royavidan/IOT-Project-study-assistor/README.md

## Study Assistor Project by : Taiyo Yemin, Maor Lisker, Roy Avidan
  
## Details about the project
 
## Folder description :
* ESP32: source code for the esp side (firmware).
* Documentation: wiring diagram + basic operating instructions
* Unit Tests: tests for individual hardware components (input / output devices)
* flutter_app : dart code for our Flutter app.
* Parameters: contains description of parameters and settings that can be modified IN YOUR CODE
* Assets: link to 3D printed parts, Audio files used in this project, Fritzing file for connection diagram (FZZ format) etc

## ESP32 SDK version used in this project: 

## Arduino/ESP32 libraries used in this project:
* Adafruit BusIO - version 1.17.4
* Adafruit GFX Library - version 1.12.6
* Adafruit SH110X - version 2.1.14
* Adafruit SSD1306 - version 2.5.17
* Adafruit_VL6180X - version 1.4.4

## Connection diagram:

## Project Poster:
 
This project is part of ICST - The Interdisciplinary Center for Smart Technologies, Taub Faculty of Computer Science, Technion
https://icst.cs.technion.ac.il/
