royavidan/IOT-Project-study-assistor/mindbox-companion-forge-main/README.md

# MindBox Companion

Web companion app for the MindBox focus device (TanStack Start + React + Supabase).

## Setup

1. Install dependencies: `npm install`
2. Copy `.env.example` to `.env` and fill in the values (Supabase URL/keys, app URL, device ingest secret).
3. Apply the database schema in the Supabase SQL Editor, in order:
   - `supabase/migrations/0001_init.sql` (tables, RLS, leaderboard RPC)
   - `supabase/migrations/0002_app_features.sql` (adaptive-coaching column + friend RPCs)
   - `supabase/migrations/0003_app_gaps.sql` (streak RPC, reviewer students, weekly share)
   - `supabase/migrations/0004_streak_access.sql` (secure streak RPC for reviewers)
   - `supabase/migrations/0005_google_oauth_profile.sql` (Google sign-in display names)
   - `supabase/migrations/0006_external_load.sql` (external load: lectures/labs → Recovery balance)
   - `supabase/migrations/0007_schedule_events.sql` (calendar: weekly classes + one-off events)
   - `supabase/migrations/0008_schedule_exams_semester.sql` (exam category + semester term)
   - `supabase/migrations/0009_schedule_subtype.sql` (lecture/tutorial/lab meeting type)

   Then reload the API cache by running `NOTIFY pgrst, 'reload schema';` once.
   The **Settings**, **Friends**, **Insights**, reviewer picker, and weekly email require `0002`–`0004`.

4. **Google sign-in:** In Supabase → **Authentication → Providers → Google**, enable Google and paste your Google Cloud **Client ID** and **Client Secret**. In Google Cloud Console, add this authorized redirect URI:
   `https://<your-project-ref>.supabase.co/auth/v1/callback`
   Also add **Redirect URLs** in Supabase → **Authentication → URL Configuration**:
   `http://localhost:8080/auth/callback` (and your production URL when deployed).
5. Start the dev server: `npm run dev` (serves `http://localhost:8080`).

## AI features (Gemini)

The **Smart (AI) study planner**, the **post-session check-in auto-replan**, and
the **daily load review** are powered by Gemini (`gemini-2.5-flash`):

1. Set `GEMINI_API_KEY` in `.env` (free key from https://aistudio.google.com/apikey)
   and `JOBS_SECRET` (any long random string), then restart the dev server.
2. Apply migrations `0020_llm_planner.sql` → `0021_session_checkin.sql` →
   `0022_device_sound_agenda.sql` → `0023_load_review.sql` in the SQL editor.
3. The daily load-review sweep is triggered by an external cron
   (`.github/workflows/load-review.yml` at the repo root — set the
   `APP_BASE_URL` + `JOBS_SECRET` repo secrets), or on demand from the
   Insights page ("Run review now").

Every assumption and threshold behind these features is documented in
[`docs/ASSUMPTIONS.md`](docs/ASSUMPTIONS.md) — read it before the demo.

## Site ↔ device features (remote control & live status)

Four features talk to the ESP32-S3 box over the ingest contract (migrations
`0024_device_commands.sql` → `0025_device_prefs_status.sql`, no new env vars):

- **Remote interface control** — the "MindBox device" card on `/settings` sets
  the box's screen theme (5 accent presets), pomodoro focus/break lengths and
  exam mode; the box picks them up on its next 60s config poll.
- **Remote commands** — the `/device` page can start/end a session, **ring the
  box** (find-my) and send a short message to its screen, with live
  Queued → Sent → Done status per command.
- **Live device status** — `/device` shows an online/last-seen indicator
  (90s threshold), battery, Wi-Fi, running firmware and the room right now
  (temperature/humidity/light/noise from the box's sensors).
- **On-device actions** — the box shows an exam badge + study streak, and after
  a finished session lets you bump homework progress from its touch screen
  (updates `/assignments` automatically).

Everything is testable without hardware — see the device-communication flags in
the simulator section below (`--config`, `--send-command`, `--ack`,
`--homework`).

## System guide (PDF)

[`docs/MindBox-System-Guide.pdf`](docs/MindBox-System-Guide.pdf) is the full
Hebrew system document (ESP32-S3 focused): every sensor's physics/wiring/driver,
the firmware architecture, the device↔server protocol, the engineering
lessons (brownout, I2C bus wars), and a **claim→live-proof playbook** for the
demo. Source chapters live in `docs/system-guide/*.html`; rebuild with
`bun run doc` (or `npx tsx scripts/build-system-doc.ts`).

## Tests

`npm run test` runs the Vitest unit suite (pure logic: Focus Load heuristic +
report/CSV serialization). `npm run test:watch` for watch mode.

> After changing **secrets** in `.env`, fully restart `npm run dev` — the dev
> server only reads `process.env` at startup.

## Device simulator

`scripts/simulator.ts` pretends to be a MindBox device so you can populate data
and exercise the app **without hardware**. It POSTs to the `/ingest/*` endpoints
using `DEVICE_INGEST_SECRET` and seeds a device owned by your app user, so the
data shows up on your dashboard/history.

**The dev server must be running first** (`npm run dev`).

```bash
# Seed a device + ~30 days of sessions, then stream telemetry (Ctrl+C to stop)
npm run simulate

# Scenarios
npm run simulate -- --offline-then-sync   # buffer sessions, then sync in one batch
npm run simulate -- --low-battery         # battery drains past 15% then 5%
npm run simulate -- --sensor-fault        # a sensor reports "invalid", state -> danger

# Handy options
npm run simulate -- --user=you@example.com  # attribute device to this user (default: first user)
npm run simulate -- --device=mindbox-sim-01 # device id
npm run simulate -- --seed-only             # seed + post sessions, then exit
npm run simulate -- --no-sessions           # telemetry only
npm run simulate -- --ticks=10 --interval=2000
```

Session IDs are deterministic (hashed from device + day + index), so the
ingestion upsert is idempotent — **re-running the simulator never creates
duplicate sessions**.

To remove simulator seed data and start with a clean dashboard:

```bash
npm run cleanup
```

Requires Node 18+ (run via `tsx`). On Node 22.18+ you can also run
`node scripts/simulator.ts` directly.
