royavidan/IOT-Project-study-assistor/Demo-Day-Pitch.md

# MindBox — Demo Day Pitch

חמש דקות, שישה שקפים, עברית.

> איך משתמשים בקובץ: זה הגיבוי הטקסטואלי של המצגת MindBox-Demo-Day-v2.pptx.
> שורות בתוך [ ] הן הערות לכם, הן לא נכנסות לשקף.

---

## שקופית 1 — הבעיה

**כותרת על השקף (הסיפור האישי של טאיו):**

> הייתי סטודנט שרוף
> עד שחשבתי לעזוב את הלימודים

**שורות (וזה לא רק אני — הנתונים):**

> 71% מהסטודנטים מדווחים על שחיקה · עלייה מ-40%
> ל-70% מאלה ששוקלים לנשור הסיבה מספר 1 היא מתח רגשי · יותר מעלות הלימודים
> ומחקרים מראים ששחיקה מנבאת ישירות כוונה לנשור
> זו לא בעיה של כוח רצון · אלא שגרה שבורה בלי הפסקות ובלי תחושת התקדמות

[פתיחה בעל פה, ~30 שניות, הסיפור שלך: ספר על תקופה אמיתית שבה נשרפת, איך זה פגע בלימודים,
ועל הרגע שבו באמת שקלת לעזוב. אל תמהר, שתיקה קצרה אחרי "לעזוב את הלימודים" עובדת. ואז:
"בדקתי, וזה לא רק אני."]
[מקורות לאימות: שחיקה 40%→71% — סקר Ohio State (Melnyk, 2021). מתח רגשי כסיבה מס' 1
לנשירה (70%) — Gallup-Lumina, State of Higher Education 2024. שחיקה מנבאת נשירה — PLOS One 2020.]
[גרף מוכן: presentation-assets/burnout-rise.png (עמודות 40% מול 71%). תמונה מומלצת: סטודנט
שחוק מול ערימת ספרים/מסך — חפשו ב-Unsplash "student burnout" / "exhausted studying".]

---

## שקופית 2 — הפתרון

**כותרת:**

> MindBox
> פוקוס בלי שחיקה

**שורות (איך זה שובר את מעגל השחיקה):**

> מחזורי עבודה והפסקה · ריכוז עמוק בלי לשרוף את עצמכם
> הקופסה מזכירה מתי לעצור · לא עוד שעות רצופות מול המסך
> רטט עדין מחזיר אתכם פנימה · במקום עוד התראה שמלחיצה
> באפליקציה רואים התקדמות אמיתית · פחות חרדת "אם בכלל הספקתי"

[הרעיון: כל פיצ'ר עונה על שורש אחר של שחיקה — עומס, חוסר הפסקות, הצפת התראות, חרדת
התקדמות. חברו חזרה לסיפור: "הקופסה הזו היא בדיוק מה שהייתי צריך אז".]
[תראו, אל תספרו: תמונה אמיתית של הקופסה + צילום מסך מהאפליקציה. אם אפשר, דמו חי של 15 שניות.]

---

## שקופית 3 — השוק

**כותרת:**

> אנשים שמתקשים להתרכז מול מסך
> וזה רק הולך וגדל

**שורות (מלמטה למעלה — שוק עולמי → ישראל → יעד ראשון):**

> בעולם · שוק כלי הפוקוס והפרודוקטיביות כ-10 מיליארד דולר וצומח כ-9% בשנה
> בישראל · כ-400 אלף סטודנטים ומיליוני עובדים שמבלים את היום מול מסך — בסיס רלוונטי של כ-800 אלף איש
> יעד ראשון · נתח של ~3% מהבסיס ≈ 24 אלף משתמשים × ₪300 ≈ כ-7 מיליון ₪ (לפני הכנסה מהאפליקציה)
> למה עכשיו · זמן הקשב הממוצע מול מסך צנח מ-2.5 דקות בשנת 2004 ל-47 שניות בשנת 2023

[נתון "למה עכשיו" הוא הנשק הסודי של השקף — הוא אמיתי, מאומת ומזעזע. אפשר לומר אותו בעל פה.]
[מקורות לאימות מול הקהל, לא על השקף:
 • סטודנטים ~401 אלף (תשפ"ד) — המועצה להשכלה גבוהה / הלמ"ס.
 • כוח עבודה ~4.7 מיליון — הבנק העולמי / הלמ"ס.
 • שוק פרודוקטיביות ~9–11 מיליארד דולר, צמיחה ~9% — Cognitive Market Research / Fortune Business Insights.
 • נתון הקשב (2.5 דק׳ → 47 שנ׳, ~23 דק׳ לחזור לריכוז) — פרופ' גלוריה מארק, UC Irvine.
 הרעיון: מספר קטן ואמיתי שנבנה מלמטה למעלה משכנע הרבה יותר מ"שוק של מיליארדים".]

---

## שקופית 4 — תחרות

**כותרת:**

> איך מתרכזים היום
> ולמה זה לא מספיק

**שורות — איך מתמודדים היום:**

> אפליקציות פוקוס חיות בטלפון · אותו מכשיר שמסיח אתכם מלכתחילה
> טיימר רגיל סופר דקות · אבל לא יודע אם באמת התרכזתם
> טלפון בחדר אחר או כוח רצון · הכי נפוץ והכי פחות מחזיק

**שורות — מה ש-MindBox עושה אחרת (וכבר עובד בקופסה):**

> קופסה על השולחן · לא עוד אפליקציה בטלפון
> קמתם לקפה? הקופסה מזהה ומשהה לבד · חזרתם והיא ממשיכה מאיפה שעצרתם · הזמן סופר ריכוז אמיתי ולא שעון קיר
> הקשב נשבר? רטט עדין על השולחן מחזיר אתכם פנימה · בלי עוד התראה ובלי מסך
> כל סשן מקבל ציון פוקוס · ובאפליקציה רואים מתי ואיפה אתם הכי חדים

[הפואנטה כאן רגשית, לא טכנית: לא עוד אפליקציה — חוויה פיזית על השולחן. בהצגה הדגישו שני רגעים
שאנשים "מרגישים": ההשהיה האוטומטית כשקמים, והרטט העדין שמחזיר. כל הפיצ'רים האלה כבר מוטמעים
ועובדים בקופסה היום — נוכחות (חיישן מרחק), רעש ותאורה, ציון פוקוס, וסנכרון לאפליקציה.]
[אל תגידו שאין לכם תחרות — זה דגל אדום. גם "לא לעשות כלום" זו תחרות, וכבר כללנו אותה.]

---

## שקופית 5 — הצוות

**כותרת:**

> בנינו את MindBox בעצמנו
> כי אנחנו חיים את הבעיה

**שורות:**

> טאיו ימין · מאור ליסקר · רועי אבידן
> טאיו נשרף בעצמו בלימודים — מכאן נולד MindBox
> בנינו הכול לבד · קופסה חיישנים ענן ואפליקציה
> אנחנו המשתמשים הראשונים · ויודעים בדיוק מה צריך לתקן

[אופציונלי: הוסיפו לכל אחד 2-3 מילות רקע (חומרה / תוכנה / עיצוב). התמקדו ב"למה אנחנו ולמה
עכשיו", לא בקורות חיים. בשלב מוקדם משקיעים באנשים יותר מבמוצר.]

---

## שקופית 6 — הבקשה

**כותרת:**

> מה אנחנו מחפשים:
> שותף ראשון שינסה את MindBox.

**שורות:**

> מי מתאים: צוות שעובד מרחוק, מרחב עבודה משותף, או קבוצת לומדים.
> מה נצטרך: בין עשרה לעשרים משתמשים, לכמה שבועות.
> מה כולם מרוויחים: הם מקבלים כלי פוקוס אמיתי, ואנחנו מקבלים משוב וסיפור הצלחה ראשון.

**משפט סיום (בעל פה, סוגר את המעגל לשקף הראשון):**

> שאף אחד לא יסיים עוד יום מול המסך בלי לדעת אם באמת עבד.

---

## לפני דמו דיי, מה להשלים

1. סיפור פתיחה (שקף 1): הכניסו רגע אמיתי משלכם אם יש.
2. צוות (שקף 5): שם או שמות, ושורת רקע אחת לכל אחד.
3. מספרי שוק (שקף 3): המספרים והמקורות כבר בפנים — רק לוודא שהם עדכניים לפני דמו דיי.
4. יצירת קשר (שקף סיום): מייל או טלפון.

## טיפים להצגה

- חמש דקות, גבול קשיח. תתאמנו בקול ותמדדו זמן.
- פשטות מנצחת בשקפים: מעט מילים, תמונה אמיתית אחת לשקף.
- 40 אחוז תוכן, 60 אחוז אתם: אנרגיה, קשר עין, טון.
