royavidan/IOT-Project-study-assistor/Documentation/connection diagram/sketch.png

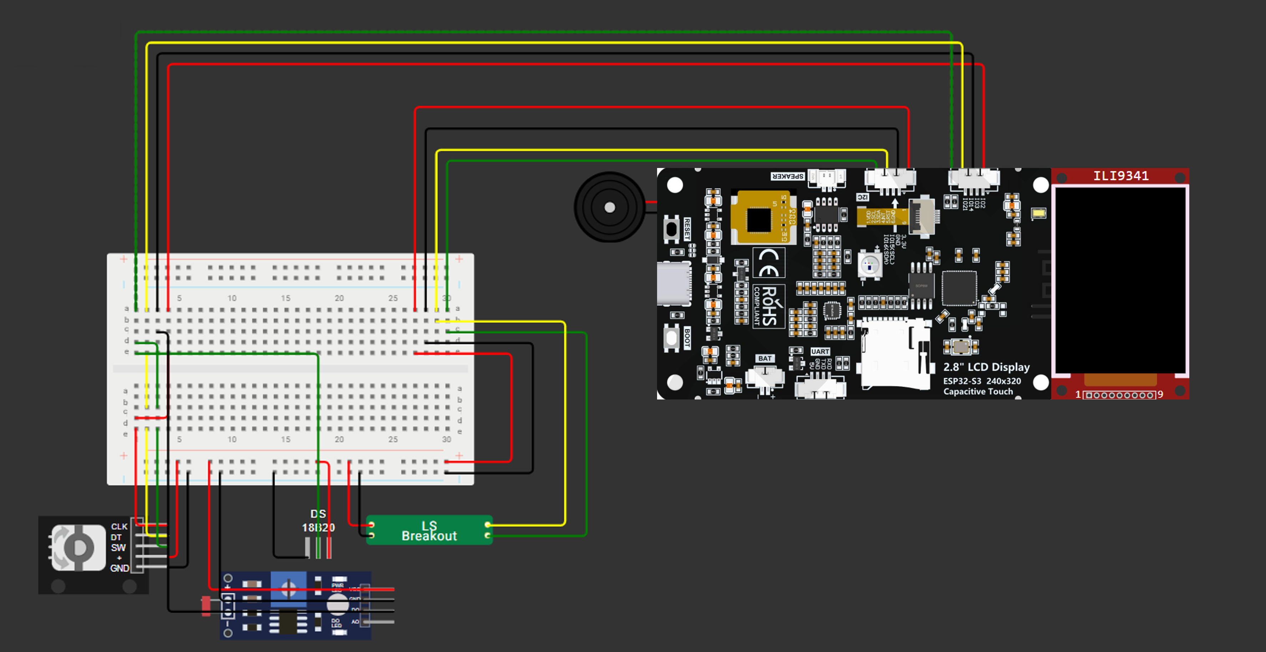
Documentation/connection diagram/sketch.png
