royavidan/IOT-Project-study-assistor/presentation-assets/burnout-rise.png

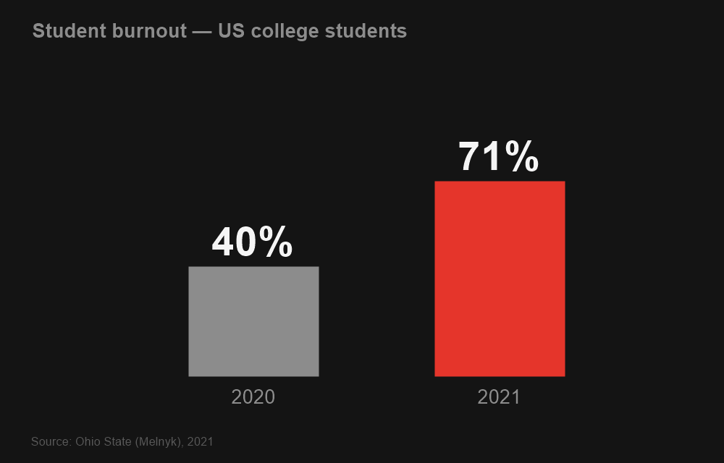
presentation-assets/burnout-rise.png
