royavidan/IOT-Project-study-assistor/presentation-assets/stress-70.png

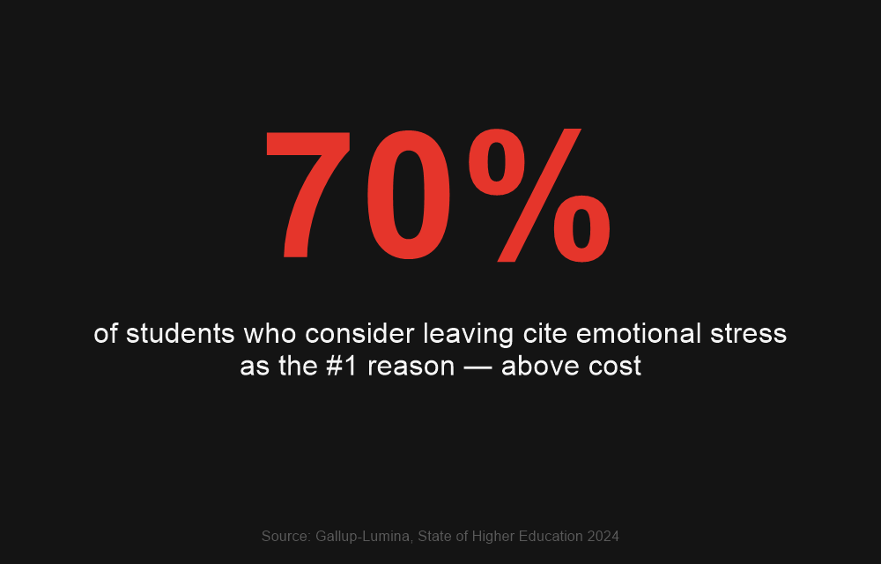
presentation-assets/stress-70.png
