royavidan/IOT-Project-study-assistor/mindbox-companion-forge-main/docs/MindBox-Submission-Guide.html

# MindBox

מדריך הגשה טכני מלא + תסריט הדגמה ל-30 דקות

פרויקט IoT · שעון פוקוס חכם על בסיס ESP32-S3
גרסת קושחה: 0.2.0-s3 · לוח: LCDWIKI ES3C28P/ES3N28P (ESP32-S3, מסך מגע 2.8")
צוות: Taiyo Yemin · Maor Lisker · Roy Avidan — Technion ICST

כל טענה חומרתית במסמך מלווה בהפניה מדויקת לקוד המקור (קובץ:שורה) ובדרך להוכיח אותה בזמן אמת מול הקהל.

# תוכן העניינים

1. הסיפור והארכיטקטורה — למה הפרויקט קיים, מה הוא, ואיך הוא בנוי
2. החומרה: הלוח, מפת הפינים המלאה והבאסים — הבנת ה-ESP32-S3 ב-100%
3. החיישנים וההתקנים — אחד-אחד — עיקרון, פרוטוקול, חיווט, דרייבר, קצב
4. ליבות ומשימות (Cores & Tasks) — מי רץ על איזו ליבה ולמה
5. למה המסך לא קורס — Single-writer sprite, DMA, וניהול זיכרון
6. תקלת הקישוריות ותיקון ה-pbuf_free — הבאג ש"אתחל את הקופסה כל כמה דקות"
7. Trade-offs ומשאבים משותפים — שיתוף IO21 (אנקודר↔טמפרטורה), באס I2C יחיד, ועוד
8. מקרי קצה וחוסן — ניתוק Wi-Fi, תקלות חיישן, שחזור I2C, brownout, offline
9. מכונת המצבים וזרימת הנתונים — 16 מצבים, מחזור חיי סשן, טלמטריה, צימוד
10. התקן ↔ ענן ↔ אתר — חוזה ה-ingest, אימות, והמסכים החיים באתר
11. דיאגנוסטיקה — איך מוכיחים כל טענה — Serial, self-test, מסך Diag
12. תסריט ההדגמה (30 דקות) + נספחים — טבלת טענה→הוכחה, run-of-show, וגיבוי סימולטור

איך לקרוא את המסמך: טקסט בעברית, אך שמות פינים, פונקציות, קבצים ומספרי-שורה נשארים באנגלית (LTR) כדי שיהיו מדויקים וניתנים לחיפוש בקוד. תיבה ירוקה (■) = "איך מוכיחים את זה"; תיבה כתומה (■) = הערה/סייג; תיבה אדומה (■) = מלכודת/כשל אמיתי שנתקלנו בו.

# 1. הסיפור והארכיטקטורה

במשפט אחד: MindBox היא קופסה פיזית על בסיס ESP32-S3 שמריצה סשני פוקוס (פומודורו), מודדת את סביבת הלימוד בזמן אמת (רעש, טמפרטורה, לחות, אור, נוכחות), ומסתנכרנת דו-כיוונית עם אפליקציית ווב — כולל עבודה מלאה גם ללא רשת. המכשיר מריץ שתי ליבות, חמישה חיישנים פעילים, מסך מגע, ושמע דו-כיווני (מיקרופון I2S + רמקול).

## 1.1 הבעיה שפתרנו

סטודנטים נכשלים לא מחוסר זמן אלא מחוסר פוקוס: הטלפון, הרעש, החדר החם, ואפס משוב על מה שבאמת קורה בזמן הלמידה. אפליקציות טיימר קיימות הן פסיביות — הן סופרות זמן אבל לא יודעות אם באמת למדת. MindBox הופכת את סביבת הלמידה למדידה: היא רואה אם אתה מול השולחן (ToF), שומעת אם החדר רועש (מיקרופון), יודעת אם חשוך או חם מדי (אור/טמפרטורה), ומחברת את כל זה ל"עומס פוקוס" (Focus Load) שמוצג בזמן אמת ונשמר לניתוח מאוחר באתר.

## 1.2 מסע ההנדסה: מ-OLED קלאסי ל-S3 עם מסך מגע

הפרויקט התחיל כקושחת ESP32 קלאסית (DOIT DevKit) עם מסך OLED קטן ואנקודר בלבד. ה"מוח" — מכונת המצבים, מחזור הסשן, והתפריטים (StateMachine / Session / Menu) — נכתב כך שהוא אגנוסטי לתצוגה: הוא מייצר ערך UiModel, והרנדרר מצייר אותו. בזכות זה הצלחנו לעשות port מלא ללוח ESP32-S3 חדש (LCDWIKI ES3C28P, מסך מגע צבעוני 2.8") כמעט בלי לגעת בלוגיקה: רק התצוגה (TFT SPI במקום OLED I2C) והקלט (מגע + אנקודר במקום אנקודר בלבד) השתנו. זהו הסיפור ההנדסי המרכזי — ארכיטקטורה נכונה מאפשרת החלפת חומרה שלמה בעלות מינימלית.

מקור: MindBox - hardware ESP32 S3 screen/MindBox/CLAUDE.md (סעיף "Context for this variant").

## 1.3 תמונת-על של המערכת

## 1.4 ששת ערוצי התקשורת

ערוץ | Route | כיוון | קצב | מה עובר
סשנים | POST /ingest/sessions | מכשיר → שרת | בסיום סשן (+ תור offline) | סשן מלא: זמנים, מצב, אגרגטים סביבתיים, דגימות לדקה
טלמטריה | POST /ingest/telemetry | מכשיר → שרת | כל 30 שניות (פעימת-לב) | מצב, סוללה, WiFi RSSI, תקינות חיישנים, טמפ'/לחות/אור/רעש חיים, גרסת קושחה
קונפיגורציה | GET /ingest/config | שרת → מכשיר | כל 60 שניות (3–5 בזמן צימוד) | הגדרות, לו"ז יומי+שבועי, ערכת צבעים, זמני פומודורו, מצב מבחן, סטריק, שיעורי בית, פקודה מרחוק
צימוד | POST /ingest/pairing | מכשיר → שרת | לפי דרישה | קוד 6 ספרות שהמכשיר מציג (תוקף 15 דק')
שחרור | POST /ingest/unpair | מכשיר → שרת | לפי דרישה | שחרור בעלות מהמכשיר ("Sign out")
שיעורי בית | POST /ingest/homework | מכשיר → שרת | לפי פעולה במסך המגע | עדכון אחוז התקדמות מטלה מהמכשיר

כל הערוצים מאומתים ב-header x-device-secret (השוואה בזמן-קבוע נגד timing attacks). הכתיבות רצות דרך service-role client (עוקף RLS), אך הבעלות נבדקת מחדש בקוד לכל פעולה רגישה. src/features/device/ingest.server.ts · MindBox/src/Cloud.cpp

הוכחה מהירה שהכול חי: פותחים את /device באתר ליד המכשיר — נקודת ה-Online, הסוללה, עוצמת ה-Wi-Fi ותנאי החדר ("Room right now") מתעדכנים מכל פעימת טלמטריה (30 שניות מהמכשיר, רענון UI כל 10 שניות). מכבים את המכשיר — תוך 90 שניות החיווי הופך ל-"Last seen". ההרחבה המלאה בפרק 12.

# 2. החומרה: הלוח, מפת הפינים המלאה והבאסים

זהו פרק ה"חומרה ב-100%". הלוח הוא LCDWIKI ES3C28P/ES3N28P — לוח מוכן עם ESP32-S3, מסך ILI9341 בגודל 2.8", בקר מגע FT6336, וקודק שמע ES8311 — שאליו חיברנו ידנית חיישנים חיצוניים. מקור-האמת היחיד למיפוי הפינים הוא הקובץ src/config.h (כל מודול כולל אותו; שום מקום אחר לא מקודד פין). כל המספרים למטה אומתו ישירות מולו.

## 2.1 ה-SoC: למה ESP32-S3

ה-ESP32-S3 הוא dual-core (שתי ליבות Xtensa LX7 @240MHz), עם Wi-Fi 2.4GHz, PSRAM חיצוני, ו-esp_timer/FreeRTOS מובנים. שתי הליבות הן הבסיס לכל הארכיטקטורה שלנו (פרק 4): ליבה אחת לממשק ולחיישנים, השנייה לרשת ולשמע. ה-PSRAM (במצב OPI) קריטי — בלעדיו ה-sprite של המסך נופל ל-draw ישיר מהבהב (פרק 5).

SoC: ESP32-S3 (dual-core LX7) Flash: 16 MB PSRAM: OPI Partition: Huge APP (3MB / 1MB SPIFFS) USB: CDC On Boot Serial: 115200

הגדרות ה-build הן מדויקות ונדרשות: MindBox/CLAUDE.md → "Build / flash". מחיצת ה-SPIFFS היא המקום שבו LittleFS מרכיב את תור ה-offline (פרק 8).

## 2.2 מפת הפינים המלאה (מאומתת מול config.h)

תת-מערכת | רכיב | פרוטוקול | פינים (GPIO) | config.h
תצוגה | ILI9341 TFT 240×320 (סובב ל-320×240) | SPI (SPI2_HOST) @40MHz | SCLK=12, MOSI=11, MISO=13, DC=46, CS=10, RST=-1 (tied to EN), BL=45 (PWM) | L43-55
מגע | FT6336 קיבולי | I2C 0x38 @400kHz | SDA=16, SCL=15, INT=17, RST=18 | L64-72
נוכחות | VL53L1X ToF (על אותו באס) | I2C 0x29 | SDA=16, SCL=15 (no XSHUT) | L115-116
שמע — מיקרופון | ES8311 MEMS mic | I2S | DIN=6 (mic ADC), BCLK=5, LRCK=7, MCLK=4 | L82-88
שמע — רמקול | ES8311 DAC → FM8002E amp | I2S | DOUT=8, AMP_EN=1 (active-low) | L84,89
שמע — בקרת קודק | ES8311 control | soft-I2C 0x18 (boot-only) | SDA=16, SCL=15 | L90-92
אנקודר | KY-040 rotary | digital A/B (ISR) | CLK=IO2, DT=IO14, SW=-1 | L112-114
כפתור צד | לחצן ציר האנקודר | digital (active-low) | IO21 (משותף עם DHT11) | L117
כפתור BOOT | מובנה בלוח | digital | IO0 | L119
טמפ'/לחות | DHT11 | 1-wire (bit-bang) | DATA=IO21 (+ pull-up 4.7k–10k) | L122
אור | KY-018 photoresistor | analog ADC1 12-bit | AO=IO3 | L123

### פינים מובנים בלוח שאיננו מנצלים

רכיב | פינים | סטטוס
RGB LED מובנה (WS2812-style) | IO42 | לא מונע ע"י הקושחה
מדידת סוללה (ADC) | IO9 | HAS_BATTERY=0 — מוחזר −1
חריץ SD-card | 38/40/39/41/48/47 | לא בשימוש (משתמשים ב-LittleFS על ה-flash הפנימי)
UART0 / USB | TX=43, RX=44 / USB=19,20 | מובנה

## 2.3 האילוץ המגדיר: רק 4 פינים חשופים

זו הנקודה שממנה נגזרות כל ההחלטות בפרק 7. מעבר לפינים המובנים של המסך/מגע/שמע, הלוח חושף ב-header ארבעה פינים בלבד: IO2, IO3, IO14, IO21. חיברנו חמישה חיישנים חיצוניים לארבעה פינים, אז חלק חייבים לחלוק פין. ההקצאה: IO2/IO14 = אנקודר (CLK/DT), IO3 = אור, ו-IO21 מוקצה פעמיים — DATA של ה-DHT11 וגם לחצן ציר האנקודר. אין פין חמישי. MindBox/docs/WIRING.md §1 · config.h L108-117

## 2.4 מה חי ומה מושבת (דגלי HAS_*)

הקושחה בנויה מדגלי-קומפילציה. הדגלים הם ה-SSOT ל"מה מחובר" — בודקים אותם לפני שמניחים שרכיב קיים.

דגל | ערך | משמעות
USE_TOUCH | 1 | ניווט במסך מגע FT6336
HAS_ENCODER | 1 | אנקודר KY-040 (מתקיים במקביל למגע)
HAS_PRESENCE | 1 | ToF VL53L1X על באס המגע (single master)
HAS_I2S_MIC | 1 | מיקרופון ES8311 I2S — המיקרופון היחיד בלוח, DIN=IO6
HAS_SPEAKER | 1 | רמקול ES8311 + מגבר FM8002E, DOUT=IO8
HAS_LIGHT | 1 | חיישן אור KY-018 → IO3 (ADC1)
HAS_TEMP | 1 | DHT11 טמפ'/לחות → IO21
ENABLE_WIFI / ENABLE_CLOUD | 1 | Wi-Fi + NTP + העלאת ingest / משיכת config
HAS_MIC | 0 | נתיב מיקרופון אנלוגי ישן — נזנח (המיקרופון דיגיטלי)
HAS_HAPTIC | 0 | מנוע רטט — הוסר
HAS_LED_RING / HAS_BATTERY | 0 | טבעת LED חיצונית / מדידת סוללה — מושבתים

סייג לתיעוד: בתיקיית ה-docs יש שני קבצים ישנים חלקית — docs/HARDWARE.md §2 מפרט את הפינים של הלוח הקלאסי (OLED, לא S3), ו-docs/WIRING.md ישן לגבי המיקרופון/רמקול. מקור-האמת הוא תמיד config.h (וה-CLAUDE.md של הקושחה). המספרים במסמך זה נלקחו מ-config.h.

איך מוכיחים את מפת הפינים: ב-boot הקושחה מריצה selfTest() שמדפיס ל-Serial (115200) סריקת I2C — צריכים להופיע שתי כתובות: 0x38 (מגע) ו-0x29 (ToF) — הוכחה ששני התקנים חיים על אותו באס. באותו self-test מודפסים גם שם דרייבר התצוגה (ILI9341), מצב ה-PSRAM וגודלו, וה-heap. Diagnostics.cpp selfTest()

# 3. החיישנים וההתקנים — אחד-אחד

לכל רכיב: העיקרון הפיזיקלי, הפרוטוקול, החיווט, קצב הדגימה, קובץ הדרייבר, ואיך מוכיחים שהוא חי. חמישה חיישני קלט (מגע, ToF, מיקרופון, אור, טמפ'/לחות), ושלושה התקני קלט/פלט (מסך, אנקודר, כפתור) + רמקול.

## 3.1 מסך ILI9341 (SPI)

פרוטוקול: SPI2 @40MHz דרייבר: LovyanGFX DMA: SPI_DMA_CH_AUTO רזולוציה: 320×240 (landscape) תאורה אחורית: PWM (IO45)

המסך מנוהל דרך LovyanGFX — מחלקת התקן LGFX_Hosyond_S3_28 עם bus SPI, פאנל ILI9341 ותאורת PWM. הכתיבה עוברת ב-DMA (לא byte-banging), מה שמקצר push של פריים מלא מ-~80ms ל-~30ms. הרנדור עצמו (sprite יחיד, throttle, מדוע אין קריסה) מוסבר בפרק 5. Panel.cpp L5-46, L14-16

## 3.2 מגע FT6336 (I2C קיבולי)

פרוטוקול: I2C 0x38 @400kHz דרייבר: Wire ידני (Touch.cpp) כיול: 4 פינות ב-NVS long-press: 500ms

בקר מגע קיבולי הנקרא ישירות מעל Arduino Wire (לא דרך דרייבר המגע של LovyanGFX, שהוסר). המגע הוא "קליק", לא בורר-מיקום: איפה נוגעים לא משנה — נגיעה קצרה = בחירה בשורה המודגשת, לחיצה ארוכה = חזרה, החלקה אנכית = הזזת ההדגשה (כמו detent של אנקודר). הגישה הישנה (rowHitTest) הוסרה כי כיול לא מדויק נחת על השורה הלא-נכונה. הכיול הוא מפה לינארית raw→screen שנלמדת ב-4 פינות ונשמרת ב-NVS (מזהה swap/mirror לכל rotation); לחיצה ארוכה על BOOT מריצה כיול מחדש. Touch.cpp L45-59, L73-163

## 3.3 נוכחות VL53L1X (חיישן מרחק Time-of-Flight)

פרוטוקול: I2C 0x29 (באס משותף) עיקרון: זמן-מעוף של לייזר קצב: 500ms (TOF_POLL_MS) סף נוכחות: 700mm

ה-VL53L1X מודד מרחק ע"י מדידת זמן המעוף של פולס אור לייזר עד המשתמש וחזרה. מתחת ל-700mm (PRESENCE_NEAR_MM) נחשב "נוכח". קריאות לא-סבירות נדחות (d>0 && d<4000). בזמן סשן, התרחקות מפעילה השהיה אוטומטית אחרי 30 שניות והפסקה אחרי 5 דקות. אם ה-ToF נכשל באתחול, המערכת יורדת בחן ל"תמיד נוכח". Sensors.cpp L165-168, L222-233

איך מוכיחים: Serial m (מוניטור 1Hz) מציג dist=Nmm שמשתנה חי כשמזיזים יד קדימה/אחורה. בזמן סשן — התרחקות מציגה חיווי Away על הטיימר.

## 3.4 מיקרופון ES8311 (I2S דיגיטלי) — DIN=IO6

פרוטוקול: I2S 16kHz 16-bit mono עיבוד: AC-RMS ~1Hz (DC מוסר) DIN: IO6 (ADC של הקודק) full-scale: AUDIO_MIC_RMS_FULL=1000

זה המיקרופון היחיד בלוח — MEMS דיגיטלי דרך קודק ES8311 על I2S. משימה בליבה 0 קוראת פריימים, מסירה את רכיב ה-DC ומחשבת AC-RMS מתגלגל ב-~1Hz כ-micLevel(), שממנו נגזר "רעש" (0..1) ו-dB משוער: dB_SPL = 20·log10(acRms/32768) + 116. הרעש מזין את צינור ההפרעות/הטלמטריה. עוצמת פלט נשלטת ב-סקיילינג תוכנה של הדגימות, לא בכתיבה חוזרת לקודק. Audio.cpp L205-257 · config.h L82-97

באג אמיתי שפתרנו (2 באגים): (1) ה-DIN/DOUT היו מוחלפים — קראנו את קו הרמקול הלא-מונע ב-IO8 וקיבלנו קבוע 0xFFFF/−1. התיקון: DIN=IO6 (מיקרופון), DOUT=IO8 (רמקול). (2) הקודק החזיר אפסים עד שכתבנו לרגיסטר ה-ADC clock (reg 0x01 = 0x3F). config.h L84-88 · Audio.cpp L83-123

איך מוכיחים: Serial a (audio probe) מדפיס ACK של הקודק ב-boot + raw I2S min/max/RMS. מחיאת כף/דיבור ⇒ ה-RMS קופץ. במסך Diag מופיע 8311:ACK rdy:1 pp:<n> שבו ה-pp (peak-to-peak של השנייה האחרונה) קופץ כשמדברים.

## 3.5 רמקול + מגבר FM8002E — DOUT=IO8, AMP_EN=IO1

ה-DAC של אותו קודק ES8311 מוציא I2S ל-IO8, מוגבר ע"י FM8002E (enable ב-IO1, active-low). משמש לצלילי מחזור-חיים (start/pause/resume/complete) ולצלצול "find-my". Sound.* הוא שכבת מחזור-החיים שמכניסה צלילים לתור לפי הגדרות/שעות שקט. Audio.cpp L246-251 · Sound.cpp

## 3.6 אנקודר KY-040 (סיבוב) — CLK=IO2, DT=IO14

עיקרון: quadrature A/B קריאה: ISR (IRAM_ATTR) ספרייה: AiEsp32RotaryEncoder מתח: 3V3 (לא 5V)

סיבוב הכפתור מזיז את סמן התפריט. הקריאה היא מונחית-פסיקות (IRAM_ATTR isr()) על פינים נפרדים לגמרי (IO2/IO14), עם delta מסומן (כך שסיבובים מהירים לא נופלים), clamped ל-±20 detents. חשוב: לחצן הציר של האנקודר לא נקרא דרך הספרייה (PIN_ENC_SW=-1), כי הפונקציה שלה עושה busy-wait ~330ms ותוקעת את הלולאה — הוא מחווט ל-IO21 ונקרא כ"כפתור צד" (3.7). Inputs.cpp L42-44, L66-73 · config.h L112-114

## 3.7 כפתור צד (לחצן ציר האנקודר) — IO21

לחצן tact פשוט (active-low, INPUT_PULLUP), חולק את IO21 עם ה-DHT11. debounce 50ms; נגיעה קצרה = בחירה, החזקה ≥500ms = חזרה. פין שנמצא תקוע-LOW ב-boot נחשב מחווט-שגוי ומתעלמים ממנו (sideFault()). איך השיתוף עם ה-DHT11 עובד — פרק 7. Inputs.cpp L100-129

## 3.8 טמפרטורה ולחות DHT11 — IO21 (משותף)

פרוטוקול: 1-wire (bit-bang) קצב מינ': 2000ms warmup: 5s טווח תקף: −20..60°C

DHT11 מוסר טמפרטורה ולחות בפרוטוקול חד-חוטי (bit-bang). נדרש pull-up 4.7k–10k ל-3V3 — שגם מחזיק את קו הכפתור (active-low) גבוה במנוחה. קריאה שנכשלת (NaN) שומרת את הערך האחרון הטוב; ערכים מחוץ לטווח נחתכים. Sensors.cpp L51-80 · config.h L122,166

איך מוכיחים: נשיפה חמה על ה-DHT11 ⇒ הטמפ' עולה ב-Serial/Diag תוך שניות, וב-"Room right now" באתר בפעימה הבאה.

## 3.9 אור KY-018 (photoresistor אנלוגי) — IO3 (ADC1)

פוטו-רזיסטור על ADC1 12-bit. חלון של ~1Hz מחשב "lux" ושונות (variance). ה-AO עולה בחושך (ה-LDR ברגל התחתונה של המחלק), אז הופכים אותו (LIGHT_RAW_DARK_HIGH) כדי ש-lux יעקוב אחרי בהירות. משמש לבהירות מסך אוטומטית. Sensors.cpp L90-106 · config.h L123,159-164

איך מוכיחים: מכסים את החיישן ביד ⇒ ה-lux צונח ב-Diag והמסך מתעמעם פיזית.

למה ADC1 דווקא: ב-ESP32-S3 רק GPIO 1–10 הם ADC1, ו-ADC2 מתנגש עם ה-Wi-Fi. IO2 ו-IO3 הם הפינים האנלוגיים היחידים ב-header — לכן חיישן האור על IO3. docs/WIRING.md §5

# 4. ליבות ומשימות (Cores & Tasks)

ה-ESP32-S3 הוא dual-core, ואנחנו מנצלים את זה במכוון: ליבה 1 מריצה את הממשק, מכונת המצבים והחיישנים; ליבה 0 מריצה את הרשת ואת השמע. בנוסף רץ טיימר חומרה (esp_timer) של 10ms לספירת הסשן. הפרדה זו היא הסיבה שהמסך נשאר חלק גם כשה-Wi-Fi תקוע על בקשת HTTP איטית.

## 4.1 שלושת ההקשרים + טיימר החומרה

הקשר ריצה | Core | Priority / Stack | מה עושה | מקור
Arduino loop() | 1 | Arduino default | קלט → FSM → רנדור + חיישנים; מזין את ה-watchdog כל ~1ms | MindBox.ino L159-167
משימת רשת "net" | 0 | prio 1 · 16384B | Wi-Fi/HTTP: telemetry POST, config GET, ניקוז תור העלאה, צימוד | Cloud.cpp L1153, L971-1137
משימת שמע "audio" | 0 | prio 5 · 4096B | קריאת I2S מהמיקרופון → RMS; ניגון צלילים לרמקול | Audio.cpp L325, L205-257
טיימר סשן esp_timer | — | 10ms periodic | מוריד את הזמן הנותר בסשן; צובר זמן-היעדרות | Session.cpp L28-53

אלו כל ה-tasks — חיפוש xTaskCreatePinnedToCore על כל ה-sketch מחזיר בדיוק שתי תוצאות (Cloud.cpp, Audio.cpp). אין tasks נסתרים.

## 4.2 חלוקת העבודה בין הליבות

## 4.3 למה ההפרדה קריטית

בקשת HTTP על arduino-esp32 יכולה לחסום ~18-20 שניות ב-worst case (socket חצי-פתוח), וקריאת I2S מהמיקרופון חוסמת מטבעה. אם היו רצים על ליבת הממשק — המסך היה קופא והמגע לא היה מגיב. בכך שהם על ליבה 0, ליבה 1 ממשיכה לצייר ולקרוא מגע בלי הפרעה. יתרה מזו, כל קריאות ה-WiFi.* מרוכזות במשימת הרשת — מוטציה של הרדיו מליבה אחרת גורמת ל-panic (LoadProhibited), אז ה-UI קורא רק snapshot מוקּאש של SSID/IP. config.h L230-233 · Cloud.cpp L34-36, L974-987

## 4.4 טיימר החומרה: למה הסשן לא מפספס זמן

ספירת הזמן של הסשן לא תלויה בלולאה הראשית. היא רצה על esp_timer תקופתי של 10ms (onClockTimer) שמוריד את הזמן הנותר וצובר זמן-היעדרות. כך, גם אם הלולאה הראשית נתקעת רגע (רנדור כבד, קריאת חיישן), שעון הסשן מדויק ולא מדלג. זה גם מה שמאפשר ספירה נכונה גם כשאין רשת בכלל. Session.cpp L28-53 · config.h L181

## 4.5 סדר האתחול (boot order) ושיתוף מצב

ב-setup() הסדר מכוון: Storage → Audio (לפני Display!) → Display/Panel → Theme → Sound → Inputs → Sensors → UploadQueue → Cloud → StateMachine → זריעת watchdog. ה-Audio חייב לרוץ ראשון כי הוא מאתחל את הקודק ES8311 ב-soft-I2C על פיני המגע (IO16/15) — לפני ש-LovyanGFX/המגע תופסים את הבאס. שיתוף המצב בין הליבות נעשה דרך shims בטוחי-thread + mutex רקורסיבי של NVS ב-Storage. MindBox.ino L66-134 · MindBox/CLAUDE.md → Threading

איך מוכיחים את המבנה הדו-ליבתי חי: מריצים סשן ובמקביל מנתקים את ה-Wi-Fi (הרשת על ליבה 0 תיכנס ל-retry) — המסך והמגע ממשיכים לעבוד חלק וספירת הסשן ממשיכה מדויק. ב-Serial המוניטור (m) מראה את הזמן יורד גם כשה-Wi-Fi מציג off.

# 5. למה המסך לא קורס (ולא נקרע)

מסך שמצויר משתי ליבות במקביל נקרע (tearing) וקורס (race על ה-SPI). הפתרון שלנו הוא משמעת כותב-יחיד: רק ליבה 1 מציירת, לתוך sprite אחד מחוץ-למסך, ואז blit יחיד ב-DMA. בגלל זה לא צריך mutex למסך בכלל — אין למי להתחרות. בנוסף, ה-sprite נשמר ב-8bpp ב-RAM הפנימי כדי לפנות זיכרון ל-Wi-Fi.

## 5.1 כותב יחיד — הסיבה שאין קריסה

כל הציור עובר דרך StateMachine::tick(), שהוא הקורא היחיד לנתיב Display::* / Panel::push(), והוא רץ ב-loop() על ליבה 1 בלבד. משימות הרשת והשמע (ליבה 0) אף פעם לא נוגעות במסך או ב-SPI. מכיוון שיש כותב יחיד — אין race, ולכן אין צורך ב-mutex לתצוגה. (לשם השוואה: באס ה-I2C וה-NVS כן נגישים משתי הליבות, ולכן לכל אחד יש mutex — ראו פרקים 7 ו-8.) StateMachine.cpp L1425-1500

## 5.2 Sprite יחיד + blit ב-DMA = אפס tearing

הכול מצויר לתוך sprite אחד בגודל מסך מלא (LGFX_Sprite spr) דרך Panel::canvas(), ואז מוטבע פעם אחת עם spr.pushSprite(0,0) ב-DMA. הרכבה-מחוץ-למסך ואז blit-יחיד פירושה שהמשתמש אף פעם לא רואה פריים חלקי — אין הבהוב ואין קריעה. Panel.cpp L49, L94-98

## 5.3 8bpp ב-RAM הפנימי — המיטיגציה נגד OOM

ה-sprite מוגדר ב-8 סיביות לפיקסל (RGB332) במקום 16 — זה חוצה את הבאפר מ-~150KB ל-~75KB, ומפנה ~75KB של RAM פנימי ל-stack של ה-Wi-Fi/HTTP שקודם היה מרוקן את ה-heap וגורם ל-panic מסוג OOM. הוא נשמר במכוון ב-RAM הפנימי (setPsram(false)) כי sprite ב-PSRAM איטי פי ~10; רק אם ה-alloc הפנימי נכשל יש נפילה ל-PSRAM. Panel.cpp L70-88

Trade-off מודע: 8bpp = 256 צבעים במקום 65K. ויתרנו על עומק צבע כדי לשמור על יציבות הרשת ומהירות רנדור. עבור ממשק עם כמה צבעי accent — הפשרה בלתי-מורגשת, והרווח (יציבות) עצום. (עוד על זה בפרק 7.)

## 5.4 Redraw מווסת (throttle)

לא מציירים כל לולאה. דגל s_uiDirty + renderPeriodMs()=200ms מגבילים רנדור כללי ל-~5 פריימים לשנייה, והטיימר הרץ מתעדכן ב-1Hz. פחות ציור = פחות עומס SPI, פחות חום, פחות סיכון להרעיב את שאר המערכת. StateMachine.cpp L137-146

## 5.5 Watchdog — רשת ביטחון אחרונה

אם משהו בכל זאת נתקע, ה-Task Watchdog (WDT_TIMEOUT_MS=30000, trigger_panic=true) מאתחל את הקופסה במקום להשאיר אותה תקועה. הוא מוזן מהלולאה כל ~1ms, וגם ממשימת הרשת בכל pass וסביב כל קריאת HTTP. ה-30s (במקום 15s) מכוון: קריאת HTTP חוסמת יכולה להימשך ~18-20s, וה-WDT חייב "לחכות אותה" כדי שבקשה אחת ביש-מזל לא תאתחל את הקופסה. MindBox.ino L128-133 · config.h L230-234

איך מוכיחים שאין קריסה תחת עומס: מריצים סשן (רנדור טיימר 1Hz) + מחוללים תעבורת רשת (פעימות טלמטריה כל 30s, משיכת config) + מדברים למיקרופון (עומס I2S על ליבה 0) בו-זמנית. המסך נשאר חלק, אין הבהוב, המגע מגיב. ה-self-test ב-boot מדפיס את מצב ה-render (sprite-internal) ואת גודל ה-heap הפנוי — עדות שה-sprite אכן ב-RAM פנימי ושנשאר זיכרון לרשת.

# 6. תקלת הקישוריות ותיקון ה-pbuf_free

הבאג: הקופסה התאתחלה "כל כמה דקות" — אבל רק כשהיא מחוברת ל-Wi-Fi. זה היה ה-bug ההנדסי הקשה ביותר בפרויקט. השורש: assertion של מחסנית ה-רשת lwIP — assert failed: pbuf_free ... p->ref > 0 — שחרור-כפול (double-free) של buffer רשת. התיקון הוא מחסנית של תשעה שינויים, שכולם נועדו לסגור את חלון ה-race של שחרור-הכפול.

## 6.1 מה קרה בפועל

כל פתיחה וסגירה של socket TCP מקצה ומשחררת pbuf-ים. כאשר שני שחקנים (משימת הרשת שלנו + משימת האירועים הפנימית של ה-Wi-Fi, או ה-thread של SNTP) נגעו במחסנית ה-רשת בו-זמנית, אותו buffer שוחרר פעמיים — וה-assert הפיל את הצ'יפ. תסמין קלאסי: יציב לגמרי במצב offline, מתאתחל מחזורית רק כשמחובר. Cloud.cpp L86-91

## 6.2 מחסנית התיקון (9 שינויים)

# | השינוי | למה זה עוזר | מקור

1 | Socket keep-alive: HTTPClient + WiFiClient משותפים, ממוחזרים בכל קריאות ה-/ingest/* עם setReuse(true); http.end() משאיר את ה-socket פתוח | פירוק ה-TCP הוא בדיוק המקום שבו חי השחרור-הכפול; מיחזור מוריד ~2 sockets/דקה לכמעט-אפס | Cloud.cpp L106-124, L168-180
2 | autoReconnect מושבת במכוון + reconnect ידני מסונכרן על משימת הרשת (manageWifi() כל 15s) | auto-reconnect רץ ב-EVENT task נפרד ומתאסס מחדש במקביל ל-socket פעיל → חלון double-free בין שחקנים | Cloud.cpp L982-985, L936-941
3 | Settle gate של 500ms לפני הבקשה הראשונה אחרי חיבור | מפריד את הקמת ה-SNTP/DNS מה-pass של ה-TCP connect הראשון | Cloud.cpp L1101, L934
4 | SNTP capped ל-12 שעות + sntp_restart() | re-sync ברירת-מחדל (~1h) פותח socket UDP/DNS על ה-tcpip thread באמצע HTTP → אותו double-free | Cloud.cpp L947-954
5 | בקשת HTTP אחת ל-pass (שרשרת else-if) | מונע ערימה של כמה stalls של ~18-20s בתוך חלון WDT יחיד | Cloud.cpp L1102-1134
6 | Coalescing של פעימות-מעבר: TELEMETRY_MIN_GAP_MS=3000 | רצף pause→resume→skip מהיר מתכווץ ל-POST אחד במקום סדרה של sockets | config.h L177-180
7 | vTaskDelay(20ms) אחרי כל בקשה | נותן ל-lwIP לעשות housekeeping ל-pbuf | Cloud.cpp L185-187
8 | כל WiFi.* מרוכז בליבה 0; SSID/IP ב-snapshot ל-UI | מוטציה של הרדיו מליבה אחרת גורמת panic (LoadProhibited) | Cloud.cpp L34-36, L974-987
9 | Modem-sleep כבוי (WIFI_PS_NONE) | שומר על הקישור יציב כדי ש-HTTP תקופתי לא ייתקע ויפיל את ה-WDT | config.h L196-200

## 6.3 הלקח: לא autoReconnect

נקודה חשובה למי שיקרא את הקוד: אינטואיטיבית היינו מצפים ש"החיבור נופל" נפתר ע"י WiFi.setAutoReconnect(true). אצלנו זה בדיוק מה שהשבתנו. auto-reconnect הוא בעצמו מקור הבעיה — הוא מריץ re-association ב-thread נפרד שמתנגש עם ה-socket הפעיל שלנו. במקומו אנחנו מסנכרנים את ה-reconnect ידנית על משימת הרשת (שחקן אחד בכל רגע). כך מתארים את התיקון: keep-alive של ה-socket + reconnect מסונכרן — לא autoReconnect. Cloud.cpp L982-985

איך מוכיחים שהתיקון עובד: משאירים את המכשיר מחובר ל-Wi-Fi ורצים לאורך זמן — הוא לא מתאתחל (לפני התיקון: אתחול מחזורי). ב-Serial, סביב חיבור, מודפס ה-heap הפנוי + הבלוק הגדול ביותר, וכל ~30s המשימה מדפיסה מדדי heap — יציבים לאורך זמן, בלי דליפה. אם רוצים להראות את סיבת האיפוס, ה-self-test ב-boot מדפיס אותה (למשל task-wdt מול brownout מול panic).

# 7. Trade-offs ומשאבים משותפים

כל פרויקט חומרה אמיתי הוא סדרת פשרות. הפרק הזה מרכז את ההחלטות שקיבלנו במודע — הבולטת שבהן היא שלחצן ציר האנקודר וחיישן הטמפרטורה DHT11 חולקים פין GPIO אחד (IO21) — ומסביר בדיוק מה חולק מה, למה זה בטוח חשמלית, ואיך התוכנה מונעת התנגשות.

## 7.1 השיתוף המרכזי: IO21 = כפתור האנקודר + טמפרטורה

כמו שראינו בפרק 2, הלוח חושף רק 4 פינים (IO2, IO3, IO14, IO21). חיברנו חמישה חיישנים, אז IO21 מוקצה פעמיים: קו ה-DATA של ה-DHT11 (PIN_DHT11=21) וגם לחצן ציר האנקודר (PIN_BUTTON=21). config.h L117, L122

### מה בדיוק חולק — ומה לא

חולק: רק הפין הדיגיטלי הפיזי. לא חולק: פסיקה (interrupt), ולא טיימר. סיבוב האנקודר (CLK=IO2, DT=IO14) הוא מונחה-פסיקות על פינים נפרדים לגמרי — אין התנגשות בין ה-ISR של הסיבוב לבין ה-timing של ה-1-wire של ה-DHT.

### למה זה בטוח חשמלית

ה-DHT11 דורש pull-up של 4.7k–10k ל-3V3 על קו ה-DATA. ה-pull-up הזה מחזיק את IO21 גבוה במנוחה — וזה בדיוק מה שכפתור active-low ב-INPUT_PULLUP צריך. שני השימושים "מסכימים" על מצב-המנוחה של הקו, אז הם דרים בכפיפה אחת בלי רכיב נוסף. config.h L117 · Inputs.cpp L58-59

### למה אין התנגשות בתוכנה

לחצן הציר לא נקרא דרך ספריית האנקודר (PIN_ENC_SW=-1) — הפונקציה שלה עושה busy-wait של ~330ms ותוקעת את הלולאה. במקום זה הוא נדגם תוכנתית ב-pollSideButton עם digitalRead(), וה-DHT11 נקרא ב-bit-bang. שניהם polled/bit-banged, ואף פעם לא רצים בו-זמנית. וכדי לסגור את הפינה האחרונה: כשמחזיקים את הכפתור (הקו נמשך LOW), קריאת DHT הייתה נכשלת וגם מבלבלת את החיישן — אז הקוד פשוט מדלג על הקריאה ושומר את הערך האחרון:

// Sensors.cpp — refreshDht()
// IO21 shared with the encoder SW; a held line would fail the DHT read.
if (digitalRead(PIN_DHT11) == LOW) return s_tempOk;   // keep last value

ה-tick הרקעי (כל 2s) אף פעם לא חוסם ולא עושה retry; רק הנתיב הא-סינכרוני לפי-דרישה עושה retry עם השהיית 60ms. כך קצב דגימת הכפתור לעולם לא נפגע מקריאת DHT. Sensors.cpp L54-62

נקודה יפה להצגה: בקושחה הקלאסית (הלוח הישן) האנקודר והטמפרטורה לא חולקים פין — שם CLK=18/DT=19/SW=23 וה-DHT על 26, כולם נפרדים. השיתוף הוא תוצאה ייחודית של לוח ה-S3 שחושף רק 4 פינים. זה ממחיש שהפשרה נבעה מאילוץ חומרתי אמיתי, לא מבחירה שרירותית. MindBox - hardware/MindBox/config.h L22-24,35

## 7.2 באס I2C יחיד: מגע + ToF (+ קודק) על master אחד

FT6336 (0x38), VL53L1X (0x29) — ובזמן boot גם ES8311 (0x18) — כולם על Arduino Wire יחיד (SDA=16, SCL=15). הם מסתדרים בתור (serialize) כי שניהם נקראים רק מלולאת ליבה 1 — אין master שני ואין החלפת-פדים. למה זה חשוב: הגישה הקודמת (שני masters עם pad-swap) הרגה את המגע. הקודק נכתב רק ב-boot ב-soft-I2C לפני שהמגע תופס את הבאס, ואז משוחרר; בזמן ריצה השמע הוא I2S בלבד. config.h L31, L76-92 · Sensors.cpp L7-9

## 7.3 פשרות נוספות שקיבלנו במודע

הפשרה | ויתרנו על | קיבלנו
Sprite ב-8bpp (RGB332) | עומק צבע (256 במקום 65K) | ~75KB RAM פנוי ל-Wi-Fi — יציבות מול קריסות OOM (פרק 5)
Sprite ב-RAM פנימי ולא PSRAM | קצת מה-RAM הפנימי היקר | רנדור מהיר פי ~10 (PSRAM sprite איטי)
TX power מוגבל ל-8.5dBm | מעט טווח Wi-Fi | ריכוך קפיצת הזרם ב-association — פחות brownout על ספק חלש (פרק 8)
Modem-sleep כבוי | מעט זרם ממוצע גבוה יותר | קישור יציב; HTTP תקופתי לא נתקע ולא מפיל WDT
HTTP רגיל (CLOUD_USE_TLS=0) | הצפנת TLS | build קל יותר, פחות זיכרון/CPU; האימות נשען על x-device-secret
מגע = קליק, לא בורר-מיקום | נגיעה מדויקת בשורה ספציפית | אמינות — כיול לא-מדויק כבר לא נוחת על השורה הלא-נכונה (פרק 3)

איך מוכיחים את שיתוף IO21 חי: (א) מסובבים את האנקודר — הסמן זז (סיבוב על IO2/IO14). (ב) לוחצים על ציר האנקודר — בחירה/חזרה (הכפתור על IO21). (ג) נושפים על ה-DHT11 — הטמפ' עולה (DHT על IO21). כל השלושה עובדים מאותו רכיב פיזי בלי להתנגש. Serial b (button live test) מראה את מצב הכפתור הגולמי; Serial m מראה את הטמפ' — שניהם על IO21.

# 8. מקרי קצה וחוסן

"המערכת שורדת את העולם האמיתי" — ניתוקי רשת, תקלות חיישן, נעילת באס, נפילות מתח, וכיבוי-פתאום באמצע סשן. כל אחד מהמקרים למטה מטופל בקוד, וברובם ניתן להדגמה חיה.

## 8.1 טבלת החוסן

מקרה קצה | הטיפול בקוד | מקור
ניתוק Wi-Fi באמצע סשן | ספירת הסשן על esp_timer עצמאי — לא נעצרת; טלמטריה/העלאות נכנסות לבאפר; reconnect כל 15s | Session.cpp L28-53 · Cloud.cpp L936-941
קריאת חיישן נכשלת | DHT NaN ⇒ שומר ערך אחרון טוב; ToF לא-סביר נדחה (0<d<4000); כשל אתחול ToF ⇒ "תמיד נוכח" | Sensors.cpp L63-67, L227, L171-179
נעילת באס I2C | ToF כ-"canary": ping כל 2s; שני no-ACK ⇒ i2cRecover() (עד 9 שעוני SCL לשחרר slave שמחזיק SDA, STOP, re-init) | Sensors.cpp L112-139, L238-254
נפילת מתח (brownout) | סיבת האיפוס מוצגת על המסך ב-boot; TX power מוגבל לריכוך הקפיצה; הפתרון האמיתי — ספק 5V חזק יותר | config.h L221-234 · MindBox.ino L103-109
כיבוי-פתאום באמצע סשן | Checkpoint ב-NVS בכל start/pause/resume/add-time; ב-boot ⇒ מסך ST_RESUME | StateMachine.cpp L266-274 · Storage.cpp L465-592
עבודה ללא רשת | סשנים גמורים לתור עמיד ב-LittleFS (12 סשנים, drop-oldest); ניקוז עם backoff 5s→300s; 401 עוצר ניקוז | UploadQueue.cpp L168-199 · Cloud.cpp L439-479
אין שעון עדיין (לפני NTP) | סשן offline מקבל חותמות 1970, שמתוקנות לזמן אמיתי ברגע שה-NTP עולה | Cloud.cpp L423-437
גלישת באפר | HTTP_MAX_BODY=8192 עם drop ל-body חורג; parsers מגבילים אורכים; strncpy חסום | Cloud.cpp L85, L245-407
אזל זיכרון (OOM) | tripwire: heap_caps_register_failed_alloc_callback מדפיס את הגודל שנכשל + heap פנוי, מ-buffer על ה-stack (בלי הקצאה) | MindBox.ino L56-64
ריצוד כפתור/מגע | debounce 50ms + סיווג short/long לכפתור; סיווג מחוות למגע | Inputs.cpp L100-129 · config.h L257-259

## 8.2 שחזור באס I2C (ה-"canary")

באס I2C יכול להינעל אם slave נתקע ומחזיק את SDA נמוך. אנחנו מזהים את זה: ה-ToF נבדק כל 2s (I2C_HEALTH_MS); שני no-ACK רצופים מפעילים i2cRecover() שמדמה ידנית עד 9 שעוני SCL כדי ל"שחרר" את ה-slave, שולח STOP, ומאתחל מחדש את Wire + ToF. אם SDA עדיין תקוע — מסמנים s_fault=true וה-FSM עובר ל-ST_ERROR (במקום להיתקע בשקט). Wire.setTimeOut(50ms) מונע תקיעת טרנזקציה. Sensors.cpp L112-139

## 8.3 שחזור מכיבוי-פתאום (Checkpoint)

SessionCheckpoint נשמר ל-NVS בכל אירוע משמעותי, כ-struct מגובה-גרסה ו-magic (CK_MAGIC, CK_VER) עם זנב של 10 הדגימות האחרונות. ב-boot, loadCheckpoint() מזהה סשן פתוח ומציע ST_RESUME ("Resume session?"). tailCount פגום נחתך בבטחה גם בשמירה וגם בשחזור. Storage.cpp L465-592 · Session.cpp L153-159

## 8.4 תור offline וסנכרון

סשן שהסתיים נכתב לתור עמיד ב-LittleFS (על מחיצת ה-SPIFFS) לפני הכתיבה ל-NVS. worker הניקוז מעלה oldest-first עם backoff אקספוננציאלי (5s→300s), ו-העלאה idempotent (upsert על (device_id, id)) מבטיחה שבאצ' שנשלח שוב לא ייצור כפילויות. תגובת 401 עוצרת ניקוז (כשל אימות). UploadQueue.cpp · Cloud.cpp L439-479 · ingest.server.ts

## 8.5 סנכרון זמן (NTP)

בחיבור הראשון מופעל NTP ב-UTC (configTime(0,0,...)) עם מחרוזת ה-TZ של ישראל (DST אוטומטי). haveClock() = time() > 1.7e9. כפי שראינו בפרק 6, ה-SNTP מוגבל ל-12 שעות כדי לא לפתוח socket UDP באמצע HTTP. Cloud.cpp L945-955 · config.h L190-191

איך מוכיחים חוסן (שתי הדגמות חזקות):
(1) שחזור חשמל: באמצע סשן — מנתקים את ה-USB ומחברים. המכשיר עולה עם "Resume session?" מה-checkpoint, ומסך ה-boot מציג את סיבת האיפוס.
(2) offline מלא: מכבים את הראוטר, מריצים סשן שלם, מדליקים חזרה. Serial q מראה את הסשן בתור; אחרי חיבור הוא מופיע באתר עם הזמנים הנכונים (תוקנו ע"י NTP). תקלת חיישן ניתנת להדגמה ע"י ניתוק ה-DHT (שורת Fault אדומה ב-/device).

# 9. מכונת המצבים וזרימת הנתונים

המכשיר בנוי כמכונת מצבים (FSM) של 16 מצבים. הלב הוא מחזור חיי הסשן; סביבו מצבים לצימוד, שחזור, אג'נדה, שיעורי בית, שגיאה ודיאגנוסטיקה. כל tick קורא קלט → מריץ את ה-FSM → מצייר → מפרסם טלמטריה.

## 9.1 המצבים

16 המצבים (types.h): ST_BOOTING, ST_IDLE, ST_RUNNING, ST_PAUSED, ST_COMPLETE, ST_LOGGING, ST_ERROR, ST_PAIRING, ST_DIAG, ST_RESUME, ST_CYCLE_OFFER, ST_WIFI_SETUP, ST_AGENDA, ST_AUTOSTART, ST_MESSAGE, ST_HOMEWORK. הדיספאצ'ר הוא ה-switch הגדול ב-StateMachine::tick().

## 9.2 מחזור חיי סשן

Boot: טעינת DeviceConfig מ-NVS; אם קיים checkpoint ⇒ ST_RESUME, אחרת ⇒ ST_IDLE (offline-first: תמיד עולה לתפריט שמיש). Start: startSessionMode(MODE_WORK) ⇒ Session::start() חומש את הטיימר של 10ms, שומר checkpoint, מנגן צליל, ונכנס ל-ST_RUNNING. Running: מעקב הפרעות סביבתיות, coaching מסתגל, טיפול בנוכחות/היעדרות (עם auto-pause אופציונלי), ורישום דגימות. בסיום ⇒ onTimerComplete() ⇒ שמירה + לוגיקת מחזור פומודורו ⇒ ST_COMPLETE ⇒ ST_IDLE או ST_HOMEWORK. StateMachine.cpp L355-372, L545-576

## 9.3 מה נאסף ונשלח

בתוך סשן נרשמת דגימה Sample{ t, fle, noise, tempC, lightLux } כל SAMPLE_PERIOD_MS (WORK=60s, coaching=30s, break=120s; מקס' 120 דגימות). ה-Focus Load Estimate (FLE) הוא שקלול של התקדמות, רעש, שונות-אור ונוכחות. במקביל, snapshot חי נדחף למשימת הרשת ~1Hz ובכל מעבר-מצב (publishTelemetry() → TelemetrySnap): מצב, mode, זמן נותר, FLE, סוללה, JSON תקינות-חיישנים, ואופציונלית טמפ'/לחות/אור/רעש. Session.cpp L55-69 · StateMachine.cpp L236-264 · config.h L147-149,170

## 9.4 צימוד ופקודות מרחוק

צימוד: enterPairing() מייצר קוד 6-ספרתי (esp_random()%1000000), שולח POST /ingest/pairing, ומצב ST_PAIRING מושך config כל 3s עד ש-paired:true. Downlink: syncDownlink() מפרסר JOSN שטוח ומחיל הגדרות (ערכת צבעים, זמני פומודורו לפי timingRev, מצב מבחן/DND, סטריק, שיעורי בית) ופקודות מרחוק (CMD_START/END/RING/MESSAGE). Sign-out: signOutAccount() שולח /ingest/unpair + guard של 90s נגד paired:true ישן שבדרך. StateMachine.cpp L301-334, L657-696 · Cloud.cpp L538-663

איך מוכיחים את זרימת הנתונים: מסיימים סשן ⇒ בעמוד /session/$id באתר מופיעים גרפי ה-FLE והרעש דקה-בדקה + ספירת ההפרעות — הנתונים שנאספו הרגע. פקודה מרחוק ("Ring") מדגימה את הכיוון ההפוך (פרק 10).

# 10. התקן ↔ ענן ↔ אתר

כאן נסגר המעגל: המכשיר מדבר עם השרת דרך חוזה ingest פשוט (HTTP + secret משותף), השרת כותב ל-Supabase, והאתר מציג הכול כמעט בזמן אמת. אלה נקודות ההוכחה החזקות ביותר לדמו — כי הן נראות על מסך גדול, לא רק ב-Serial.

## 10.1 חוזה ה-ingest

נקודת הכניסה src/server.ts מפרידה תעבורה לפני ה-router: כל /ingest/* הולך ל-ingest.server.ts. האימות: header x-device-secret בהשוואת זמן-קבוע מול DEVICE_INGEST_SECRET; חסר/שגוי ⇒ 401. הכתיבות רצות ב-service-role client (עוקף RLS), אך הבעלות נבדקת מחדש לכל פעולה רגישה.

Route | גוף | מה השרת עושה | טבלאות
POST /ingest/sessions | מערך סשנים (batch) | upsert idempotent על (device_id, id); מחליף דגימות focus/env | sessions, focus_load_samples, env_samples
POST /ingest/telemetry | אובייקט יחיד | upsert לפי device_id — שורה אחת = ה-snapshot האחרון | device_status
GET /ingest/config | ?deviceId=&ack= | מרכיב downlink: הגדרות, לו"ז, ערכת צבעים, סטריק, שיעורי בית, ופקודה אחת | user_settings, schedule_events, homework, device_commands
POST /ingest/pairing | {deviceId, code} | upsert קוד 6-ספרות עם תוקף 15 דק' | device_pairing_codes
POST /ingest/unpair | {deviceId} | מנקה בעלות, מוחק פרופילים ופקודות שלא נמסרו | devices, device_profiles, device_commands
POST /ingest/homework | {deviceId, homeworkId, pct} | מעדכן אחוז; 100% + pending ⇒ submitted | homework_assignments

מקור: src/features/device/ingest.server.ts · src/server.ts. צד המכשיר: MindBox/src/Cloud.cpp.

## 10.2 המסכים החיים באתר (נקודות ההוכחה)

הבהרה טכנית חשובה להצגה: אין ב-אתר Supabase realtime/websockets. כל ה"חי" הוא polling של react-query (refetchInterval). זה למעשה קל יותר להסביר ולהדגים ביושר — "האתר שואל את השרת כל X שניות".

המסך | קצב רענון | מה זה מוכיח
/device — נקודת Online, סוללה, Wi-Fi, "Room right now" (טמפ'/לחות/אור/רעש), תקינות חיישנים | כל 10 שניות (+ tick שעון 15s) | טלמטריה מהמכשיר ⇒ שינוי גלוי על המסך תוך ≤10s. ההוכחה החזקה ביותר.
סף Online/Offline | 90s (3×30s) | כיבוי המכשיר ⇒ תוך 90s הנקודה אפורה + "Last seen"
כרטיס שליטה מרחוק (Start/End/Ring/Message) + צ'יפים Queued→Sent→Done | כל 5 שניות | נתיב אתר→מכשיר: פקודה עוברת Queued→Sent (המכשיר משך config)→Done (אישר)
Dashboard "Today" (דקות פוקוס, סשנים, סטריק, מצב מכשיר) | חלק המכשיר כל 10s | סשן חדש מופיע בסיכומי היום
/session/$id — גרפי FLE + דגימות סביבה | בטעינה | נתוני החיישנים דקה-בדקה שנחתו זה עתה

מקור: src/routes/device.tsx · src/features/device/freshness.ts · lib/queries/sessions.ts.

## 10.3 הסימולטור — גיבוי לדמו בלי חומרה

שני סימולטורים, שכל אחד מוכיח את החוזה בלי מכשיר פיזי:

- CLI — bun run simulate (דורש dev server רץ). זורע מכשיר, שולח ~30 יום סשנים (idempotent), ומזרים טלמטריה כל 3s. תרחישים: --offline-then-sync, --low-battery, --sensor-fault, --no-env; ופקודות: --config (מדפיס את ה-downlink בדיוק כמו שהמכשיר רואה), --send-command, --ack, --homework. scripts/simulator.ts
- עמוד /simulator באתר — GUI ללחיצה: רישום סשן בודד או דחיפת snapshot טלמטריה. אידאלי לדמו בלי טרמינל על המסך.

הוכחת מקצה-לקצה במשפט אחד: המכשיר (או bun run simulate) שולח JSON מאומת-secret ל-/ingest/telemetry ⇒ שורה נוחתת ב-device_status ⇒ ה-polling של react-query (כל 10s) מצייר מחדש את נקודת ה-Online, הסוללה ותנאי החדר — והכיוון ההפוך מוכח ע"י הוצאת פקודה מהאתר וצפייה ב-Queued→Sent→Done. לפני הדמו: ודאו שה-DEVICE_INGEST_SECRET ומפתחות Supabase בסביבה שאליה המכשיר מדבר תואמים למה שהמכשיר צרוב איתו — אחרת המכשיר יקבל 401.

# 11. דיאגנוסטיקה — איך מוכיחים כל טענה

זהו ה"ארגז כלים" שהופך כל טענה חומרתית לנראית — בדיוק מה שהצוות המנחה ביקש. שני משטחים: Serial @115200 (על USB-CDC) ומסך ה-ST_DIAG שמראה נתונים חיים בלי מחשב בכלל.

## 11.1 תפריט פקודות Serial

מקש | מה מציג / עושה
m | מוניטור 1Hz — שורה חיה עם מצב, טיימר, מרחק ToF, רעש, אור, טמפ', Wi-Fi, כפתור, תור
a | probe שמע/מיקרופון — ACK של הקודק + raw I2S min/max/RMS (מוכיח מיקרופון חי)
c | כיול חיישנים + קריאות חיות
b | בדיקת כפתור חיה (8s) — מסמן חיווט תקוע-LOW
t / k | probe מגע חי (crosshair) / כיול מגע מחדש
q | סטטוס תור ההעלאה — כמה ממתינים, ה-seq הישן ביותר, כמה נזרקו
w | הזנת Wi-Fi/URL/secret
d / h | dump חד-פעמי / עזרה

מקור: Diagnostics.cpp L293-310.

## 11.2 self-test ב-boot

בכל הדלקה מודפס דוח שמוכיח, שורה-שורה, שהמערכת בריאה:

firmware 0.2.0-s3
reset reason: 
heap: free / total   ·   PSRAM: found, 
render: sprite-internal            <-- ה-sprite ב-RAM פנימי (פרק 5)
I2C scan: 0x38 (touch)  0x29 (ToF) <-- שני התקנים על באס אחד (פרק 2)
display: ILI9341
ToF: present=<0/1> dist=mm
mic: level=   ES8311 ACK: ok   raw min/max/rms
light:      temp: C
wifi:

מקור: Diagnostics.cpp selfTest() L234-288.

## 11.3 מוניטור חי (1Hz) ומסך Diag

פקודת m מדפיסה כל שנייה: מצב, טיימר M:SS, mode, דגל נוכחות, dist=Nmm, רעש, lux, טמפ', ToF ok, Wi-Fi on/off, כפתור גולמי, דגל fault, מספר סשנים בבאפר, וכמות ממתינה בתור. מסך ST_DIAG מראה את אותו מידע ללא מחשב: שם דרייבר, ToF+mm, רעש dB + מצב כפתור, ובמיוחד 8311:ACK rdy:1 pp:<n> — ה-ACK של הקודק, דגל שה-I2S זורם, וה-peak-to-peak של השנייה האחרונה שקופץ כשמדברים. Diagnostics.cpp L51-90 · StateMachine.cpp L838-870

למה זה עונה בדיוק לדרישת המנחה: ההנחיה הייתה "אם תגידו שיש חיישן שמקבל בזמן אמת נתונים ומתקשר עם מערכת — שאוכל לראות את זה". פקודת m מראה את החיישנים משתנים חי; ה-self-test מוכיח את מפת החומרה; מסך ה-Diag מראה הכול בלי מחשב; והאתר (פרק 10) מראה את אותם נתונים אחרי מסע הענן. פרק 12 מרכז את הכול לתסריט של 30 דקות.

# 12. תסריט ההדגמה (30 דקות)

עיקרון המנחה: "תדאגו שיש דרך להציג ולוודא כל טענה שאתם טוענים." הפרק הזה נותן תסריט מלא של 30 דקות שבו כל טענה מלווה בהוכחה חיה, עם הפלט המדויק שצריך להצביע עליו, וגיבוי בסימולטור אם החומרה מסרבת לשתף פעולה.

## 12.1 צ'ק-ליסט לפני הדמו

# | מה לוודא | למה

1 | ספק 5V חזק (מטען קיר/פאוורבנק טוב, לא רק USB של לפטופ) | המיקרופון+ToF מעלים זרם boot; ספק חלש ⇒ brownout ואתחול-לולאה (פרק 8)
2 | רשת Wi-Fi 2.4GHz זמינה (לא 5GHz בלבד) | ה-ESP32-S3 תומך רק ב-2.4GHz
3 | dev server רץ (bun run dev → http://localhost:8080) או האתר המפורסם, עם DEVICE_INGEST_SECRET ומפתחות Supabase תואמים למכשיר | אחרת המכשיר יקבל 401 מול הענן
4 | /device פתוח על מסך גדול; המכשיר מצומד לחשבון | נקודת ההוכחה החזותית המרכזית
5 | Serial monitor פתוח @115200 | self-test + מוניטור m
6 | המגע מכויל (אם לא — החזקה ארוכה על BOOT) | ניווט חלק בזמן הדמו
7 | גיבוי: bun run simulate נבדק שרץ | תוכנית-מגירה אם החומרה נופלת

## 12.2 טבלת טענה → הוכחה (עם הפלט המדויק)

# | הטענה | הפעולה החיה | הפלט המדויק להצביע עליו

1 | המכשיר מדווח לענן כל 30s | לפתוח /device ולחכות | נקודת Online ירוקה; "Room right now" מתעדכן. כיבוי ⇒ "Last seen" תוך 90s
2 | מיקרופון I2S אמיתי מודד רעש | מחיאת כף ליד הקופסה | Serial a: RMS קופץ; מסך Diag: pp קופץ; הערך באתר בפעימה הבאה
3 | ToF מזהה נוכחות | להזיז יד קדימה/אחורה | Serial m: dist=Nmm משתנה חי; התרחקות בסשן ⇒ Away
4 | טמפ'/לחות נמדדות | נשיפה חמה על ה-DHT11 | הטמפ' עולה ב-Serial/Diag תוך שניות, ואז ב-"Room right now"
5 | חיישן אור + בהירות אוטומטית | לכסות את החיישן ביד | ה-lux צונח ב-Diag; המסך מתעמעם פיזית
6 | הפרעות מגיעות לענן דגימה-בדגימה | סשן קצר עם רעש מכוון + התרחקות | /session/$id: גרף FLE+רעש לאורך הדקות + ספירת הפרעות
7 | האתר שולט במכשיר מרחוק | "Ring my device" מ-/device | המכשיר מצלצל ≤60s; באתר Queued→Sent→Done
8 | שינוי הגדרה מגיע למכשיר | להחליף ערכת צבעים ב-Settings | צבעי המסך מתחלפים ≤60s
9 | שיתוף IO21 (אנקודר+טמפ') עובד | לסובב אנקודר, ללחוץ ציר, לנשוף על DHT | הסמן זז (IO2/14) · בחירה (IO21) · טמפ' עולה (IO21) — מאותו רכיב, בלי התנגשות
10 | offline מלא + סנכרון | לכבות ראוטר, סשן שלם, להדליק | Serial q: סשן בתור ⇒ מופיע באתר עם זמנים נכונים (NTP)
11 | תקלת חיישן מדווחת, לא נבלעת | לנתק DHT (או --sensor-fault) | שורת Fault אדומה ב-/device; StateBadge → danger
12 | שרידות ניתוק חשמל | לנתק USB באמצע סשן ולחבר | עולה עם "Resume session?"; boot מציג את סיבת האיפוס
13 | העברת דאטה מאומתת בזהות | curl ל-/ingest/config בלי header | 401; עם ה-header ⇒ JSON מלא
14 | שתי ליבות — המסך שורד עומס רשת | לנתק Wi-Fi באמצע סשן | המסך/מגע ממשיכים חלק; ספירת הסשן מדויקת
15 | שני התקנים על באס I2C אחד | self-test ב-boot | סריקת I2C מציגה 0x38 + 0x29

הפקודה להדגמת טענה 13 (אימות):

# ללא header ⇒ 401
curl -s -o /dev/null -w "%{http_code}\n" \
  "$APP_BASE_URL/ingest/config?deviceId=mindbox-sim-01"

# עם header ⇒ JSON מלא (downlink)
curl -H "x-device-secret: $DEVICE_INGEST_SECRET" \
  "$APP_BASE_URL/ingest/config?deviceId=mindbox-sim-01"

## 12.3 Run-of-show — דקה אחר דקה

דקות | שלב | מה עושים ומה אומרים
0–5 | הסיפור והארכיטקטורה | הבעיה (פוקוס, לא זמן) → מה MindBox → תמונת-העל (פרק 1): מכשיר ↔ ענן ↔ אתר. להחזיק את הלוח ביד ולהצביע על המסך, המיקרופון, ה-ToF, האנקודר.
5–9 | הדלקה + self-test חי | הדלקה מול הקהל: boot breadcrumbs + סיבת איפוס על המסך; ב-Serial — סריקת I2C (0x38+0x29), PSRAM, render=sprite-internal, heap. מוכיח טענות 15 + מפת החומרה.
9–14 | "החיישנים חיים" — Serial m | יד (מרחק) · מחיאת כף (רעש/pp) · כיסוי (lux + עמעום מסך) · נשיפה (טמפ') — הכול בשורה חיה אחת. מוכיח טענות 2–5.
14–19 | סשן חי עם הפרעות | התחלת סשן; רעש מכוון ⇒ אייקון + התראה קולית; התרחקות ⇒ Away; בסיום — סיכום על המכשיר. מוכיח 3, 6.
19–23 | הדאטה בענן | /session/$id — גרפי הדקה-בדקה של הסשן שהרגע נגמר; /device — "Room right now" חי. מוכיח 1, 6.
23–26 | שליטה דו-כיוונית | "Ring my device" (Queued→Sent→Done); החלפת theme; הוספת אירוע ליומן ⇒ מופיע על המכשיר. מוכיח 7, 8.
26–30 | עומק הנדסי + חוסן | 2 ליבות (פרק 4), למה המסך לא קורס (פרק 5), שיתוף IO21 (פרק 7), ותיקון ה-pbuf_free (פרק 6). לסיים בניתוק חשמל חי באמצע סשן ⇒ "Resume". מוכיח 9, 12, 14. להשאיר דקה ל-Q&A.

## 12.4 גיבוי בלי חומרה

אם החומרה נופלת (brownout, רשת) — כל נתיב שרת ניתן להדגמה עם הסימולטור: bun run simulate לזרם טלמטריה חי אל /device; -- --sensor-fault / --low-battery / --offline-then-sync לתרחישי קצה; -- --config להדפסת ה-downlink; ומחזור פקודות מלא (--send-command ⇒ Queued ⇒ --config ⇒ Sent ⇒ --ack ⇒ Done). לחלופין, עמוד /simulator באתר לדמו בלי טרמינל.

# נספחים

## נספח A — מפת פינים מלאה (מרוכזת)

רכיב | פינים | פרוטוקול
ILI9341 TFT | SCK12 MOSI11 MISO13 DC46 CS10 RST-1 BL45 | SPI2 @40MHz + DMA
FT6336 touch | SDA16 SCL15 INT17 RST18 | I2C 0x38 @400kHz
VL53L1X ToF | SDA16 SCL15 (shared) | I2C 0x29
ES8311 mic | DIN6 BCLK5 LRCK7 MCLK4 | I2S 16kHz
Speaker/amp | DOUT8 AMP_EN1 (active-low) | I2S + FM8002E
ES8311 control | SDA16 SCL15 (boot-only) | soft-I2C 0x18
KY-040 encoder | CLK2 DT14 SW=-1 | quadrature ISR
כפתור צד | IO21 (shared w/ DHT11) | digital active-low
DHT11 | DATA IO21 (+pull-up) | 1-wire
KY-018 light | AO IO3 | analog ADC1
BOOT btn | IO0 | digital (theme/recal)

פינים חשופים ב-header: IO2, IO3, IO14, IO21 בלבד. מקור: config.h.

## נספח B — פקודות Serial

m מוניטור 1Hz · a מיקרופון · c כיול חיישנים · b בדיקת כפתור · t/k מגע/כיול מגע · q תור העלאה · w Wi-Fi/URL/secret · d dump · h עזרה. (@115200)

## נספח C — קבועים מרכזיים (config.h)

קבוע | ערך | משמעות
TELEMETRY_PERIOD_MS | 30000 | פעימת-לב טלמטריה (30s)
CONFIG_FETCH_MS | 60000 | משיכת downlink (60s; 3s בצימוד)
SESSION_CLOCK_MS | 10 | טיימר סשן (esp_timer)
TOF_POLL_MS | 500 | קצב ToF
PRESENCE_NEAR_MM | 700 | סף נוכחות
WDT_TIMEOUT_MS | 30000 | task watchdog
WIFI_RETRY_MS | 15000 | reconnect ידני מסונכרן
UPLOAD_QUEUE_MAX | 12 | תור offline (LittleFS)
I2C_HEALTH_MS | 2000 | ping ToF (canary)

## נספח D — מילון מונחים

FLE — Focus Load Estimate, אומדן עומס פוקוס (0–100). · ToF — Time-of-Flight, חיישן מרחק לייזר. · ingest — נתיבי ה-API שהמכשיר כותב אליהם. · downlink — הקונפיג שהשרת מחזיר למכשיר. · pbuf — packet buffer של מחסנית ה-רשת lwIP. · sprite — באפר תמונה מחוץ-למסך שמורכב ואז מוטבע בבת-אחת. · NVS — Non-Volatile Storage (הגדרות/checkpoint). · LittleFS — מערכת קבצים על ה-flash הפנימי (תור ה-offline).

שורה תחתונה למנחה: כל טענה במסמך — מפת הפינים, שיתוף IO21, שתי הליבות, אי-קריסת המסך, מסע הנתונים לענן — ניתנת להוכחה חיה תוך שניות, דרך Serial, מסך ה-Diag, או האתר. זה בדיוק מה שהתבקש: מערכת שבה לכל טענה יש דרך להראות ולוודא אותה.
