royavidan/IOT-Project-study-assistor/mindbox-companion-forge-main/docs/MindBox-System-Guide.html

# MindBox — מדריך מערכת מלא

שעון פומודורו חכם על ESP32-S3: חיישנים, קושחה, ותקשורת ענן

גרסת קושחה: 0.2.0-s3 · לוח: LCDWIKI ES3C28P (ESP32-S3, מסך מגע 2.8")
המסמך נבנה מתוך קוד המקור — כל טענה מלווה בהפניה לקובץ ובדרך להוכיח אותה בזמן אמת

# תוכן העניינים

1. סקירת מערכת וארכיטקטורה
2. החומרה: הלוח, מפת הפינים והבאסים
3. החיישנים — אחד-אחד: עיקרון, חיווט, דרייבר, ועיבוד
4. עיבוד הנתונים על המכשיר (Focus Load, התראות סביבה, נוכחות)
5. ארכיטקטורת הקושחה (משימות, ליבות, מכונת מצבים)
6. פרוטוקול התקשורת מכשיר ↔ שרת
7. צד האתר: איך כל נתון נקלט, נשמר ומוצג
8. לקחים הנדסיים (Brownout, קונפליקטי I2C, שיתוף פינים)
9. פרק ההוכחות: טענה → הדגמה חיה → איפה רואים
10. נספחים: פקודות Serial, דגלי סימולטור, מפתחות NVS, שדות ה-Downlink

# 1. סקירת מערכת וארכיטקטורה

MindBox היא מערכת IoT שלמה ללימוד ממוקד: קופסה פיזית על בסיס ESP32-S3 שמריצה סשני פוקוס (פומודורו), מודדת את סביבת הלימוד בזמן אמת (רעש, טמפרטורה, לחות, אור, נוכחות מול המכשיר), ומסונכרנת דו-כיוונית עם אפליקציית ווב (TanStack Start + Supabase). המכשיר אינו "שעון פסיבי": הוא מריץ שתי ליבות, חמישה חיישנים פעילים, מסך מגע, שמע דו-כיווני (מיקרופון I2S + רמקול), ואינטגרציית ענן מלאה עם עבודה גם ב-offline.

מטרת המסמך: (א) שכל חבר צוות יוכל ללמוד את המערכת כולה מקצה לקצה; (ב) שלכל טענה חומרתית תהיה דרך הוכחה מיידית — בהתאם להנחיית הצוות המנחה ("תדאגו שיש דרך להציג ולוודא טענות שאתם תטענו"). פרק 9 מרכז את כל ההוכחות.

## 1.1 תמונת-על

## 1.2 חמשת ערוצי התקשורת

ערוץ | Route | כיוון | קצב | מה עובר
סשנים | POST /ingest/sessions | מכשיר → שרת | בסיום סשן (+ תור offline) | סשן מלא: זמנים, מצב, אגרגטים סביבתיים, דגימות לדקה
טלמטריה | POST /ingest/telemetry | מכשיר → שרת | כל 30 שניות (פעימת-לב) | מצב, סוללה, WiFi RSSI, תקינות חיישנים, טמפ'/לחות/אור/רעש חיים, גרסת קושחה
קונפיגורציה | GET /ingest/config | שרת → מכשיר | כל 60 שניות (3–5 שניות בזמן צימוד) | 32 שדות: הגדרות, לו"ז יומי+שבועי, ערכת צבעים, זמני פומודורו, מצב מבחן, סטריק, שיעורי בית, פקודות מרחוק
צימוד | POST /ingest/pairing · /ingest/unpair | מכשיר → שרת | לפי דרישה | קוד 6 ספרות שהמכשיר מציג; שחרור בעלות
שיעורי בית | POST /ingest/homework | מכשיר → שרת | לפי פעולה במסך המגע | עדכון אחוז התקדמות של מטלה מהמכשיר

כל הערוצים מאומתים ב-header x-device-secret (השוואה בזמן-קבוע נגד timing attacks, ingest.server.ts). הכתיבות רצות דרך service-role client כשהבעלות נבדקת מחדש בקוד עבור כל פעולה רגישה (שיעורי בית, פקודות, unpair).

הוכחה מהירה שהכול חי: פתחו את /device באתר ליד המכשיר — נקודת ה-Online, הסוללה, עוצמת ה-WiFi ותנאי החדר ("Room right now") מתעדכנים מכל פעימת טלמטריה (30 שניות מהמכשיר, רענון UI כל 10 שניות). כבו את המכשיר — תוך 90 שניות החיווי יהפוך ל-"Last seen X min ago". ההרחבה המלאה בפרק 9.

# 2. החומרה: הלוח, מפת הפינים והבאסים

## 2.1 הלוח

LCDWIKI ES3C28P/ES3N28P — לוח ESP32-S3 עם מסך 2.8" מובנה: ILI9341 בגודל 240×320 על SPI, מגע קיבולי FT6336 על I2C, קודק שמע ES8311 (מיקרופון MEMS דיגיטלי + DAC לרמקול) ומגבר FM8002E. הגדרות Arduino: ESP32S3 Dev Module, USB CDC On Boot=Enabled, Flash 16MB, Partition "Huge APP (3MB)", PSRAM="OPI PSRAM". רוב ה-GPIO תפוסים ע"י המסך/שמע/SD — הלוח חושף לחיווט חיצוני רק ארבעה פינים: IO2, IO3, IO14, IO21, ולכן כל תכנון החיישנים נבנה סביב האילוץ הזה (ראו 2.4).

## 2.2 מפת פינים מלאה (המקור: src/config.h)

Pin | תפקיד | באס/סוג | הערות
IO12 / IO11 / IO13 | מסך SCLK / MOSI / MISO | SPI2, 40MHz write | DMA אוטומטי; דחיפת פריים מלא ~30ms
IO10 / IO46 | מסך CS / DC | SPI2 | RST קשור ל-EN של הלוח
IO45 | תאורת מסך אחורית | PWM (Light_PWM, 12kHz, ch 7) | 0–100% ממופה ל-PWM 10–255 — לעולם לא כבוי לגמרי
IO16 / IO15 | SDA / SCL | I2C (Wire, 400kHz) | באס משותף: מגע FT6336 (0x38) + ToF VL53L1X (0x29) + קודק ES8311 (0x18, soft-I2C בזמן boot בלבד)
IO17 / IO18 | מגע INT / RST | GPIO | RST מקבל פולס ב-Panel::begin
IO4 / IO5 / IO7 | שמע MCLK / BCLK / LRCK | I2S_NUM_0, master | 16kHz, 16-bit mono, full-duplex
IO8 / IO6 | שמע DOUT (רמקול) / DIN (מיקרופון) | I2S | TX+RX יחד כדי ש-MCLK ימשיך להזין את ה-ADC
IO1 | הפעלת מגבר (AMP_EN) | GPIO, active-low | המגבר נדלק רק בזמן צליל
IO21 | DHT11 DATA וגם כפתור צד | 1-wire + GPIO | פין כפול-שימוש — ראו 2.4; חובה pull-up ‏4.7k–10k ל-3V3
IO3 | חיישן אור KY-018 AO | ADC1, 12-bit | ערך גולמי הפוך (עולה בחושך) — מנורמל בקוד
IO2 / IO14 | אנקודר סיבובי CLK / DT | GPIO | KY-040; לחצן הציר מחווט ל-IO21 (נתיב הכפתור)
IO0 | כפתור BOOT | GPIO | החלפת ערכת נושא / כיול מגע מחדש

פינים רשומים אך לא פעילים (placeholders): PIN_HAPTIC 48 (=SD_D2 — מנוע רטט הוסר, HAS_HAPTIC 0), PIN_LED_RING 39 (=SD_D0), PIN_BATTERY_ADC 6 (=I2S_DIN; סוללה אמיתית = IO9), PIN_MIC 2 (מיקרופון אנלוגי ישן — הוצא משימוש לטובת ה-I2S).

## 2.3 טבלת יכולות — מה מחווט ופעיל היום (config.h:19–38)

Flag | ערך | משמעות
USE_TOUCH | 1 | ממשק מגע FT6336 מלא (כולל כיול 4 פינות שנשמר ב-NVS)
HAS_I2S_MIC | 1 | מיקרופון MEMS דיגיטלי דרך ES8311 — המיקרופון היחיד בלוח
HAS_SPEAKER | 1 | רמקול דרך ES8311 DAC + מגבר FM8002E
HAS_PRESENCE | 1 | חיישן מרחק VL53L1X (זיהוי נוכחות מול המכשיר)
HAS_LIGHT | 1 | פוטורזיסטור KY-018 (לוקס + תנודתיות תאורה)
HAS_TEMP | 1 | DHT11 — טמפרטורה + לחות
HAS_ENCODER | 1 | אנקודר סיבובי KY-040
ENABLE_WIFI / ENABLE_CLOUD | 1 / 1 | WiFi + NTP + סנכרון ענן מלא
HAS_HAPTIC / HAS_LED_RING / HAS_BATTERY / HAS_MIC | 0 | רטט הוסר; טבעת LED לא מחווטת; סוללה stub; מיקרופון אנלוגי הוצא משימוש

## 2.4 שלושת אילוצי החיווט המרכזיים (ולמה הם החלטות הנדסיות)

### א. באס I2C אחד, שלושה התקנים, master אחד

המגע (0x38), ה-ToF (0x29) והקודק (0x18) חולקים את IO16/IO15. ניסיון מוקדם להריץ שני I2C masters (LovyanGFX פנימי + Wire) גרם לקריסת המגע; הפתרון הסופי: דרייבר מגע custom שקורא FT6336 ישירות דרך Wire (רגיסטרים 0x02–0x06), כך שכל ההתקנים על master יחיד. הקודק מתוכנת פעם אחת ב-boot דרך soft-I2C (bit-bang ~125kHz) לפני ש-LovyanGFX תופס את הפינים, ואז משוחרר. בנוסף קיים I2C watchdog: בדיקת ACK ל-ToF כל 2 שניות; שני כשלים רצופים מפעילים ריקברי (9 פולסים + STOP + re-init).

### ב. IO21 — פין אחד, שני תפקידים

ה-DHT11 וכפתור הצד חולקים את IO21. זה עובד כי: (1) ה-pull-up של ה-DHT מחזיק את הקו HIGH, בדיוק מה שכפתור active-low צריך במנוחה; (2) הקושחה מדלגת על קריאת DHT כשהכפתור לחוץ (Sensors.cpp — בדיקת digitalRead LOW לפני קריאה), כך ששני השימושים לא מתנגשים.

### ג. ארבעה פינים חופשיים בלבד

הלוח חושף רק את IO2/IO3/IO14/IO21 — ולכן כל חיישן חיצוני "מתחרה" על פינים: האנקודר קיבל את IO2/IO14, האור את IO3, וה-DHT את IO21 (במשותף עם הכפתור). ה-ToF עבר לבאס המגע הקיים במקום לצרוך זוג פינים. IO14 הוא גם ADC2 — לא שמיש כ-ADC לצד WiFi פעיל, עוד שיקול במיפוי.

אזהרת דוקומנטציה ישנה: בקבצים היסטוריים בעץ יש מידע מיושן — docs/HARDWARE.md מתאר את לוח ה-ESP32 הקלאסי (לא ה-S3), ו-docs/WIRING.md עדיין מתעד מיקרופון אנלוגי על IO2 ו"אין קוד שמע" — שניהם הוחלפו (המיקרופון היום I2S דרך הקודק, והשמע פעיל במלואו). המסמך הזה + src/config.h הם המקור העדכני.

# 3. החיישנים — אחד-אחד

לכל חיישן: איך הוא עובד פיזיקלית, איך הוא מחווט, איפה הדרייבר, באיזה קצב הוא נדגם, איך הקריאה הגולמית הופכת ליחידות, איך מזוהות תקלות — ואיך מוכיחים שהוא חי.

## 3.1 DHT11 — טמפרטורה ולחות

עיקרון פיזיקלי | מדחום תרמיסטור + חיישן לחות קיבולי; פרוטוקול 1-wire קנייני (רצף פולסים מתוזמן על קו דאטה אחד)
חיווט | DATA→IO21 (משותף עם כפתור הצד), VCC→3V3, GND; pull-up ‏4.7k–10k חובה DATA→3V3
דרייבר | Sensors.cpp — refreshDht(), ספריית DHT
קצב דגימה | כל 2000ms (DHT_READ_INTERVAL_MS) — מגבלת החיישן עצמו; 5 שניות warmup אחרי boot
עיבוד | טמפ' + offset כיול (Storage::tempOffsetC, פקודת serial ‏c temp); תיחום תקינות ‎−20…60°C; לחות 0–100%
תקלות | קריאה מחוץ לטווח/NaN ⇒ tempPresent=false ⇒ ‏"temp":"invalid" ב-sensorHealth של הטלמטריה ⇒ שורת Fault אדומה בעמוד ‎/device

הוכחה: ‏m ב-Serial מציג טמפ' חיה; נשיפה חמה על החיישן מעלה את הערך תוך ‎2–4 שניות גם בשורת ‎[mon]‎, גם במסך ה-Diag במכשיר, וגם ב-"Room right now" באתר (עדכון ≤30 שניות).

## 3.2 VL53L1X — חיישן מרחק Time-of-Flight (נוכחות)

עיקרון פיזיקלי | לייזר IR ‏940nm + מדידת זמן-טיסה של פוטונים (SPAD array) ⇒ מרחק במ"מ עד ~4m, ללא תלות בצבע המשטח
חיווט | על באס ה-I2C המשותף (IO16/IO15), כתובת 0x29
דרייבר | Sensors.cpp, ספריית Adafruit_VL53L1X; מצב long-range, ‏timing budget ‏50ms
קצב דגימה | כל 500ms (TOF_POLL_MS): ‏dataReady→distance→clearInterrupt; רק ‎0–4000mm נחשב תקין
עיבוד | נוכחות = מרחק < ‏700mm (PRESENCE_NEAR_MM); נמדד גם משך היעדרות רציף (absentForMs) שמזין ספירת הפרעות-נוכחות והשהיה אוטומטית
תקלות | I2C watchdog כל 2s על 0x29; שני NACK רצופים ⇒ ריקברי-באס; SDA תקוע ⇒ ‏ST_ERROR על המסך (תקלה קריטית, לא שקטה)

הוכחה: ‏m ב-Serial מציג dist=Nmm חי — הזיזו יד מול החיישן וראו את המספר קופץ. בזמן סשן: התרחקות ‎>‏15 שניות מציגה חיווי Away על מסך הטיימר וסופרת presence interruption שמגיע עד גרף הסשן באתר.

## 3.3 KY-018 — חיישן אור (פוטורזיסטור)

עיקרון פיזיקלי | נגד תלוי-אור (LDR): ההתנגדות יורדת באור; נמדד כמתח על מחלק דרך ADC
חיווט | AO→IO3 ‏(ADC1, ‏12-bit), מוזן מ-3V3
דרייבר | Sensors.cpp — חלון min/max של שנייה
עיבוד | ההיפוך (LIGHT_RAW_DARK_HIGH — הגולמי עולה בחושך) ⇒ ‏lux = mid/4095 × luxScale (ברירת מחדל 1000, כיול ב-c light); תנודתיות ‏lightVar = (max−min)/varScale — מזהה תאורה מהבהבת ומזין את מדד העומס
שימושים | התראת אור נמוך/גבוה (ספים 50–1000 lux), בהירות מסך אוטומטית (מיפוי lux→20–100% עם היסטרזיס 5%), רכיב ב-Focus Load

הוכחה: כסו את החיישן ביד — במסך Diag ובשורת ‎[mon]‎ ה-lux צונח, ואם auto-brightness פעיל המסך מתעמעם בפועל תוך שנייה-שתיים; באתר הערך מגיע בפעימת הטלמטריה הבאה.

## 3.4 מיקרופון MEMS דיגיטלי — דרך קודק ES8311 (I2S)

עיקרון פיזיקלי | ממברנת MEMS קיבולית ⇒ ADC בתוך הקודק ⇒ דגימות PCM דיגיטליות על באס I2S — אין שום דרך לקרוא אותו כ-analogRead
חיווט | מובנה בלוח: DIN=IO6, שעונים MCLK4/BCLK5/LRCK7; תכנות הקודק ב-I2C ‏0x18 (soft-I2C ב-boot)
דרייבר | Audio.cpp — רצף אתחול רגיסטרים מלא (כולל התיקון הקריטי: ‏reg ‏0x01=0x3F שמדליק את שעון ה-ADC — בלעדיו המיקרופון "עובד" ומחזיר אפסים); משימת FreeRTOS ייעודית על ליבה 0
קצב דגימה | 16kHz, ‏16-bit mono, פריימים של 256 דגימות (~16ms), חלון RMS של ~שנייה
עיבוד | AC-RMS: ‏var = mean(v²) − mean(v)² (מסיר DC bias) ⇒ ‏micLevel = rms/1000 (0–1) ⇒ וגם dB SPL: ‏20·log10(rms/32768) + 116 (offset מכויל, ‏c db). סף התראת רעש: ‏60dB (מתכוונן 40–80 בתפריט)
תקלות | micOk = המשימה מדווחת נתונים חיים; כשל אתחול קודק ⇒ ‏boot-ack=NO ב-Audio::probe

הוכחה: פקודת ‎a‎ ב-Serial מדפיסה boot-ACK של הקודק + min/max/RMS גולמיים — מחיאת כף מקפיצה את ה-RMS בסדר גודל. מסך ה-Diag מציג ‏pp (peak-to-peak) שקופץ עם כל רעש, וה-dB חי בשורת ‎[mon]‎ וב-"Room right now" באתר.

## 3.5 רמקול — ES8311 DAC + מגבר FM8002E

עיקרון | סינתזת צלילים בתוכנה: רצפי sine ‏(Note{freq,ms}) נכתבים ל-I2S TX ⇒ DAC ⇒ מגבר class-AB ⇒ רמקול
שליטה | המגבר (AMP_EN=IO1, ‏active-low) נדלק רק בזמן צליל — חיסכון בזרם ורחש; עוצמה = סקיילינג אמפליטודה בתוכנה (3 דרגות)
רפרטואר | 8 צלילים: התחלה/השהיה/המשך/סיום/בדיקה/התחלה-מתוזמנת/התראה/RING (צלצול find-my ב-11 תווים בעוצמה מלאה, עוקף כל השתקה)
שליטה מהאתר | מסך Settings באתר קובע: מתג ראשי, עוצמה, אילו צלילים (chimeMask) — נאכף במכשיר בכל poll

הוכחה: צליל boot נשמע בכל הדלקה (מוכיח חיווט מגבר); "Test sound" בתפריט; ומהאתר — כפתור "Ring my device" מפעיל צלצול תוך ≤60 שניות כשהסטטוס באתר עובר Queued→Sent→Done.

## 3.6 מסך מגע — FT6336 (קיבולי) + ILI9341

עיקרון | מגע קיבולי: שינוי קיבול ברשת אלקטרודות; הבקר מחזיר קואורדינטות מוחלטות ב-I2C
דרייבר | Touch.cpp — קריאת רגיסטרים ישירה (0x02 ספירה, 0x03–0x06 ‏X/Y) על Wire המשותף; כיול 4 פינות שנשמר ב-NVS ולומד את האוריינטציה
רינדור | LovyanGFX + sprite ‏RGB332 ‏(75KB, נופל ל-PSRAM בעת הצורך); דחיפת פריים ~30ms

הוכחה: פקודת ‎t‎ ב-Serial פותחת בדיקת crosshair חיה — כל נגיעה מציירת את הנקודה שנקראה; ‏k מריץ כיול מחדש מלא.

## 3.7 אנקודר סיבובי KY-040 + כפתורים

CLK=IO2, ‏DT=IO14, לחצן ציר על נתיב IO21. משמש לניווט בתפריטים, דפדוף ימים במסך הלו"ז, וכוונון ערכים — לצד המגע (המערכת ממזגת את שניהם ב-Inputs.cpp). כפתור BOOT ‏(IO0) מחליף ערכת נושא בלחיצה קצרה. הוכחה: פקודת ‎b‎ ב-Serial מדפיסה את מצב הכפתור חי למשך 8 שניות.

# 4. עיבוד הנתונים על המכשיר

הקריאות הגולמיות לא נשלחות "כמו שהן" — המכשיר מריץ עליהן עיבוד בזמן אמת שמפיק מדדים, התראות והחלטות. זה הלב האלגוריתמי של הקושחה.

## 4.1 Focus Load Estimate ‏(FLE) — מדד עומס הריכוז

נוסחה דטרמיניסטית (src/focus_load.h, זהה 1:1 לקוד האתר ב-src/lib/focus-load.ts — אותו מספר מחושב בשני הצדדים):

FLE = 100 × [ 0.3·(elapsed/target) + 0.3·noise + 0.2·lightVar + 0.2·min(presenceInterruptions/5, 1) ]

רכיב | משקל | מקור
התקדמות בסשן (עייפות מצטברת) | 30% | שעון הסשן
רעש סביבתי מנורמל (0–1) | 30% | מיקרופון I2S ‏(AC-RMS)
תנודתיות תאורה (0–1) | 20% | KY-018 (חלון min/max)
הפרעות נוכחות (עד 5) | 20% | ToF (ספירת יציאות)

מחושב לכל דגימה בתוך סשן; ‏FLE > 75 מפעיל אימון אדפטיבי (הצעת הפסקה, ‏cooldown ‏5 דקות) אם המשתמש הפעיל זאת.

## 4.2 התראות סביבה (Interference) — ספים מפורשים

StateMachine.cpp — currentInterference(); סדר עדיפויות: היעדרות > רעש > טמפרטורה > אור. כל התראה פעילה רק אם החיישן מחווט (HAS_*) והמשתמש לא כיבה אותה בתפריט Environment:

התראה | תנאי | ברירת מחדל (מתכוונן)
AWAY | ToF לא מזהה נוכחות | מרחק ≥ 700mm
NOISE_HIGH | רעש מעל סף | 60 dB SPL (טווח כוונון 40–80)
TEMP_HIGH / TEMP_LOW | מחוץ לתחום נוחות | 18–26°C
LIGHT_HIGH / LIGHT_LOW | מחוץ לתחום | 50–1000 lux

התראה שנמשכת 30 שניות רציפות מפיקה nudge קולי (צליל Alert, מוגבל לאחת כל 3 דקות בסשן, מושתק במצב מבחן). מסך הטיימר מציג אייקוני סביבה חיים (חום/רעש/היעדרות) + שורת אזהרה, וההפרעה החמורה ביותר נשמרת ומוצגת בסיכום הסשן (DONE).

## 4.3 ספירת הפרעות נוכחות ו-Away

מעבר present→away נספר פעם אחת (edge-counting) רק אחרי שההיעדרות עוברת את סף הזמן — כדי שהליכה רגעית לא תיספר. משך ההיעדרות נצבר בנפרד (awayMs) ונשלח לשרת, כך שהאתר יכול לחשב "זמן פוקוס אמיתי" = משך − היעדרויות. אופציית auto-pause משהה את הסשן אוטומטית בהיעדרות ממושכת ומחדשת בחזרה.

## 4.4 דגימות ואגרגטים של סשן

מה | ערך
קצב דגימה בעבודה / באימון אדפטיבי / בהפסקה | 60s / 30s / 120s
תקרת דגימות לסשן | 120 (MAX_SAMPLES)
כל דגימה | {t, fle, noise, tempC, lightLux}
אגרגטים בסיום | noiseAvg, noisePeak, tempC(ממוצע), lightLux(ממוצע), focusLoadAvg

הדגימות עולות לשרת עם הסשן ומזינות את גרפי הדקה-בדקה בעמוד פירוט הסשן באתר — זו ההוכחה הוויזואלית החזקה ביותר לרציפות המדידה (ראו פרק 9).

## 4.5 בהירות מסך אוטומטית

כשמופעל (ולא בשעות שקט): ‏brightness% = map(lux 0–1000 → 20–100) בקצב ~1Hz עם היסטרזיס 5% (בלי הבהוב). שעות שקט מעמעמות ל-15%; שליטה ידנית זמינה בתפריט.

## 4.6 החלטות מקומיות מול החלטות ענן — חלוקת אחריות

החלטה | איפה | למה
התראות סביבה, FLE, ‏auto-pause, ‏auto-brightness | מכשיר | זמן-אמת; חייב לעבוד גם בלי רשת
התחלה אוטומטית של סשן מתוזמן | מכשיר (שעון NTP + לו"ז שהורד) | עמידות לניתוקים — השרת לא "דוחף", המכשיר מחליט לפי השעון
לו"ז, ערכת נושא, זמני פומודורו, מצב מבחן, סטריק | שרת (downlink) | מקור אמת אחד = היומן באתר
אנליטיקות, wellbeing, תכנון AI | שרת | דורש היסטוריה מלאה וכוח חישוב

# 5. ארכיטקטורת הקושחה

## 5.1 שלוש משימות, שתי ליבות

משימה | ליבה | תפקיד | פרטים
Arduino loop | 1 | UI + מכונת מצבים + חיישנים | קלט → FSM → רינדור → פרסום טלמטריה; ‏watchdog ‏30s
"net" | 0 | כל ה-WiFi/HTTP | ‏16KB stack; בקשה אחת לכל מעבר (שרשרת else-if); כל קריאות ‎WiFi.*‎ אך ורק כאן
"audio" | 0 | מיקרופון + רמקול | ‏4KB stack, עדיפות 5; ‏RMS רץ ברציפות, צלילים מתור

שעון הסשן רץ על esp_timer תקופתי (10ms) — כך שגם אם ה-loop נתקע רגעית, הזמן לא מדלג.

## 5.2 חציית גבולות בין משימות — בלי race conditions

מנגנון | מה עובר | כיוון
mutex s_mux (Cloud) | ‏TelemetrySnap (מדדים חיים) + CloudSettings (ה-downlink המפוענח) + תור שיעורי הבית | דו-כיווני loop⇄net
xQueue s_cmdQueue (8) | פקודות מרחוק (RemoteCmd: start/end/ring/message) | net → loop
xQueue s_chimeQ (4) | בקשות צליל | loop → audio
recursive mutex (Storage) | כל גישה ל-NVS (שתי הליבות כותבות) | —
recursive mutex (UploadQueue) | קבצי LittleFS של תור ההעלאה | —

## 5.3 מכונת המצבים — 16 מצבים

State | תפקיד
ST_BOOTING | אתחול
ST_IDLE | תפריט הבית; בודק לו"ז להתחלה אוטומטית, הודעות ממתינות, poll קונפיגורציה
ST_RUNNING | סשן פעיל: דגימות, התראות, נוכחות, אימון אדפטיבי
ST_PAUSED | מושהה; חזרה/סיום אוטומטיים לפי נוכחות
ST_COMPLETE | סיכום 2 שניות → הצעת סבב / שיעורי בית / בית
ST_CYCLE_OFFER | הצעת האינטרוול הבא (פומודורו רב-סבבים + הפסקה ארוכה)
ST_RESUME | שחזור סשן שנקטע (checkpoint ב-NVS — שורד ניתוק חשמל)
ST_PAIRING | קוד צימוד 6 ספרות; poll כל 3 שניות
ST_WIFI_SETUP | סריקת רשתות + מקלדת מגע על המכשיר (או פורטל SoftAP מהטלפון)
ST_AGENDA | מסך הלו"ז: היום + דפדוף 6 ימים קדימה (מהאתר)
ST_AUTOSTART | ספלאש 10 שניות לפני התחלה אוטומטית של בלוק לימוד — נגיעה מבטלת
ST_MESSAGE | הודעה/צלצול מרחוק מהאתר (30 שניות או נגיעה)
ST_HOMEWORK | עדכון שיעורי בית מהיר אחרי סשן עבודה (נגיעה=+25%, ארוכה=סיום)
ST_DIAG | מסך דיאגנוסטיקה חי (חיישנים + קודק)
ST_ERROR | תקלת חיישן קריטית (באס I2C תקוע) — לא נכשל בשקט
ST_LOGGING | (שמור; הכתיבה כיום סינכרונית)

## 5.4 עמידות לניתוקי חשמל ורשת

מנגנון | איך
Checkpoint של סשן | מצב הסשן נכתב ל-NVS; אחרי ניתוק חשמל המכשיר מציע "המשך או בטל" (ST_RESUME)
תור העלאות עמיד | סשנים שהסתיימו בלי רשת נשמרים כקבצי JSON ב-LittleFS (עד 12); מועלים עם backoff מעריכי ‎5s→5m; חותמות זמן של סשני-offline מתוקנות ברגע ש-NTP חוזר
הגדרות שרדו-poll | ה-CloudSettings האחרון נשאר ב-RAM; כשל poll לא מאפס כלום (השרת אף מחזיר 500 במקום ברירות-מחדל אם קריאת DB נכשלה)
Watchdog | ‏Task WDT ‏30s עם panic — ריסטארט נקי במקום תקיעה; סיבת האיפוס האחרונה מוצגת על מסך ה-boot

## 5.5 מפת מודולים (src/, מבנה שטוח)

MindBox.ino | סדר boot + לולאה ראשית + breadcrumbs | Cloud.* / Payload.* | משימת רשת, HTTP, ‏NTP; סריאליזציית סשנים
config.h / types.h | SSOT פינים/דגלים/קבועים; מבנים ו-enums | Sensors.* / Audio.* | חיישני סביבה + ToF; קודק I2S מיקרופון/רמקול
StateMachine.* / Session.* | ה-FSM; שעון סשן + דגימות + FLE | Sound.* / Haptics.* | צלילי אירועים (chimeMask); רטט (כבוי ב-S3)
Display.* / TimerScreen.* / Panel.* | API רינדור; מסך הטיימר; התקן LovyanGFX | Storage.* / UploadQueue.* | NVS; תור LittleFS
Inputs.* / Touch.* / Keyboard.* | מיזוג אנקודר+כפתור+מגע; דרייבר FT6336; מקלדת מגע | Menu.* / Theme.* / Diagnostics.* | עץ תפריטים; ערכות צבע; קונסולת serial

## 5.6 סדר ה-Boot (כל שלב מודפס למסך ול-Serial)

Storage(NVS) → Audio (soft-I2C codec BEFORE display claims the bus) → Display
→ reset-reason on screen (1.2s) → Inputs/Touch (calibration if needed) → Sensors (Wire+ToF)
→ UploadQueue (LittleFS) → Cloud (net task on core 0) → StateMachine → selfTest → WDT armed

הסדר אינו שרירותי: הקודק חייב להיות מתוכנת לפני שה-LovyanGFX תופס את פיני ה-I2C; המסך חייב לפני החיישנים כדי שתקלת חיישן תוצג; ה-selfTest רץ אחרון כשהכול למעלה.

# 6. פרוטוקול התקשורת מכשיר ↔ שרת

## 6.1 עקרון התכן: המכשיר תמיד יוזם

אין WebSocket ואין push — המכשיר הוא צד היוזם היחיד (polling). זה תכנון מכוון: (1) עמיד ל-NAT/רשתות סטודנטים; (2) אין חיבור פתוח שנשבר (נלחמנו בקריסות lwip/pbuf עד שעברנו ל-keep-alive מבוקר); (3) המכשיר מתפקד גם offline ומסנכרן כשחוזר. המחיר — שיהוי של עד דקה בפקודות מרחוק — מוצג בכנות ב-UI ("commands can take up to 60 seconds").

## 6.2 Uplink — מה המכשיר שולח

### סשן (בסיום; JSON נבנה ב-Payload.cpp)

[ { "deviceId", "profileId":"A", "sessionId":"<uuid>", "clientSeq",
    "startedAt"/"endedAt" (ISO-8601 UTC), "targetDurationSec", "actualFocusSec",
    "mode", "status", "breaks", "presenceInterruptions", "awayMs",
    "env": { "noiseAvg", "noisePeak", "tempC", "lightLux" },
    "focusLoadSamples": [ { "t", "value" }, ... ],   // עד 120 דגימות
    "focusLoadAvg",
    "envSamples":  [ { "t", "noise", "tempC", "lightLux" }, ... ] } ]

‏idempotent: העלאה חוזרת של אותו sessionId מעדכנת במקום לשכפל (upsert על device_id+id).

### טלמטריה (כל 30 שניות + במעברי מצב)

{ "deviceId", "ts", "state": "work|break|paused|idle", "batteryPct", "wifiRssi",
  "sensorHealth": { "tof":"ok", "mic":"ok", "light":"ok", "temp":"ok" },
  "firmwareVersion": "0.2.0-s3",
  "tempC": 24.5, "humidityPct": 48, "lightLux": 420, "noiseDb": 38 }   // רק כשחיישן קיים ותקין

## 6.3 Downlink — ‏GET /ingest/config (כל 60 שניות)

תשובת JSON שטוחה אחת עם 32 שדות שמכסה את כל שליטת האתר במכשיר. הפירוק בקושחה נעשה בפרסר ידני (ללא ספריית JSON — חיסכון בזיכרון), ולכן לרשימות יש קידוד קומפקטי משלנו:

קבוצה | שדות | הערות
הגדרות ליבה | paired, showTimer, hapticsEnabled, adaptiveCoaching, nudgesEnabled, quietStartMin/EndMin, dailyGoalMin, todayFocusSec, ownerDisplayName, ownerEmail, tzOffsetMin | מיושמות בכל poll בזמן צימוד
לו"ז | agendaStr, weekStr | ‏"start|end|kind|title;…"‎ להיום (≤12) ו-‏"day|start|end|kind|title;…"‎ לימים ‎+1..+6‎ (≤36); כותרות מחוטאות ו-≤23 בתים
סאונד (בבעלות האתר) | soundEnabled, soundLevel, chimeMask, autoStartEnabled | נאכפים בכל poll
ממשק | themeId, focusMin, breakMin, timingRev | ערכת צבעים; זמני פומודורו ב-adopt-once-per-revision (עריכה מקומית שורדת)
מצבים ונתונים | examMode, nextExamDays, nextExamTitle, streakDays, weekFocusMin, hwStr | DND במבחן; סטריק וסטטיסטיקה; 3 מטלות למסך שיעורי הבית
פקודות מרחוק | cmdId, cmdType, cmdArg, cmdText | פקודה אחת לכל poll — ראו 6.4

## 6.4 פרוטוקול הפקודות מרחוק — אמינות מעל polling

מנגנון | ערך | מה הוא פותר
פקודה אחת לכל תשובה + FIFO קפדני | — | סדר ביצוע מובטח; פקודה חדשה לא עוקפת ישנה שלא נמסרה
Ack ב-poll הבא + re-poll מיידי | &ack=<id> | אישור מסירה; צרור פקודות מתנקז בקצב ~1/שנייה
הגשה חוזרת של פקודה ללא ack | אחרי 75 שניות | אובדן תשובה ברשת; דדופ במכשיר לפי cmdId אחרון
תפוגה | 10 דקות | פקודה ישנה לא "תרדוף" מכשיר שחזר לרשת
ניקוי ב-unpair + סינון לפי בעלים | — | פקודות של בעלים קודם לעולם לא מגיעות לבעלים חדש
לחץ-חוזר (backpressure) | ≥5 ממתינות ⇒ דחייה | מכשיר כבוי לא צובר תור אינסופי

## 6.5 קצבים, timeouts ועמידות רשת

קבוע | ערך | הערה
Poll קונפיגורציה | 60s (paired) / 5s (unpaired) / 3s (pairing) | מהיר כשמחכים לצימוד
טלמטריה | 30s + on-transition (מרווח מינימלי 3s) | גם keep-alive לחיבור
HTTP timeouts | connect 1.5s / total 3s | בקשה תקועה לא מקפיאה את המשימה
Backoff אחרי כשל | 30s (רשת) · 5s→5m מעריכי (תור העלאות)
Keep-alive | HTTPClient יחיד, setReuse(true) | הפתרון לקריסות ‏lwip pbuf שאובחנו בפיתוח
NTP | pool.ntp.org, sync כל 12h | ‏UTC פנימי; ‏tzOffsetMin מהשרת לתצוגה מקומית
גודל תשובה מקסימלי | HTTP_MAX_BODY 8192 | מוגדל פעמיים ככל שה-downlink גדל (4096→6144→8192)

# 7. צד האתר: איך כל נתון נקלט, נשמר ומוצג

## 7.1 שני נתיבי דאטה, נקודת כניסה אחת

src/server.ts הוא ה-fetch entry: בקשות /ingest/* (מהמכשיר) ו-/jobs/* (cron) מפוצלות לפני ראוטר האפליקציה — מאומתות ב-shared secret וכותבות דרך service-role (עוקף RLS, עם בדיקת בעלות מחדש בקוד). כל השאר עובר דרך TanStack Start: סשן משתמש, Row-Level Security (כל משתמש רואה רק את השורות שלו), ו-CSRF guard על כל בקשה שאינה GET.

## 7.2 מפה: נתון מהמכשיר → טבלה → מסך

נתון | טבלה | איפה מוצג | קצב רענון UI
מצב/סוללה/WiFi/תקינות חיישנים | device_status | ‏/device (סטטוס + StateBadge), דשבורד | 10s
טמפ'/לחות/אור/רעש חיים + גרסת קושחה | device_status | ‏/device — "Room right now" + FW | 10s
חיווי Online/Last-seen | device_status.updated_at | ‏/device — נגזר בצד לקוח (סף 90s = ‏3× פעימה) | 10s + tick 15s
סשן מלא | sessions | דשבורד, היסטוריה, ‏/progress, ‏insights | לפי ניווט
דגימות דקה-בדקה (FLE + סביבה) | focus_load_samples · env_samples | ‏/session/$id — שני גרפי recharts (עומס+רעש; טמפ'+אור) | בכניסה לעמוד
קוד צימוד | device_pairing_codes | ‏/device — טופס OTP ‏6 ספרות (+deep-link ‏?code=) | —
עדכון שיעורי בית מהמכשיר | homework_assignments.progress_pct | ‏/assignments (קנבן) | ברענון הבא
פקודות מרחוק (סטטוס) | device_commands | ‏/device — ‏Remote control: ‏Queued→Sent→Done/Expired | 5s
צימוד/ניתוק | devices.owner_user_id | ‏/device — כרטיס "Your MindBox" | 5s

## 7.3 ומה חוזר למכשיר (מקורות ה-downlink)

שדה downlink | מקור באתר
agendaStr / weekStr / examMode | ‏schedule_events מורחבים ל-14 יום ביום-מקומי של המשתמש (יומן + מתכנן ה-AI)
streakDays / weekFocusMin / todayFocusSec | שאילתת sessions אחת (חלון 45 יום)
hwStr | ‏3 מטלות pending הקרובות מ-homework_assignments
sound/theme/timing/exam ועוד | ‏user_settings — כרטיס "MindBox device" ב-Settings
cmdId…cmdText | ‏device_commands — כרטיס Remote control

## 7.4 סימולטור — הדגמת הצד השרתי בלי חומרה

scripts/simulator.ts מדבר את אותו פרוטוקול HTTP בדיוק כמו הקושחה (אותם routes, אותו secret) — כלי הבדיקה המרכזי של האינטגרציה וגם רשת ביטחון לדמו. הרשימה המלאה בנספח; העיקריים: --config (מציג את ה-downlink המפוענח כפי שהמכשיר רואה), --send-command / --ack (מדמים את מחזור הפקודות), --sensor-fault / --low-battery (מדגימים את נתיב ההתראות), --no-env (מוכיח תאימות-לאחור של הסכמה).

# 8. לקחים הנדסיים — הבעיות האמיתיות שפתרנו

הפרק הזה הוא התשובה הישירה לחשש "עיקר המורכבות בתוכנה": אלה תקלות חומרה אמיתיות שאובחנו במעבדה, עם שיטת האבחון והפתרון — עומק חומרתי שאי אפשר לזייף.

## 8.1 Brownout — קריסות בעת התחברות WiFi

תסמין | ריסטארטים חוזרים ברגע שה-WiFi מתחבר; בהמשך — מסך שחור לגמרי (הלוח לא עולה) כשהוסיפו קודק+ToF ל-inrush
אבחון | esp_reset_reason() + לולאת E BOD: Brownout detector was triggered ב-Serial; ההצלבה: הזינוק בזרם של המשדר מפיל את קו ה-5V מיציאת USB חלשה של לפטופ
לקח מרכזי | ניסיון "לכבות את הגלאי" בקוד (DISABLE_BROWNOUT_DETECTOR) לא עוזר ומזיק: ESP-IDF חומש את הגלאי לפני setup(), כך שנפילת-מתח בשלב ה-boot מתרחשת לפני הקוד שלנו; השתקה רק הופכת ריסטארט נקי לתקיעה שחורה. הוחזר ל-0 במודע
פתרונות אמיתיים | ‏(1) WiFi.setTxPower(8.5dBm) — מרכך את זינוק ההתחברות; (2) כל קריאות ה-WiFi על ליבה 0 בלבד; (3) הקטנת זרם ה-boot; (4) ספק 5V חזק (מטען קיר 2A+) — הפתרון האמיתי היחיד; (5) סיבת האיפוס מוצגת על מסך ה-boot כדי לאבחן בלי מחשב

## 8.2 מיקרופון שמחזיר אפסים — קודק בלי שעון ADC

המיקרופון "עבד" (I2S רץ, אין שגיאות) אבל החזיר 0 קבוע. האבחון בכלי Audio::probe (פקודת a): הקודק עונה ל-ACK אבל min=max=0. שורש: רגיסטר ניהול השעונים של ES8311 ‏(0x01) לא הפעיל את שעון ה-ADC. התיקון — 0x01=0x3F. לקח: בקודקים, "אין שגיאה" ≠ "עובד"; חובה כלי probe שמראה דגימות גולמיות.

## 8.3 מלחמת ה-I2C — שלושה התקנים, שני masters, באס אחד

גרסה מוקדמת הריצה את המגע דרך LovyanGFX (master פנימי) ואת ה-ToF דרך Wire — שני masters על אותם פינים ⇒ המגע מת. הפתרון: master יחיד (Wire) עם דרייבר FT6336 שנכתב מאפס, קודק מתוכנת ב-soft-I2C רק בזמן boot, ו-watchdog שמזהה באס תקוע ומריץ ריקברי (9 clocks + STOP). לקח קלאסי של אינטגרציית חומרה: הבעיה לא בהתקנים — בבעלות על הבאס.

## 8.4 קריסות רשת אקראיות — lwip pbuf double-free

בחיבור ממושך הופיעו קריסות pbuf_free אקראיות. הטיפול: אובייקט HTTP יחיד עם setReuse(true) (חיבור keep-alive אחד במקום פתיחה/סגירה בכל בקשה), בקשה אחת בכל מעבר של משימת הרשת, ‏reconnect ידני מסודר במקום autoReconnect שרץ מ-ISR context. מאז — יציב.

## 8.5 פין אחד, שני תפקידים (IO21) — כשנשארו 4 פינים

כשנגמרו הפינים, DHT11 וכפתור הצד אוחדו על IO21 תוך ניצול העובדה שה-pull-up של ה-DHT הוא בדיוק ה-pull-up שהכפתור צריך, בתוספת חוק תוכנה: אין קריאת DHT בזמן לחיצה. תכנון משאבים תחת אילוץ אמיתי של הלוח.

## 8.6 מגבלות ידועות (בכנות)

מגבלה | סטטוס
פונטים במסך הם ASCII — כותרות בעברית מהלו"ז לא מוצגות בטקסט מלא | ידוע; פתרון עתידי: פונט עברי או תעתוק בצד השרת
DHT11 — דיוק לחות ±5% והקריאה מדלגת כשהכפתור לחוץ | מוצג "—" כשאין קריאה תקפה
סוללה לא מחווטת (HAS_BATTERY 0) | המדד באתר מוסתר מאחורי feature-flag
secret משותף אחד לכל המכשירים | מקובל לפרויקט קורס; מתועד ב-ASSUMPTIONS.md
שיהוי פקודות עד 60 שניות (polling) | מוצג במפורש ב-UI; תכנון מכוון (ראו 6.1)

# 9. פרק ההוכחות: טענה → הדגמה חיה → איפה רואים

העיקרון שקיבלנו מהצוות המנחה: כל טענה חייבת דרך הצגה ואימות. הטבלה הזו עוברת טענה-טענה; כל שורה ניתנת לביצוע בזמן אמת מול הקהל, בלי הכנה מוקדמת מעבר למכשיר דלוק + מחשב עם Serial + האתר פתוח.

## 9.1 טבלת ההוכחות

# | הטענה | ההדגמה החיה | איפה רואים את התוצאה

1 | המכשיר מדווח לענן כל 30 שניות | לפתוח ‎/device‎ ליד המכשיר ולחכות | נקודת Online ירוקה; ערכי "Room right now" מתעדכנים; כיבוי המכשיר ⇒ "Last seen" תוך 90 שניות
2 | מיקרופון I2S אמיתי מודד רעש | מחיאת כף / דיבור חזק ליד הקופסה | Serial ‏a: ‏RMS קופץ; מסך Diag: ‏pp קופץ; ‏dB בשורת ‎[mon]‎; הערך באתר בפעימה הבאה
3 | חיישן מרחק ToF מזהה נוכחות | להזיז יד קדימה/אחורה מול החיישן | Serial ‏m: ‏dist=Nmm משתנה חי; התרחקות בזמן סשן ⇒ חיווי Away על הטיימר
4 | טמפרטורה ולחות נמדדות | נשיפה חמה על ה-DHT11 | הטמפ' עולה ב-Serial/Diag תוך שניות וב-"Room right now" בהמשך
5 | חיישן אור עובד ומפעיל בהירות אוטומטית | לכסות את החיישן ביד | ה-lux צונח ב-Diag; המסך מתעמעם פיזית (auto-brightness)
6 | ההפרעות משפיעות על הסשן ומגיעות לענן דגימה-בדגימה | להריץ סשן קצר עם רעש מכוון והתרחקות אחת | עמוד ‎/session/$id‎ באתר: גרף עומס+רעש לאורך הדקות + ספירת ההפרעות — הנתונים שנאספו הרגע
7 | האתר שולט במכשיר מרחוק | ‏"Ring my device" מ-‏/device | המכשיר מצלצל תוך ≤60 שניות; באתר הסטטוס עובר Queued→Sent→Done בזמן אמת
8 | שינוי הגדרה באתר מגיע למכשיר | להחליף ערכת צבעים (Screen theme) ב-Settings | צבעי המסך מתחלפים בכל המכשיר תוך ≤60 שניות
9 | הלו"ז מהאתר חי על המכשיר | להוסיף אירוע להיום ביומן האתר | מסך Today במכשיר מציג אותו ב-poll הבא; דפדוף מציג את כל השבוע
10 | המכשיר מתחיל סשן לבד לפי הלו"ז | לקבוע בלוק לימוד שמתחיל בעוד 2–3 דקות | בהגיע הזמן: צליל + ספלאש "tap to cancel" ‏10 שניות ⇒ הסשן מתחיל לבד
11 | המכשיר כותב חזרה לדאטה של האתר | לסיים סשן עבודה ⇒ מסך שיעורי הבית ⇒ נגיעה ‎+25% | ‏/assignments באתר מציג את האחוז החדש
12 | עבודה offline מלאה + סנכרון | לכבות את הראוטר, להריץ סשן שלם, להדליק חזרה | Serial ‏q: הסשן בתור; אחרי חיבור — מופיע באתר עם הזמנים הנכונים (תוקנו ע"י NTP)
13 | תקלת חיישן מזוהה ומדווחת, לא נבלעת | לנתק פיזית את ה-DHT (או ‏--sensor-fault בסימולטור) | ‏sensorHealth בטלמטריה ⇒ שורת Fault אדומה ב-‏/device; ‏StateBadge עובר danger
14 | שרידות ניתוק חשמל באמצע סשן | לנתק את ה-USB באמצע סשן ולחבר | המכשיר עולה עם "Resume session?" מה-checkpoint; מסך ה-boot מציג את סיבת האיפוס
15 | העברת דאטה מוצפנת בזהות המכשיר | לנסות ‏curl ל-‏/ingest/config בלי ה-header | ‏401 — הצגת האימות; עם ה-header — ה-JSON המלא

## 9.2 תסריט דמו מומלץ (~10 דקות)

דקות | שלב | שורות מפתח
0–1 | הדלקה מול הקהל | ‏boot breadcrumbs על המסך, צליל boot (רמקול חי), selfTest ב-Serial מראה סריקת I2C ‏(0x38+0x29), ‏ToF, מיקרופון, אור, טמפ'
1–3 | "החיישנים חיים" — Serial ‏m | הזזת יד (מרחק), מחיאת כף (רעש), כיסוי אור (עמעום מסך), נשיפה (טמפ') — הכול בשורה מתעדכנת אחת
3–5 | סשן חי עם הפרעות | התחלת סשן, רעש מכוון ⇒ אייקון + התראה קולית; התרחקות ⇒ Away; בסיום — סיכום על המכשיר
5–7 | הדאטה בענן | ‏/session/$id — גרפי הדקה-בדקה של הסשן שהרגע הסתיים; ‏/device — ‏Room right now חי
7–9 | שליטה מרחוק דו-כיוונית | ‏Ring my device (עם סטטוס Queued→Sent→Done), החלפת theme, הוספת אירוע ליומן ⇒ מופיע על המכשיר
9–10 | עומק הנדסי | שקף ה-brownout (8.1) + ניתוק חשמל חי באמצע סשן ⇒ ‏Resume — "המערכת שורדת את העולם האמיתי"

גיבוי לדמו בלי חומרה: כל נתיב שרת ניתן להדגמה עם הסימולטור (נספח 10.2) — כולל מחזור הפקודות המלא (--send-command ⇒ ‏Queued באתר ⇒ ‏--config ⇒ ‏Sent ⇒ ‏--ack ⇒ ‏Done) ותרחישי סוללה חלשה/תקלת חיישן.

# 10. נספחים

## 10.1 פקודות קונסולת ה-Serial ‏(115200)

פקודה | מה היא עושה
m | מוניטור 1Hz: מצב, טיימר, נוכחות+מרחק, רעש, אור, טמפ', ‏ToF, ‏WiFi, כפתור, תקלות, תורים
d | אותו dump — חד-פעמי
a | ‏Audio probe: ‏ACK של הקודק + ‏min/max/DC/AC-RMS גולמיים מהמיקרופון
t / k | בדיקת מגע חיה (crosshair) / כיול מגע מחדש
b | בדיקת כפתור חיה ‎8 שניות (IO21)
c | כיול חיישנים: ‏c מציג; ‏c noise|db|light|lightvar|temp <v> מכוון; ‏c reset מאפס
q | מצב תור ההעלאות (ממתינים / הוותיק ביותר / הושלכו)
w | הגדרת WiFi / כתובת שרת / secret מה-Serial
h | עזרה

בנוסף: ‏selfTest מלא רץ בכל boot ומדפיס — גרסה, סיבת איפוס, זיכרון/PSRAM, סריקת I2C, מרחק ToF, בדיקת מיקרופון, אור, טמפ', ‏WiFi ורשימת הפקודות.

## 10.2 דגלי הסימולטור (bun run simulate -- ...)

דגל | מה מדגים
(ללא דגל) | זריעת מכשיר + ‏~30 יום של סשנים + טלמטריה רציפה
--config | מדפיס את ה-downlink המלא מפוענח — בדיוק מה שהמכשיר רואה (לו"ז, שבוע, theme, פקודה ממתינה...)
--send-command=<type>[:<arg>][:<text>] / --ack=<id> | מחזור פקודה מלא מול הסטטוסים באתר
--homework=<uuid>:<pct> | עדכון מטלה "מהמכשיר"
--offline-then-sync | צבירת סשנים ואז סנכרון בבת אחת (תרחיש חזרת-רשת)
--low-battery / --sensor-fault | ‏StateBadge אזהרה/תקלה + באנר סוללה באתר
--no-env | טלמטריה בלי שדות סביבה — הוכחת תאימות-לאחור
--user= / --device= / --ticks= / --interval= / --seed-only / --no-sessions | שליטה בזהות ובקצב; ‏bun run cleanup מנקה

## 10.3 שדות ה-Downlink — רפרנס מלא (‏GET /ingest/config)

שדה | טיפוס/טווח | תפקיד
paired | bool | האם המכשיר משויך לחשבון
showTimer, hapticsEnabled, adaptiveCoaching, nudgesEnabled | bool | הגדרות ליבה
quietStartMin / quietEndMin | 0–1439 / 65535 | שעות שקט (דקות מחצות; ‏65535=כבוי)
dailyGoalMin, todayFocusSec | int | יעד יומי + הפוקוס שנצבר היום (לפי היום המקומי)
ownerDisplayName, ownerEmail | str ≤19/31B | ברכת בעלים על המסך (מחוטא)
tzOffsetMin | int | אזור זמן המשתמש — כל חישובי "היום" מקומיים
agendaStr | "start|end|kind|title;…" ≤12 | לו"ז היום (מסך Today + התחלה אוטומטית)
weekStr | "day|start|end|kind|title;…" ≤36, ≤10/יום | ימים ‎+1..+6‎ לדפדוף
soundEnabled, soundLevel, chimeMask, autoStartEnabled | bool / 0–2 / bits / bool | סאונד בבעלות האתר; ‏mask: ‏0=לייפסייקל ‏1=סיום ‏2=מתוזמן ‏3=התראות
themeId | 0–4 | ערכת צבעים (טבלת presets זהה בקושחה ובאתר)
focusMin, breakMin, timingRev | 5–120 / 1–60 / epoch | זמני פומודורו; מאומצים פעם אחת לכל revision
examMode, nextExamDays, nextExamTitle | bool / −1..365 / str ≤23B | ‏DND במבחן (ידני או אוטומטי ביום מבחן) + באדג' ספירה
streakDays, weekFocusMin | int | סטריק ודקות השבוע למסך הסטטיסטיקה
hwStr | "uuid|title|pct;…" ≤3 | מטלות למסך העדכון המהיר
cmdId, cmdType, cmdArg, cmdText | int / 1..6 / int / str ≤40B | פקודה מרחוק אחת (‏1=start ‏4=end ‏5=ring ‏6=message)

כללי חיטוי לכל מחרוזת: הסרת ‏" \ | ; ותווי בקרה + קיטום לפי בתים של UTF-8 (מודול משותף device-string.ts + בדיקות יחידה) — כי הפרסר בקושחה מינימלי בכוונה.

## 10.4 בדיקות אוטומטיות

שכבה | מה
יחידה (אתר) | ‏278 בדיקות vitest — כל ה-encoders של פרוטוקול המכשיר, לוגיקת לו"ז/סטריק/מתכנן, ‏focus-load (זהה לקושחה)
אינטגרציה בלי חומרה | הסימולטור מדבר את ה-HTTP האמיתי מול השרת האמיתי
קושחה | קומפילציה נקייה (0 אזהרות) ב-arduino-cli; ‏selfTest חומרתי בכל boot; קונסולת אבחון

## 10.5 מסמכים משלימים בריפו

docs/ASSUMPTIONS.md | כל ההנחות והספים של פיצ'רי ה-AI וממשק המכשיר
docs/MindBox-Product-Overview.tex · MindBox-System-Architecture.tex | מסמכי מוצר וארכיטקטורת-אתר (LaTeX)
MindBox - hardware ESP32 S3 screen/MindBox/CLAUDE.md | מפת הקושחה העדכנית (המקור המוסמך בעץ)
README.md | התקנה, מיגרציות, סימולטור, פיצ'רי אתר↔מכשיר

מסמך זה נבנה מ-docs/system-guide/*.html; עדכון: ערכו את הפרק הרלוונטי והריצו npx tsx scripts/build-system-doc.ts.
