royavidan/IOT-Project-study-assistor/Documentation/MindBox-System-Guide.pdf

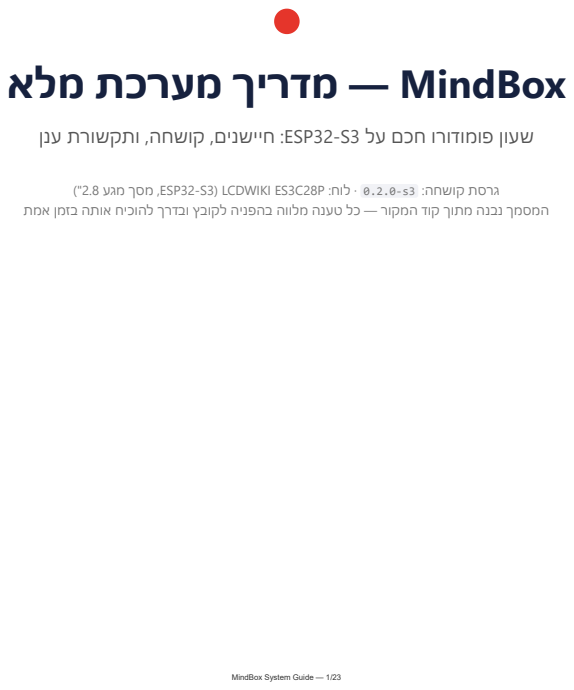
[picture p8: page 1]
)"2.8 מגע; מסך; ,ESP32-S3( LCDWIKI ES3C28P :לוח · 0.2.0-s3 :; קושחה; גרסת

MindBox — מדריך מערכת מלא

שעון פומודורו חכם על 3S32-ESP: חיישנים, קושחה, ותקשורת ענן

המסמך נבנה מתוך קוד המקור — כל טענה מלווה בהפניה לקובץ ובדרך להוכיח אותה בזמן אמת

MindBox System Guide — 1/23

# תוכן העניינים

.1 סקירת מערכת וארכיטקטורה .2 החומרה: הלוח, מפת הפינים והבאסים .3 החיישנים — אחד-אחד: עיקרון, חיווט, דרייבר, ועיבוד .4 עיבוד הנתונים על המכשיר )Load Focus, התראות סביבה, נוכחות( .5 ארכיטקטורת הקושחה )משימות, ליבות, מכונת מצבים( .6 פרוטוקול התקשורת מכשיר ↔ שרת .7 צד האתר: איך כל נתון נקלט, נשמר ומוצג .8 לקחים הנדסיים )Brownout, קונפליקטי C2I, שיתוף פינים( .9 פרק ההוכחות: טענה → הדגמה חיה → איפה רואים .10 נספחים: פקודות Serial, דגלי סימולטור, מפתחות NVS, שדות ה-Downlink

# .1 סקירת מערכת וארכיטקטורה

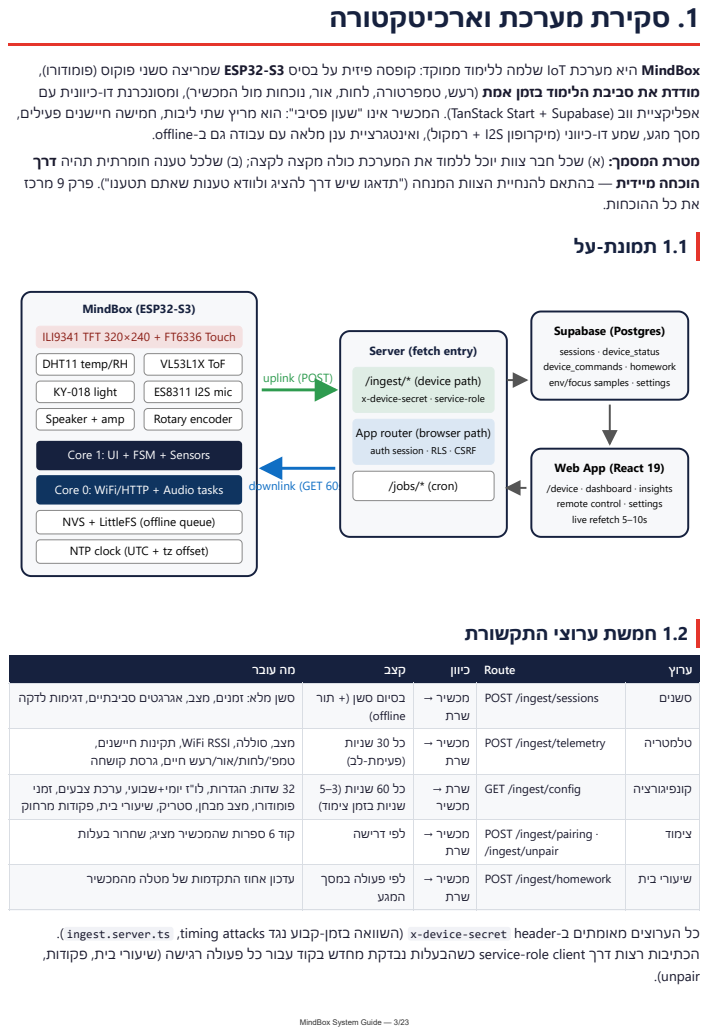
[picture p9: page 3]
MindBox (ESP32-S3); ILI9341 TFT 320×240 + FT6336 Touch; DHT11 temp/RH; VL53L1X ToF; KY-018 light; ES8311 I2S mic; Speaker + amp; Rotary encoder; uplink (POST); downlink (GET 60s); /jobs/* (cron); .) ingest.server.ts ,timing attacks נגד; קבוע-בזמן; השוואה; )x-device-secret header-ב; מאומתים; הערוצים; .)unpair

MindBox היא מערכת IoT שלמה ללימוד ממוקד: קופסה פיזית על בסיס 3S32-ESP שמריצה סשני פוקוס )פומודורו(,
מודדת את סביבת הלימוד בזמן אמת )רעש, טמפרטורה, לחות, אור, נוכחות מול המכשיר(, ומסונכרנת דו-כיוונית עם
אפליקציית ווב )Supabase + Start TanStack). המכשיר אינו "שעון פסיבי": הוא מריץ שתי ליבות, חמישה חיישנים פעילים,

מסך מגע, שמע דו-כיווני )מיקרופון S2I + רמקול(, ואינטגרציית ענן מלאה עם עבודה גם ב-offline.

מטרת המסמך: )א( שכל חבר צוות יוכל ללמוד את המערכת כולה מקצה לקצה; )ב( שלכל טענה חומרתית תהיה דרך
הוכחה מיידית — בהתאם להנחיית הצוות המנחה )"תדאגו שיש דרך להציג ולוודא טענות שאתם תטענו"(. פרק 9 מרכז

את כל ההוכחות.
1.1 תמונת-על

Supabase (Postgres)
sessions · device_status
device_commands · homework
env/focus samples · settings

Server (fetch entry)

/ingest/* (device path)
x-device-secret · service-role

App router (browser path)
auth session · RLS · CSRF

Core 1: UI + FSM + Sensors

Web App (React 19)
/device · dashboard · insights
remote control · settings
live refetch 5–10s

Core 0: WiFi/HTTP + Audio tasks

NVS + LittleFS (offline queue)
NTP clock (UTC + tz offset)

1.2 חמשת ערוצי התקשורת

ערוץ Route כיוון קצב מה עובר

סשן מלא: זמנים, מצב, אגרגטים סביבתיים, דגימות לדקה | בסיום סשן )+ תור )offline | → מכשיר שרת | POST /ingest/sessions | סשנים

מצב, סוללה, RSSI WiFi, תקינות חיישנים, טמפ'/לחות/אור/רעש חיים, גרסת קושחה | כל 30 שניות )פעימת-לב( | → מכשיר שרת | POST /ingest/telemetry | טלמטריה

32 שדות: הגדרות, לו"ז יומי+שבועי, ערכת צבעים, זמני פומודורו, מצב מבחן, סטריק, שיעורי בית, פקודות מרחוק | כל 60 שניות )3–5 שניות בזמן צימוד( | → שרת מכשיר | GET /ingest/config | קונפיגורציה

לפי דרישה קוד 6 ספרות שהמכשיר מציג; שחרור בעלות | מכשיר → שרת | POST /ingest/pairing · /ingest/unpair | צימוד

עדכון אחוז התקדמות של מטלה מהמכשיר | לפי פעולה במסך המגע | שרת | | שיעורי בית homework/ingest/ POST מכשיר →

הכתיבות רצות דרך client role-service כשהבעלות נבדקת מחדש בקוד עבור כל פעולה רגישה )שיעורי בית, פקודות,

הוכחה מהירה שהכול חי: פתחו את device/ באתר ליד המכשיר — נקודת ה-Online, הסוללה, עוצמת ה-WiFi ותנאי החדר )"now right Room )"מתעדכנים מכל פעימת טלמטריה )30 שניות מהמכשיר, רענון UI כל 10 שניות(. כבו את המכשיר — תוך 90 שניות החיווי יהפוך ל-"ago min X seen Last". ההרחבה המלאה בפרק .9

# .2 החומרה: הלוח, מפת הפינים והבאסים

## 2.1 הלוח

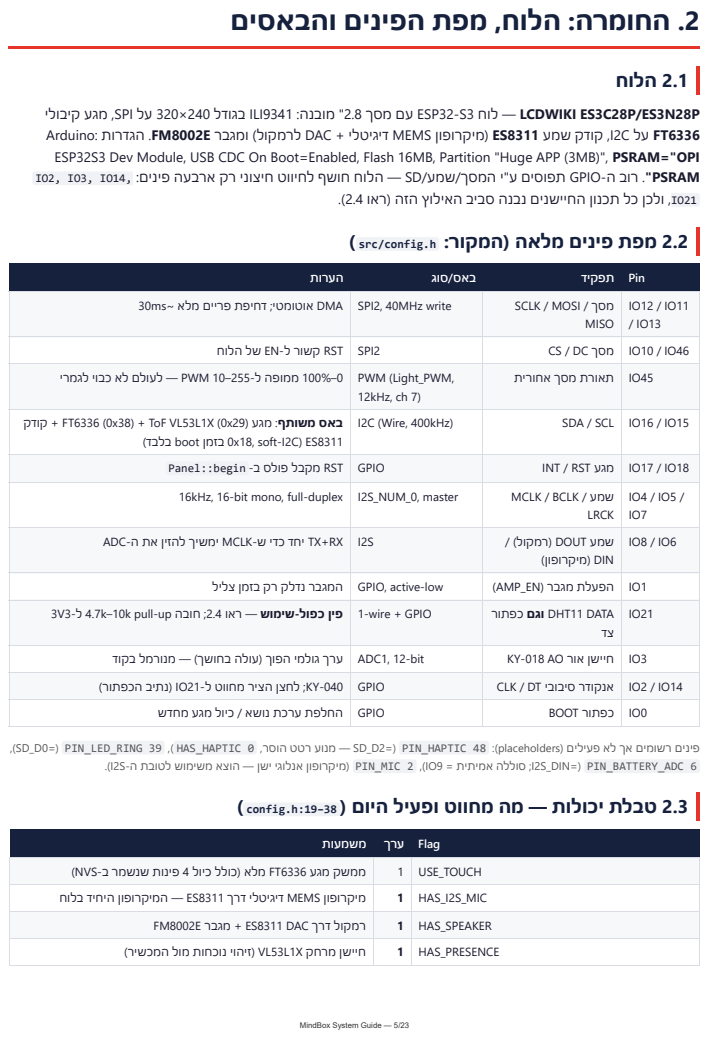
[picture p10: page 5]
קיבולי; מגע ,SPI על 320×240; בגודל; ILI9341 :; מובנה; " 2.8 מסך; עם ESP32-S3 לוח — LCDWIKI ES3C28P/ES3N28P; Arduino:; הגדרות; ומגבר; לרמקול; DAC +; דיגיטלי; MEMS; מיקרופון; )ES8311 שמע; קודק; ,)SD_D0=( PIN_LED_RING 39 ,) HAS_HAPTIC 0 ,הוסר; רטט; מנוע; — SD_D2=( PIN_HAPTIC 48 :)placeholders(; פעילים; רשומים; פינים; לטובת; משימוש; הוצא; — ישן; אנלוגי; )PIN_MIC 2 ,)IO9 =; אמיתית; סוללה; ; I2S_DIN=( PIN_BATTERY_ADC 6

ESP32S3 Dev Module, USB CDC On Boot=Enabled, Flash 16MB, Partition "Huge APP (3MB)", PSRAM="OPI
PSRAM". רוב ה-GPIO תפוסים ע"י המסך/שמע/SD — הלוח חושף לחיווט חיצוני רק ארבעה פינים: 14,IO 3,IO 2,IO

21IO, ולכן כל תכנון החיישנים נבנה סביב האילוץ הזה )ראו 2.4(.
2.2 מפת פינים מלאה )המקור: h.config/src)

Pin תפקיד באס/סוג הערות

30ms~ מלא פריים דחיפת ; אוטומטי DMA | SPI2, 40MHz write | SCLK / MOSI / מסך MISO | IO12 / IO11 / IO13

הלוח של EN-ל קשור RST | SPI2 | CS / DC מסך | IO10 / IO46

0–100% ממופה ל255-–10 PWM — לעולם לא כבוי לגמרי | PWM (Light_PWM, 12kHz, ch 7) | אחורית מסך תאורת | IO45

קודק + FT6336 (0x38) + ToF VL53L1X (0x29) מגע : משותף באס ) בלבד boot בזמן 0x18, soft-I2C( ES8311 | I2C (Wire, 400kHz) | SDA / SCL | IO16 / IO15

Panel::begin -ב פולס מקבל RST | GPIO | INT / RST מגע | IO17 / IO18
16kHz, 16-bit mono, full-duplex | I2S_NUM_0, master | MCLK / BCLK / שמע LRCK | IO4 / IO5 / IO7

S2I RX+TX יחד כדי ש-MCLK ימשיך להזין את ה-ADC | / ) רמקול )DOUT שמע DIN( מיקרופון( | IO8 / IO6

1IO הפעלת מגבר )EN_AMP )low-active ,GPIO המגבר נדלק רק בזמן צליל

3V3-ל 4.7k–10k pull-up חובה ; 2.4 ראו — שימוש -כפול פין | 1-wire + GPIO | כפתור וגם DHT11 DATA צד | IO21

3IO חיישן אור AO -018KY bit12- 1,ADC ערך גולמי הפוך )עולה בחושך( — מנורמל בקוד
14IO / 2IO אנקודר סיבובי DT / CLK GPIO -040KY ;לחצן הציר מחווט ל21-IO( נתיב הכפתור(

0IO כפתור BOOT GPIO החלפת ערכת נושא / כיול מגע מחדש

2.3 טבלת יכולות — מה מחווט ופעיל היום ) 38–:19h.config)

Flag ערך משמעות

TOUCH_USE 1 ממשק מגע 6336FT מלא )כולל כיול 4 פינות שנשמר ב-NVS)
MIC_S2I_HAS 1 מיקרופון MEMS דיגיטלי דרך 8311ES — המיקרופון היחיד בלוח

FM8002E מגבר + ES8311 DAC דרך רמקול | 1 | HAS_SPEAKER
PRESENCE_HAS 1 חיישן מרחק X1L53VL( זיהוי נוכחות מול המכשיר(

| | LIGHT_HAS 1 פוטורזיסטור -018KY( לוקס + תנודתיות תאורה(
לחות + טמפרטורה — DHT11 | 1 | HAS_TEMP
KY-040 סיבובי אנקודר | 1 | HAS_ENCODER
NTP + WiFi + סנכרון ענן מלא | / 1 1 | ENABLE_WIFI / ENABLE_CLOUD
משימוש | 0 רטט הוסר; טבעת LED לא מחווטת; סוללה stub ;מיקרופון אנלוגי הוצא | HAS_HAPTIC / HAS_LED_RING / HAS_BATTERY / HAS_MIC

## 2.4 שלושת אילוצי החיווט המרכזיים )ולמה הם החלטות הנדסיות(

### א. באס C2I אחד, שלושה התקנים, master אחד

LovyanGFX( I2C masters שני | להריץ | מוקדם | ניסיון | . IO16/IO15 | את | חולקים | ( 0x18( | והקודק | ToF (0x29)-ה ,(0x38( | המגע
פנימי + Wire )גרם לקריסת המגע; הפתרון הסופי: דרייבר מגע custom שקורא 6336FT ישירות דרך Wire( רגיסטרים 06x0–02x0), כך שכל ההתקנים על master יחיד. הקודק מתוכנת פעם אחת ב-boot דרך (kHz125 ~bang-bit (C2I-soft לפני ש-LovyanGFX תופס את הפינים, ואז משוחרר. בנוסף קיים watchdog C2I: בדיקת ACK ל-ToF כל 2 שניות; שני כשלים רצופים מפעילים ריקברי )9 פולסים + init-re + STOP).

### ב. 21IO — פין אחד, שני תפקידים

ה11-DHT וכפתור הצד חולקים את 21IO. זה עובד כי: )1( ה-up-pull של ה-DHT מחזיק את הקו HIGH, בדיוק מה שכפתור low-active צריך במנוחה; )2( הקושחה מדלגת על קריאת DHT כשהכפתור לחוץ ) cpp.Sensors — בדיקת digitalRead LOW לפני קריאה(, כך ששני השימושים לא מתנגשים.

### ג. ארבעה פינים חופשיים בלבד

הלוח חושף רק את 21IO14/IO3/IO2/IO — ולכן כל חיישן חיצוני "מתחרה" על פינים: האנקודר קיבל את 14IO2/IO, האור את 3IO, וה-DHT את 21IO( במשותף עם הכפתור(. ה-ToF עבר לבאס המגע הקיים במקום לצרוך זוג פינים. 14IO הוא גם 2ADC — לא שמיש כ-ADC לצד WiFi פעיל, עוד שיקול במיפוי.

אזהרת דוקומנטציה ישנה: בקבצים היסטוריים בעץ יש מידע מיושן — md.HARDWARE/docs מתאר את לוח ה32-ESP הקלאסי )לא ה3-S), ו- md.WIRING/docs עדיין מתעד מיקרופון אנלוגי על 2IO ו"אין קוד שמע" — שניהם הוחלפו )המיקרופון היום S2I דרך הקודק, והשמע פעיל במלואו(. המסמך הזה + h.config/src הם המקור העדכני.

# .3 החיישנים — אחד-אחד

לכל חיישן: איך הוא עובד פיזיקלית, איך הוא מחווט, איפה הדרייבר, באיזה קצב הוא נדגם, איך הקריאה הגולמית הופכת ליחידות, איך מזוהות תקלות — ואיך מוכיחים שהוא חי.

## 3.1 11DHT — טמפרטורה ולחות

עיקרון
פיזיקלי

מדחום תרמיסטור + חיישן לחות קיבולי; פרוטוקול -1wire קנייני )רצף פולסים מתוזמן על קו דאטה אחד(

DATA→3V3 חובה 4.7k–10k VCC→3V3, GND; pull-up ,) הצד כפתור עם משותף )DATA→IO21 | חיווט
DHT ספריית , Sensors.cpp — refreshDht() | דרייבר
| קצב דגימה כל ms2000 ( MS_INTERVAL_READ_DHT — ) מגבלת החיישן עצמו; 5 שניות warmup אחרי boot
| עיבוד טמפ' + offset כיול ) tempOffsetC::Storage , פקודת serial temp c ;) תיחום תקינות C60°…−20 ;לחות 0–100%
Fault אדומה בעמוד device/ | תקלות קריאה מחוץ לטווח/NaN ⇒ false=tempPresent" ⇒ invalid":"temp "ב-sensorHealth של הטלמטריה ⇒ שורת

הוכחה: m ב-Serial מציג טמפ' חיה; נשיפה חמה על החיישן מעלה את הערך תוך 4–2 שניות גם בשורת [mon[, גם במסך ה-Diag במכשיר, וגם ב-"now right Room "באתר )עדכון ≥30 שניות(.

) | נוכחות | )Time-of-Flight | מרחק | חיישן | — VL53L1X 3.2

עיקרון
פיזיקלי

לייזר IR nm940 + מדידת זמן-טיסה של פוטונים )array SPAD ⇒ )מרחק במ"מ עד ~m,4 ללא תלות בצבע המשטח

| חיווט על באס ה-C2I המשותף )15IO16/IO), כתובת 29x0
50ms timing budget ,long-range מצב ; Adafruit_VL53L1X ספריית , Sensors.cpp | דרייבר
תקין נחשב 0–4000mm רק ; dataReady→distance→clearInterrupt :) TOF_POLL_MS ( 500ms כל | דגימה קצב
הפרעות-נוכחות והשהיה אוטומטית | עיבוד נוכחות = מרחק > mm700 ( MM_NEAR_PRESENCE ;) נמדד גם משך היעדרות רציף ) absentForMs ) שמזין ספירת
שקטה( | תקלות watchdog C2I כל s2 על 29x0 ;שני NACK רצופים ⇒ ריקברי-באס; SDA תקוע ⇒ ERROR_ST על המסך )תקלה קריטית, לא

הוכחה: m ב-Serial מציג Nmm=dist חי — הזיזו יד מול החיישן וראו את המספר קופץ. בזמן סשן: התרחקות <15 שניות מציגה חיווי Away על מסך הטיימר וסופרת interruption presence שמגיע עד גרף הסשן באתר.

## 3.3 -018KY — חיישן אור )פוטורזיסטור(

עיקרון
פיזיקלי

נגד תלוי-אור )LDR): ההתנגדות יורדת באור; נמדד כמתח על מחלק דרך ADC

3V3-מ מוזן ,(bit-12 ,ADC1( AO→IO3 | חיווט
| דרייבר cpp.Sensors — חלון max/min של שנייה
ב- light c ;) תנודתיות varScale/)min−max = (lightVar — מזהה תאורה מהבהבת ומזין את מדד העומס | עיבוד ההיפוך ) HIGH_DARK_RAW_LIGHT — הגולמי עולה בחושך( ⇒ luxScale × /4095mid = lux( ברירת מחדל ,1000 כיול

שימושים התראת אור נמוך/גבוה )ספים 50–1000 lux), בהירות מסך אוטומטית )מיפוי 100%–20→lux עם היסטרזיס 5%(, רכיב ב-Focus Load

הוכחה: כסו את החיישן ביד — במסך Diag ובשורת [mon [ה-lux צונח, ואם brightness-auto פעיל המסך מתעמעם בפועל תוך שנייה-שתיים; באתר הערך מגיע בפעימת הטלמטריה הבאה.

## 3.4 מיקרופון MEMS דיגיטלי — דרך קודק (S2I (8311ES

עיקרון
פיזיקלי

ממברנת MEMS קיבולית ⇒ ADC בתוך הקודק ⇒ דגימות PCM דיגיטליות על באס S2I — אין שום דרך לקרוא אותו כ-analogRead

)boot-ב soft-I2C( 0x18 I2C-ב הקודק תכנות ; MCLK4/BCLK5/LRCK7 שעונים ,DIN=IO6 :בלוח מובנה | חיווט
המיקרופון "עובד" ומחזיר אפסים(; משימת FreeRTOS ייעודית על ליבה 0 | דרייבר cpp.Audio — רצף אתחול רגיסטרים מלא )כולל התיקון הקריטי: reg F3x0=01x0 שמדליק את שעון ה-ADC — בלעדיו
kHz,16 -16mono bit, פריימים של 256 דגימות )~ms16), חלון RMS של ~שנייה | קצב דגימה
:dB SPL וגם ( ⇒ 1–0 )micLevel = rms/1000 ⇒ )DC bias מסיר )var = mean(v²) − mean(v)² :AC-RMS 116 + (/32768rms(10log·20( offset מכויל, db c) . סף התראת רעש: dB60( מתכוונן 40–80 בתפריט( | עיבוד
| תקלות micOk = המשימה מדווחת נתונים חיים; כשל אתחול קודק ⇒ NO=ack-boot ב- probe::Audio

הוכחה: פקודת a ב-Serial מדפיסה ACK-boot של הקודק + RMS/max/min גולמיים — מחיאת כף מקפיצה את ה-RMS בסדר גודל. מסך ה-Diag מציג pp( peak-to-peak )שקופץ עם כל רעש, וה-dB חי בשורת [mon [וב-"right Room now "באתר.

FM8002E | מגבר | + ES8311 DAC — | רמקול | 3.5
רמקול | ⇒ class-AB | מגבר | ⇒ I2S TX ⇒ DAC-ל | נכתבים | ( Note{freq,ms} ( sine | רצפי | : | בתוכנה | צלילים | סינתזת | עיקרון
)3 דרגות( | שליטה המגבר )1IO=EN_AMP, low-active )נדלק רק בזמן צליל — חיסכון בזרם ורחש; עוצמה = סקיילינג אמפליטודה בתוכנה
מלאה, עוקף כל השתקה( | רפרטואר 8 צלילים: התחלה/השהיה/המשך/סיום/בדיקה/התחלה-מתוזמנת/התראה/RING( צלצול my-find ב11- תווים בעוצמה
מסך Settings באתר קובע: מתג ראשי, עוצמה, אילו צלילים )chimeMask — )נאכף במכשיר בכל poll | שליטה מהאתר

הוכחה: צליל boot נשמע בכל הדלקה )מוכיח חיווט מגבר(; "sound Test "בתפריט; ומהאתר — כפתור "my Ring device "מפעיל צלצול תוך ≥60 שניות כשהסטטוס באתר עובר Done→Sent→Queued.

## 3.6 מסך מגע — 6336FT( קיבולי( + 9341ILI

עיקרון מגע קיבולי: שינוי קיבול ברשת אלקטרודות; הבקר מחזיר קואורדינטות מוחלטות ב-C2I

את האוריינטציה | דרייבר cpp.Touch — קריאת רגיסטרים ישירה )02x0 ספירה, 06x0–03x0 Y/X )על Wire המשותף; כיול 4 פינות שנשמר ב-NVS ולומד
| רינדור sprite + LovyanGFX 332RGB( KB,75 נופל ל-PSRAM בעת הצורך(; דחיפת פריים ~ms30

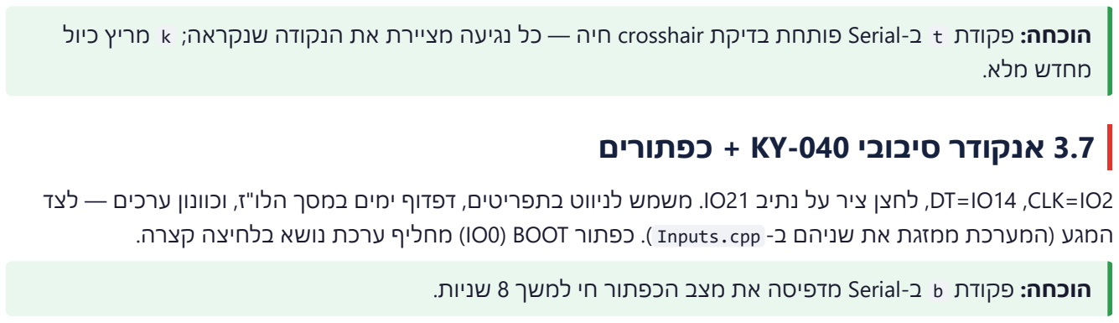
[picture p11: figure]
מחדש מלא.; 3.7 אנקודר סיבובי -040KY + כפתורים

הוכחה: פקודת t ב-Serial פותחת בדיקת crosshair חיה — כל נגיעה מציירת את הנקודה שנקראה; k מריץ כיול

2IO=CLK, 14IO=DT, לחצן ציר על נתיב 21IO. משמש לניווט בתפריטים, דפדוף ימים במסך הלו"ז, וכוונון ערכים — לצד המגע )המערכת ממזגת את שניהם ב- cpp.Inputs) . כפתור BOOT( 0IO )מחליף ערכת נושא בלחיצה קצרה.

הוכחה: פקודת b ב-Serial מדפיסה את מצב הכפתור חי למשך 8 שניות.

# .4 עיבוד הנתונים על המכשיר

הקריאות הגולמיות לא נשלחות "כמו שהן" — המכשיר מריץ עליהן עיבוד בזמן אמת שמפיק מדדים, התראות והחלטות. זה הלב האלגוריתמי של הקושחה.
הריכוז | עומס | מדד | ( — FLE( Focus Load Estimate 4.1

נוסחה דטרמיניסטית ) h.load_focus/src , זהה 1:1 לקוד האתר ב- ts.load-focus/lib/src — אותו מספר מחושב בשני הצדדים(:

FLE = 100 × [ 0.3·(elapsed/target) + 0.3·noise + 0.2·lightVar + 0.2·min(presenceInterruptions/5, 1) ]

רכיב משקל מקור

התקדמות בסשן )עייפות מצטברת( 30% שעון הסשן רעש סביבתי מנורמל )0–1( 30% מיקרופון S2I( RMS-AC)

תנודתיות תאורה )0–1( 20% -018KY( חלון max/min)

הפרעות נוכחות )עד 5( 20% ToF( ספירת יציאות(

מחושב לכל דגימה בתוך סשן; 75 < FLE מפעיל אימון אדפטיבי )הצעת הפסקה, cooldown 5 דקות( אם המשתמש הפעיל זאת.

## 4.2 התראות סביבה )Interference — )ספים מפורשים

()currentInterference — cpp.StateMachine ; סדר עדיפויות: היעדרות < רעש < טמפרטורה < אור. כל התראה פעילה רק אם החיישן מחווט ) *_HAS ) והמשתמש לא כיבה אותה בתפריט Environment:

התראה תנאי ברירת מחדל )מתכוונן(

| | AWAY ToF לא מזהה נוכחות מרחק ≤ mm700
| | HIGH_NOISE רעש מעל סף 60 SPL dB( טווח כוונון 40–80(
26°C–18 | נוחות לתחום מחוץ | TEMP_HIGH / TEMP_LOW
lux 1000–50 | לתחום מחוץ | LIGHT_HIGH / LIGHT_LOW

התראה שנמשכת 30 שניות רציפות מפיקה nudge קולי )צליל Alert, מוגבל לאחת כל 3 דקות בסשן, מושתק במצב מבחן(. מסך הטיימר מציג אייקוני סביבה חיים )חום/רעש/היעדרות( + שורת אזהרה, וההפרעה החמורה ביותר נשמרת ומוצגת בסיכום הסשן )DONE).

## 4.3 ספירת הפרעות נוכחות ו-Away

מעבר away→present נספר פעם אחת )counting-edge )רק אחרי שההיעדרות עוברת את סף הזמן — כדי שהליכה רגעית לא תיספר. משך ההיעדרות נצבר בנפרד ) awayMs ) ונשלח לשרת, כך שהאתר יכול לחשב "זמן פוקוס אמיתי" = משך − היעדרויות. אופציית pause-auto משהה את הסשן אוטומטית בהיעדרות ממושכת ומחדשת בחזרה.

## 4.4 דגימות ואגרגטים של סשן

מה ערך

60s / 30s / 120s | קצב דגימה בעבודה / באימון אדפטיבי / בהפסקה
| תקרת דגימות לסשן 120 ) SAMPLES_MAX)
{t, fle, noise, tempC, lightLux} | דגימה כל
focusLoadAvg | אגרגטים בסיום ,(ממוצע)lightLux ,)ממוצע)tempC ,noisePeak ,noiseAvg

הדגימות עולות לשרת עם הסשן ומזינות את גרפי הדקה-בדקה בעמוד פירוט הסשן באתר — זו ההוכחה הוויזואלית החזקה ביותר לרציפות המדידה )ראו פרק 9(.

## 4.5 בהירות מסך אוטומטית

כשמופעל )ולא בשעות שקט(: (100–20 → 1000–0 lux(map = %brightness בקצב ~Hz1 עם היסטרזיס 5% )בלי הבהוב(. שעות שקט מעמעמות ל15%-; שליטה ידנית זמינה בתפריט.

## 4.6 החלטות מקומיות מול החלטות ענן — חלוקת אחריות

החלטה איפה למה

| מכשיר זמן-אמת; חייב לעבוד גם בלי רשת | auto- ,auto-pause ,FLE , סביבה התראות brightness
עמידות לניתוקים — השרת לא "דוחף", המכשיר מחליט לפי השעון | שהורד( | התחלה אוטומטית של סשן מתוזמן מכשיר )שעון NTP + לו"ז
| שרת )downlink )מקור אמת אחד = היומן באתר | לו"ז, ערכת נושא, זמני פומודורו, מצב מבחן, סטריק
| | אנליטיקות, wellbeing, תכנון AI שרת דורש היסטוריה מלאה וכוח חישוב

# .5 ארכיטקטורת הקושחה

## 5.1 שלוש משימות, שתי ליבות

משימה ליבה תפקיד פרטים

קלט → FSM → רינדור → פרסום טלמטריה; watchdog s30 | חיישנים | 1 UI + מכונת מצבים + | Arduino loop
כאן | | | "net "0 כל ה-HTTP/WiFi stack KB16 ;בקשה אחת לכל מעבר )שרשרת if-else ;)כל קריאות *.WiFi אך ורק
| | | "audio "0 מיקרופון + רמקול stack KB,4 עדיפות 5; RMS רץ ברציפות, צלילים מתור

שעון הסשן רץ על timer_esp תקופתי )ms10 — )כך שגם אם ה-loop נתקע רגעית, הזמן לא מדלג.

## 5.2 חציית גבולות בין משימות — בלי conditions race

מנגנון מה עובר כיוון

דו-כיווני loop⇄net | תור +( המפוענח downlink-ה )CloudSettings + ) חיים מדדים )TelemetrySnap שיעורי הבית | mutex s_mux (Cloud)
net → loop | )RemoteCmd: start/end/ring/message( מרחוק פקודות | xQueue s_cmdQueue (8)
loop → audio | צליל בקשות | xQueue s_chimeQ (4)
| | (Storage (mutex recursive כל גישה ל-NVS( שתי הליבות כותבות( —
| קבצי LittleFS של תור ההעלאה — | recursive mutex (UploadQueue)

## 5.3 מכונת המצבים — 16 מצבים

State תפקיד

אתחול | ST_BOOTING
| IDLE_ST תפריט הבית; בודק לו"ז להתחלה אוטומטית, הודעות ממתינות, poll קונפיגורציה
| RUNNING_ST סשן פעיל: דגימות, התראות, נוכחות, אימון אדפטיבי
| PAUSED_ST מושהה; חזרה/סיום אוטומטיים לפי נוכחות
| COMPLETE_ST סיכום 2 שניות → הצעת סבב / שיעורי בית / בית
| OFFER_CYCLE_ST הצעת האינטרוול הבא )פומודורו רב-סבבים + הפסקה ארוכה(
| RESUME_ST שחזור סשן שנקטע )checkpoint ב-NVS — שורד ניתוק חשמל(
| PAIRING_ST קוד צימוד 6 ספרות; poll כל 3 שניות
| SETUP_WIFI_ST סריקת רשתות + מקלדת מגע על המכשיר )או פורטל SoftAP מהטלפון(
| AGENDA_ST מסך הלו"ז: היום + דפדוף 6 ימים קדימה )מהאתר(
| AUTOSTART_ST ספלאש 10 שניות לפני התחלה אוטומטית של בלוק לימוד — נגיעה מבטלת
| MESSAGE_ST הודעה/צלצול מרחוק מהאתר )30 שניות או נגיעה(
| HOMEWORK_ST עדכון שיעורי בית מהיר אחרי סשן עבודה )נגיעה=,25%+ ארוכה=סיום(

DIAG_ST מסך דיאגנוסטיקה חי )חיישנים + קודק( ERROR_ST תקלת חיישן קריטית )באס C2I תקוע( — לא נכשל בשקט LOGGING_ST( שמור; הכתיבה כיום סינכרונית(

## 5.4 עמידות לניתוקי חשמל ורשת

מנגנון איך

מצב הסשן נכתב ל-NVS ;אחרי ניתוק חשמל המכשיר מציע "המשך או בטל" )RESUME_ST) | Checkpoint של סשן
סשנים שהסתיימו בלי רשת נשמרים כקבצי JSON ב-LittleFS( עד 12(; מועלים עם backoff מעריכי m5→s5 ;חותמות זמן של סשני-offline מתוקנות ברגע ש-NTP חוזר | תור העלאות עמיד
ה-CloudSettings האחרון נשאר ב-RAM ;כשל poll לא מאפס כלום )השרת אף מחזיר 500 במקום ברירות-מחדל אם קריאת DB נכשלה( | הגדרות שרדו-poll
| Watchdog WDT Task s30 עם panic — ריסטארט נקי במקום תקיעה; סיבת האיפוס האחרונה מוצגת על מסך ה-boot

## 5.5 מפת מודולים ) /src , מבנה שטוח(

;NTP ,HTTP ,רשת משימת סריאליזציית סשנים | Cloud.* / Payload.* | breadcrumbs | ino.MindBox סדר boot + לולאה ראשית +
I2S קודק ; ToF + סביבה חיישני מיקרופון/רמקול | Sensors.* / Audio.* | enums | h.types / h.config SSOT פינים/דגלים/קבועים; מבנים ו-
)כבוי ב3-S) | | ה-FSM ;שעון סשן + דגימות + FLE* .Haptics /* .Sound צלילי אירועים )chimeMask ;)רטט | StateMachine.* / Session.*
LittleFS תור; NVS | Storage.* / UploadQueue.* | API רינדור; מסך הטיימר; התקן LovyanGFX | Display.* / TimerScreen.* / Panel.*
עץ תפריטים; ערכות צבע; קונסולת serial | Menu.* / Theme.* / Diagnostics.* | מיזוג אנקודר+כפתור+מגע; דרייבר 6336FT ;מקלדת מגע | Inputs.* / Touch.* / Keyboard.*

## 5.6 סדר ה-Boot( כל שלב מודפס למסך ול-Serial)

Storage(NVS) → Audio (soft-I2C codec BEFORE display claims the bus) → Display
→ reset-reason on screen (1.2s) → Inputs/Touch (calibration if needed) → Sensors (Wire+ToF)
→ UploadQueue (LittleFS) → Cloud (net task on core 0) → StateMachine → selfTest → WDT armed

הסדר אינו שרירותי: הקודק חייב להיות מתוכנת לפני שה-LovyanGFX תופס את פיני ה-C2I ;המסך חייב לפני החיישנים כדי שתקלת חיישן תוצג; ה-selfTest רץ אחרון כשהכול למעלה.

# .6 פרוטוקול התקשורת מכשיר ↔ שרת

## 6.1 עקרון התכן: המכשיר תמיד יוזם

אין WebSocket ואין push — המכשיר הוא צד היוזם היחיד )polling). זה תכנון מכוון: )1( עמיד ל-NAT/רשתות סטודנטים; )2( אין חיבור פתוח שנשבר )נלחמנו בקריסות pbuf/lwip עד שעברנו ל-alive-keep מבוקר(; )3( המכשיר מתפקד גם offline ומסנכרן כשחוזר. המחיר — שיהוי של עד דקה בפקודות מרחוק — מוצג בכנות ב-to up take can commands ("UI .60 seconds")

## 6.2 Uplink — מה המכשיר שולח

### סשן )בסיום; JSON נבנה ב- cpp.Payload)

[ { "deviceId", "profileId":"A", "sessionId":"<uuid>", "clientSeq", "startedAt"/"endedAt" (ISO-8601 UTC), "targetDurationSec", "actualFocusSec", "mode", "status", "breaks", "presenceInterruptions", "awayMs",
"env": { "noiseAvg", "noisePeak", "tempC", "lightLux" },
"focusLoadSamples": [ { "t", "value" }, ... ], | // | דגימות | 120 עד
"focusLoadAvg",
"envSamples": [ { "t", "noise", "tempC", "lightLux" }, ... ] } ]

idempotent: העלאה חוזרת של אותו sessionId מעדכנת במקום לשכפל )upsert על id+id_device).

### טלמטריה )כל 30 שניות + במעברי מצב(

{ "deviceId", "ts", "state": "work|break|paused|idle", "batteryPct", "wifiRssi", "sensorHealth": { "tof":"ok", "mic":"ok", "light":"ok", "temp":"ok" },
"firmwareVersion": "0.2.0-s3",
רק כשחיישן קיים ותקין // { 38 :"noiseDb "420, :"lightLux "48, :"humidityPct "24.5, :"tempC"
) | שניות | 60 כל )GET /ingest/config — Downlink 6.3

תשובת JSON שטוחה אחת עם 32 שדות שמכסה את כל שליטת האתר במכשיר. הפירוק בקושחה נעשה בפרסר ידני )ללא ספריית JSON — חיסכון בזיכרון(, ולכן לרשימות יש קידוד קומפקטי משלנו:

קבוצה שדות הערות

מיושמות בכל poll בזמן צימוד | paired, showTimer, hapticsEnabled, adaptiveCoaching, nudgesEnabled, quietStartMin/EndMin, dailyGoalMin, todayFocusSec, ownerDisplayName, ownerEmail, tzOffsetMin | הגדרות ליבה
)12≤( להיום start|end|kind|title;…"" ;+1..+6 (≤36) לימים day|start|end|kind|title;…""-ו כותרות מחוטאות ו-≥23 בתים | agendaStr, weekStr | ז"לו
poll בכל נאכפים | soundEnabled, soundLevel, chimeMask, autoStartEnabled | סאונד )בבעלות האתר(
adopt-once-per--ב פומודורו זמני ; צבעים ערכת revision( עריכה מקומית שורדת( | themeId, focusMin, breakMin, timingRev | ממשק

DND במבחן; סטריק וסטטיסטיקה; 3 מטלות למסך שיעורי הבית | examMode, nextExamDays, nextExamTitle, streakDays, weekFocusMin, hwStr | מצבים ונתונים
6.4 ראו — poll לכל אחת פקודה | cmdId, cmdType, cmdArg, cmdText | פקודות מרחוק

## 6.4 פרוטוקול הפקודות מרחוק — אמינות מעל polling

Web /device | Server (device_commands) | MindBox
sendDeviceCommand → INSERT (Queued)

GET /config (poll)
cmdId=12 … (served_at, "Sent")
GET /config?ack=12 (מיידי | (
delivered_at ("Done") + | הבאה | הפקודה
UI (5 | רענון | s): Queued→Sent→Done

מנגנון ערך מה הוא פותר

פקודה אחת לכל תשובה + FIFO קפדני — סדר ביצוע מובטח; פקודה חדשה לא עוקפת ישנה שלא נמסרה

Ack ב-poll הבא + poll-re מיידי <id=<ack &אישור מסירה; צרור פקודות מתנקז בקצב ~/1שנייה הגשה חוזרת של פקודה ללא ack אחרי 75 שניות אובדן תשובה ברשת; דדופ במכשיר לפי cmdId אחרון

תפוגה 10 דקות פקודה ישנה לא "תרדוף" מכשיר שחזר לרשת ניקוי ב-unpair + סינון לפי בעלים — פקודות של בעלים קודם לעולם לא מגיעות לבעלים חדש

)5 ממתינות ⇒ דחייה מכשיר כבוי לא צובר תור אינסופי לחץ-חוזר )backpressure≥

## 6.5 קצבים, timeouts ועמידות רשת

קבוע ערך הערה

לצימוד כשמחכים מהיר | 60s (paired) / 5s (unpaired) / 3s (pairing) | קונפיגורציה Poll
לחיבור keep-alive גם | 30s + on-transition (3 מינימלי מרווח s) | טלמטריה
| | timeouts HTTP s3 total / s1.5 connect בקשה תקועה לא מקפיאה את המשימה
| | Backoff אחרי כשל מעריכי )תור העלאות( m5→s5) · רשת) s30
בפיתוח שאובחנו lwip pbuf לקריסות הפתרון | HTTPClient יחיד, setReuse(true) | Keep-alive
מקומית לתצוגה מהשרת tzOffsetMin ; פנימי UTC | pool.ntp.org, sync 12 כלh | NTP
| | גודל תשובה מקסימלי 8192 BODY_MAX_HTTP מוגדל פעמיים ככל שה-downlink גדל )4096→6144→8192(

# .7 צד האתר: איך כל נתון נקלט, נשמר ומוצג

## 7.1 שני נתיבי דאטה, נקודת כניסה אחת

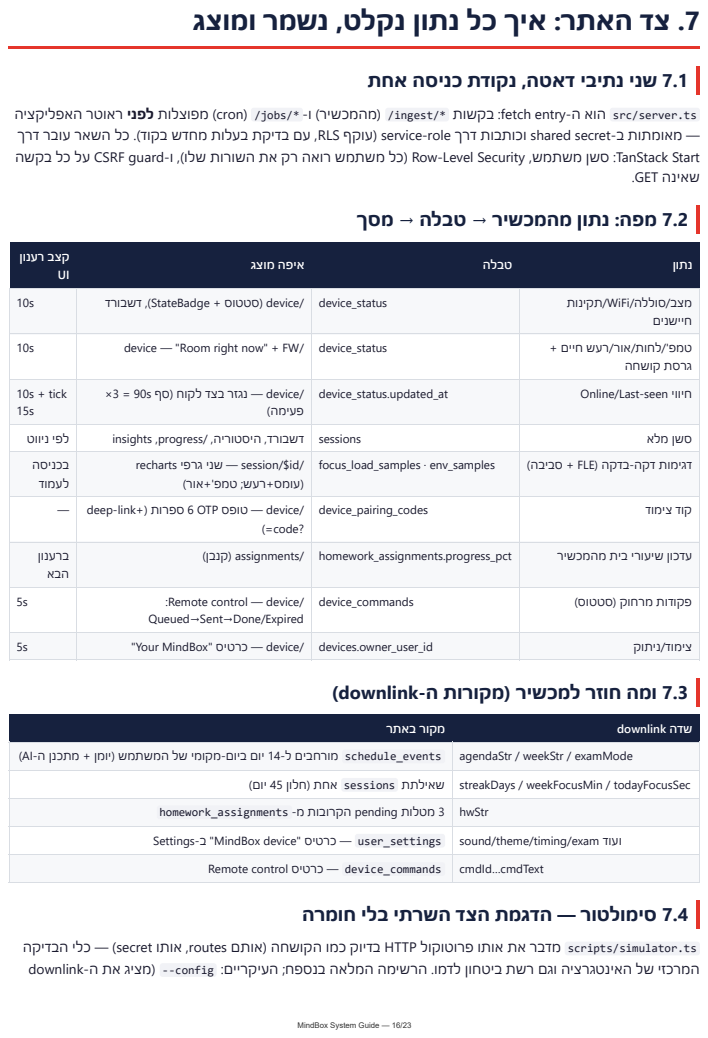
[picture p12: page 16]
שאינה GET.; קצב רענון UI

ts.server/src הוא ה-entry fetch: בקשות */ingest/( מהמכשיר( ו- */jobs/( cron )מפוצלות לפני ראוטר האפליקציה
— מאומתות ב-secret shared וכותבות דרך role-service( עוקף RLS, עם בדיקת בעלות מחדש בקוד(. כל השאר עובר דרך
Start TanStack: סשן משתמש, Security Level-Row( כל משתמש רואה רק את השורות שלו(, ו-guard CSRF על כל בקשה

7.2 מפה: נתון מהמכשיר → טבלה → מסך

נתון טבלה איפה מוצג

10s | דשבורד ,(StateBadge + סטטוס )device/ | device_status | מצב/סוללה/WiFi/תקינות חיישנים

10s | device — "Room right now" + FW/ | device_status | טמפ'/לחות/אור/רעש חיים + גרסת קושחה

10s + tick 15s | ×3 = 90s סף ) לקוח בצד נגזר — device/ פעימה( | device_status.updated_at | Online/Last-seen חיווי

סשן מלא sessions דשבורד, היסטוריה, /progress, insights לפי ניווט
בכניסה לעמוד | recharts גרפי שני — session/$id/ )עומס+רעש; טמפ'+אור( | focus_load_samples · env_samples | ) סביבה + FLE( בדקה -דקה דגימות

— | deep-link+( ספרות 6 OTP טופס — device/ )=code? | device_pairing_codes | צימוד קוד

הבא | | | עדכון שיעורי בית מהמכשיר pct_progress.assignments_homework /assignments( קנבן( ברענון

5s | :Remote control — device/ Queued→Sent→Done/Expired | device_commands | ) סטטוס ) מרחוק פקודות

5s | "Your MindBox" כרטיס — device/ | devices.owner_user_id | ניתוק / צימוד

7.3 ומה חוזר למכשיר )מקורות ה-downlink)

שדה downlink מקור באתר

examMode / weekStr / agendaStr events_schedule מורחבים ל14- יום ביום-מקומי של המשתמש )יומן + מתכנן ה-AI)

todayFocusSec / weekFocusMin / streakDays שאילתת sessions אחת )חלון 45 יום(

homework_assignments -מ הקרובות pending מטלות 3 | hwStr
Settings-ב" MindBox device" כרטיס — user_settings | sound/theme/timing/exam ועוד

Remote control כרטיס — device_commands | cmdId…cmdText

7.4 סימולטור — הדגמת הצד השרתי בלי חומרה

ts.simulator/scripts מדבר את אותו פרוטוקול HTTP בדיוק כמו הקושחה )אותם routes, אותו secret — )כלי הבדיקה
המרכזי של האינטגרציה וגם רשת ביטחון לדמו. הרשימה המלאה בנספח; העיקריים: config--( מציג את ה-downlink

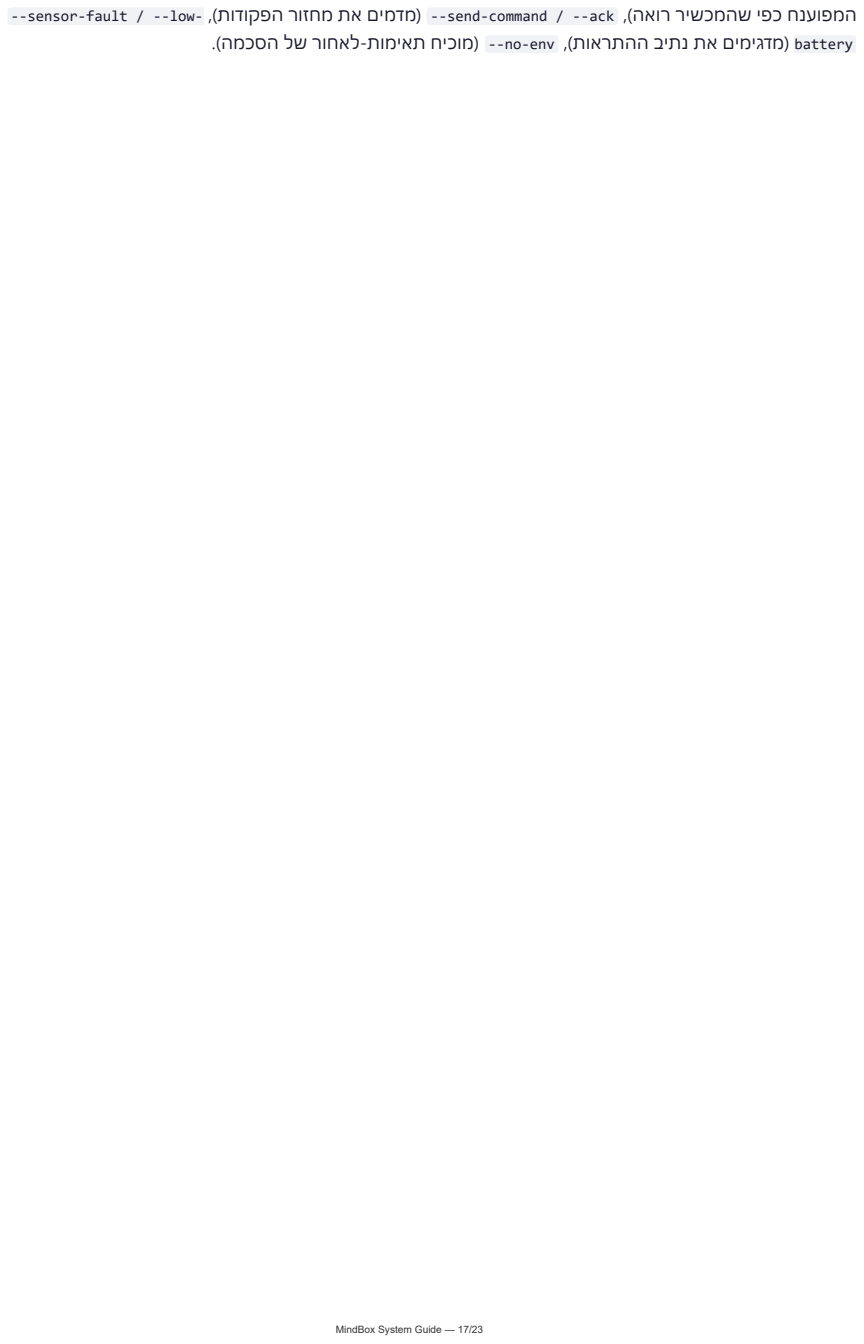
[picture p13: page 17]

המפוענח כפי שהמכשיר רואה(, ack-- / command-send--( מדמים את מחזור הפקודות(, -low-- / fault-sensor--

battery( מדגימים את נתיב ההתראות(, env-no--( מוכיח תאימות-לאחור של הסכמה(.

# .8 לקחים הנדסיים — הבעיות האמיתיות שפתרנו

הפרק הזה הוא התשובה הישירה לחשש "עיקר המורכבות בתוכנה": אלה תקלות חומרה אמיתיות שאובחנו במעבדה, עם שיטת האבחון והפתרון — עומק חומרתי שאי אפשר לזייף.

## 8.1 Brownout — קריסות בעת התחברות WiFi

תסמין ריסטארטים חוזרים ברגע שה-WiFi מתחבר; בהמשך — מסך שחור לגמרי )הלוח לא עולה( כשהוסיפו קודק+ToF ל-inrush

של בזרם הזינוק : ההצלבה ; Serial-ב E BOD: Brownout detector was triggered לולאת + esp_reset_reason() המשדר מפיל את קו ה-V5 מיציאת USB חלשה של לפטופ | אבחון
()setup , כך שנפילת-מתח בשלב ה-boot מתרחשת לפני הקוד שלנו; השתקה רק הופכת ריסטארט נקי לתקיעה שחורה. הוחזר ל0- במודע | לקח מרכזי ניסיון "לכבות את הגלאי" בקוד ) DETECTOR_BROWNOUT_DISABLE ) לא עוזר ומזיק: IDF-ESP חומש את הגלאי לפני
)1( (dBm8.5(setTxPower.WiFi — מרכך את זינוק ההתחברות; )2( כל קריאות ה-WiFi על ליבה 0 בלבד; )3( הקטנת זרם ה-(4) ;boot ספק V5 חזק )מטען קיר A+2 — )הפתרון האמיתי היחיד; )5( סיבת האיפוס מוצגת על מסך ה-boot כדי לאבחן בלי מחשב | פתרונות אמיתיים

## 8.2 מיקרופון שמחזיר אפסים — קודק בלי שעון ADC

המיקרופון "עבד" )S2I רץ, אין שגיאות( אבל החזיר 0 קבוע. האבחון בכלי probe::Audio( פקודת a) : הקודק עונה ל-ACK אבל 0=max=min. שורש: רגיסטר ניהול השעונים של 8311ES( 01x0 )לא הפעיל את שעון ה-ADC. התיקון — F3x0=01x.0 לקח: בקודקים, "אין שגיאה" =/ "עובד"; חובה כלי probe שמראה דגימות גולמיות.

## 8.3 מלחמת ה-C2I — שלושה התקנים, שני masters, באס אחד

גרסה מוקדמת הריצה את המגע דרך LovyanGFX( master פנימי( ואת ה-ToF דרך Wire — שני masters על אותם פינים ⇒ המגע מת. הפתרון: master יחיד )Wire )עם דרייבר 6336FT שנכתב מאפס, קודק מתוכנת ב-C2I-soft רק בזמן boot, ו-watchdog שמזהה באס תקוע ומריץ ריקברי )9 STOP + clocks). לקח קלאסי של אינטגרציית חומרה: הבעיה לא בהתקנים — בבעלות על הבאס.
lwip pbuf double-free — | אקראיות | רשת | קריסות | 8.4

בחיבור ממושך הופיעו קריסות free_pbuf אקראיות. הטיפול: אובייקט HTTP יחיד עם (true(setReuse( חיבור alive-keep אחד במקום פתיחה/סגירה בכל בקשה(, בקשה אחת בכל מעבר של משימת הרשת, reconnect ידני מסודר במקום autoReconnect שרץ מ-context ISR. מאז — יציב.

## 8.5 פין אחד, שני תפקידים )21IO — )כשנשארו 4 פינים

כשנגמרו הפינים, 11DHT וכפתור הצד אוחדו על 21IO תוך ניצול העובדה שה-up-pull של ה-DHT הוא בדיוק ה-up-pull שהכפתור צריך, בתוספת חוק תוכנה: אין קריאת DHT בזמן לחיצה. תכנון משאבים תחת אילוץ אמיתי של הלוח.

## 8.6 מגבלות ידועות )בכנות(

מגבלה סטטוס

פונטים במסך הם ASCII — כותרות בעברית מהלו"ז לא מוצגות בטקסט מלא ידוע; פתרון עתידי: פונט עברי או תעתוק בצד השרת

11DHT — דיוק לחות ±5% והקריאה מדלגת כשהכפתור לחוץ מוצג "—" כשאין קריאה תקפה

סוללה לא מחווטת )0 BATTERY_HAS )המדד באתר מוסתר מאחורי flag-feature secret משותף אחד לכל המכשירים מקובל לפרויקט קורס; מתועד ב-md.ASSUMPTIONS שיהוי פקודות עד 60 שניות )polling )מוצג במפורש ב-UI ;תכנון מכוון )ראו 6.1(

# .9 פרק ההוכחות: טענה → הדגמה חיה → איפה רואים

העיקרון שקיבלנו מהצוות המנחה: כל טענה חייבת דרך הצגה ואימות. הטבלה הזו עוברת טענה-טענה; כל שורה ניתנת לביצוע בזמן אמת מול הקהל, בלי הכנה מוקדמת מעבר למכשיר דלוק + מחשב עם Serial + האתר פתוח.

## 9.1 טבלת ההוכחות

# הטענה ההדגמה החיה איפה רואים את התוצאה

נקודת Online ירוקה; ערכי "now right Room "מתעדכנים; כיבוי המכשיר ⇒ "seen Last "תוך 90 שניות | לפתוח device/ ליד המכשיר ולחכות | שניות | 1 המכשיר מדווח לענן כל 30
[mon ;[הערך באתר בפעימה הבאה | | | 2 מיקרופון S2I אמיתי מודד רעש מחיאת כף / דיבור חזק ליד הקופסה Serial a : RMS קופץ; מסך Diag: pp קופץ; dB בשורת
חיווי Away על הטיימר | | | 3 חיישן מרחק ToF מזהה נוכחות להזיז יד קדימה/אחורה מול החיישן Serial m : Nmm=dist משתנה חי; התרחקות בזמן סשן ⇒
now "בהמשך | | | 4 טמפרטורה ולחות נמדדות נשיפה חמה על ה11-DHT הטמפ' עולה ב-Diag/Serial תוך שניות וב-"right Room
)brightness | לכסות את החיישן ביד ה-lux צונח ב-Diag ;המסך מתעמעם פיזית )-auto | אוטומטית | 5 חיישן אור עובד ומפעיל בהירות
עמוד id/$session/ באתר: גרף עומס+רעש לאורך הדקות + ספירת ההפרעות — הנתונים שנאספו הרגע | להריץ סשן קצר עם רעש מכוון והתרחקות אחת | ומגיעות לענן דגימה-בדגימה | 6 ההפרעות משפיעות על הסשן
אמת בזמן Queued→Sent→Done | | | 7 האתר שולט במכשיר מרחוק "device my Ring "מ/-device המכשיר מצלצל תוך ≥60 שניות; באתר הסטטוס עובר
צבעי המסך מתחלפים בכל המכשיר תוך ≥60 שניות | להחליף ערכת צבעים )Screen Settings-ב( theme | למכשיר | 8 שינוי הגדרה באתר מגיע
את כל השבוע | | | 9 הלו"ז מהאתר חי על המכשיר להוסיף אירוע להיום ביומן האתר מסך Today במכשיר מציג אותו ב-poll הבא; דפדוף מציג
בהגיע הזמן: צליל + ספלאש "cancel to tap "10 שניות ⇒ הסשן מתחיל לבד | לקבוע בלוק לימוד שמתחיל בעוד 2–3 דקות | הלו"ז | 10 המכשיר מתחיל סשן לבד לפי
/assignments באתר מציג את האחוז החדש | לסיים סשן עבודה ⇒ מסך שיעורי הבית ⇒ נגיעה +25% | האתר | 11 המכשיר כותב חזרה לדאטה של
Serial q : הסשן בתור; אחרי חיבור — מופיע באתר עם הזמנים הנכונים )תוקנו ע"י NTP) | שלם, להדליק חזרה | | 12 עבודה offline מלאה + סנכרון לכבות את הראוטר, להריץ סשן
sensorHealth בטלמטריה ⇒ שורת Fault אדומה danger עובר StateBadge ;device/-ב | לנתק פיזית את ה-DHT( או --) בסימולטור sensor-fault | לא נבלעת | 13 תקלת חיישן מזוהה ומדווחת,
המכשיר עולה עם "session Resume "?מה-checkpoint; מסך ה-boot מציג את סיבת האיפוס | לנתק את ה-USB באמצע סשן ולחבר | סשן | 14 שרידות ניתוק חשמל באמצע
401 — הצגת האימות; עם ה-header — ה-JSON המלא | לנסות curl ל/-config/ingest בלי ה-header | המכשיר | 15 העברת דאטה מוצפנת בזהות

## 9.2 תסריט דמו מומלץ )~10 דקות(

דקות שלב שורות מפתח

)29x38+0x0), ToF, מיקרופון, אור, טמפ' | | 1–0 הדלקה מול הקהל breadcrumbs boot על המסך, צליל boot( רמקול חי(, selfTest ב-Serial מראה סריקת C2I
הזזת יד )מרחק(, מחיאת כף )רעש(, כיסוי אור )עמעום מסך(, נשיפה )טמפ'( — הכול בשורה מתעדכנת אחת | m Serial | 3–1 "החיישנים חיים" —
| | 5–3 סשן חי עם הפרעות התחלת סשן, רעש מכוון ⇒ אייקון + התראה קולית; התרחקות ⇒ Away ;בסיום — סיכום על המכשיר
| | 7–5 הדאטה בענן /id/$session — גרפי הדקה-בדקה של הסשן שהרגע הסתיים; /device — now right Room חי
המכשיר | | 9–7 שליטה מרחוק דו-כיוונית device my Ring( עם סטטוס Done→Sent→Queued), החלפת theme, הוספת אירוע ליומן ⇒ מופיע על
האמיתי" | עומק הנדסי שקף ה-(8.1) brownout + ניתוק חשמל חי באמצע סשן ⇒ Resume" — המערכת שורדת את העולם | 9– 10

גיבוי לדמו בלי חומרה: כל נתיב שרת ניתן להדגמה עם הסימולטור )נספח 10.2( — כולל מחזור הפקודות המלא )--
.חיישן | תקלת | / | חלשה | סוללה | ותרחישי | ( Done ⇒ --ack ⇒ Sent ⇒ --config ⇒ | באתר | Queued ⇒ send-command

# .10 נספחים

## 10.1 פקודות קונסולת ה-Serial( 115200)

פקודה מה היא עושה

| m מוניטור Hz:1 מצב, טיימר, נוכחות+מרחק, רעש, אור, טמפ', ToF, WiFi, כפתור, תקלות, תורים
| d אותו dump — חד-פעמי
מהמיקרופון גולמיים min/max/DC/AC-RMS + הקודק של ACK :Audio probe | a
| k / t בדיקת מגע חיה )crosshair )/ כיול מגע מחדש
| b בדיקת כפתור חיה 8 שניות )21IO)
מאפס c reset ;מכוון c noise|db|light|lightvar|temp <v> ;מציג c : חיישנים כיול | c
| q מצב תור ההעלאות )ממתינים / הוותיק ביותר / הושלכו(
| w הגדרת WiFi / כתובת שרת / secret מה-Serial
| h עזרה

בנוסף: selfTest מלא רץ בכל boot ומדפיס — גרסה, סיבת איפוס, זיכרון/PSRAM, סריקת C2I, מרחק ToF, בדיקת מיקרופון, אור, טמפ', WiFi ורשימת הפקודות.

) bun run simulate -- ... ( | הסימולטור | דגלי | 10.2

דגל מה מדגים

| (ללא דגל) זריעת מכשיר + ~30 יום של סשנים + טלמטריה רציפה
שבוע, theme, פקודה ממתינה...( | config-- מדפיס את ה-downlink המלא מפוענח — בדיוק מה שהמכשיר רואה )לו"ז,
מחזור פקודה מלא מול הסטטוסים באתר | --send-command=<type>[:<arg>][:<text>] / --ack= <id>
| <pct<:>uuid=<homework-- עדכון מטלה "מהמכשיר"
| sync-then-offline-- צבירת סשנים ואז סנכרון בבת אחת )תרחיש חזרת-רשת(
| fault-sensor-- / battery-low-- StateBadge אזהרה/תקלה + באנר סוללה באתר
| env-no-- טלמטריה בלי שדות סביבה — הוכחת תאימות-לאחור
שליטה בזהות ובקצב; cleanup run bun מנקה | --user= / --device= / --ticks= / --interval= / --seed-only / --no-sessions

## 10.3 שדות ה-Downlink — רפרנס מלא )config/ingest/ GET)

שדה טיפוס/טווח תפקיד

| paired bool האם המכשיר משויך לחשבון
bool הגדרות ליבה | showTimer, hapticsEnabled, adaptiveCoaching, nudgesEnabled
| quietEndMin / quietStartMin 65535 / 1439–0 שעות שקט )דקות מחצות; 65535=כבוי(

המקומי( | | todayFocusSec ,dailyGoalMin int יעד יומי + הפוקוס שנצבר היום )לפי היום
| | ownerEmail ,ownerDisplayName B19/31 ≤str ברכת בעלים על המסך )מחוטא(
מקומיים | | tzOffsetMin int אזור זמן המשתמש — כל חישובי "היום"
| | agendaStr 12;…" ≤title|kind|end|start "לו"ז היום )מסך Today + התחלה אוטומטית(
ימים +1..+6 לדפדוף | "day|start|end|kind|title;…" ≤36, יום10/≥ | weekStr
1=סיום 2=מתוזמן 3=התראות | bool / bits / 2–0 / bool סאונד בבעלות האתר; mask: 0=לייפסייקל | soundEnabled, soundLevel, chimeMask, autoStartEnabled
ובאתר( | | themeId 4–0 ערכת צבעים )טבלת presets זהה בקושחה
| | timingRev ,breakMin ,focusMin epoch / 60–1 / 120–5 זמני פומודורו; מאומצים פעם אחת לכל revision
+ ) מבחן ביום אוטומטי או ידני ) במבחן DND באדג' ספירה | bool / −1..365 / str ≤23B | examMode, nextExamDays, nextExamTitle
| | weekFocusMin ,streakDays int סטריק ודקות השבוע למסך הסטטיסטיקה
| | hwStr 3;…" ≤pct|title|uuid "מטלות למסך העדכון המהיר
ring=5 end=4 start=1( אחת מרחוק פקודה )message=6 | int / 1..6 / int / str ≤40B | cmdId, cmdType, cmdArg, cmdText
כללי חיטוי לכל מחרוזת: הסרת ; | \ " ותווי בקרה + קיטום לפי בתים של -8UTF( מודול משותף ts.string-device + בדיקות יחידה( — כי
הפרסר בקושחה מינימלי בכוונה.

## 10.4 בדיקות אוטומטיות

שכבה מה

לקושחה( | יחידה )אתר( 278 בדיקות vitest — כל ה-encoders של פרוטוקול המכשיר, לוגיקת לו"ז/סטריק/מתכנן, load-focus( זהה
הסימולטור מדבר את ה-HTTP האמיתי מול השרת האמיתי | אינטגרציה בלי חומרה
| קושחה קומפילציה נקייה )0 אזהרות( ב-cli-arduino ;selfTest חומרתי בכל boot ;קונסולת אבחון

## 10.5 מסמכים משלימים בריפו

| md.ASSUMPTIONS/docs כל ההנחות והספים של פיצ'רי ה-AI וממשק המכשיר
)LaTeX( אתר-וארכיטקטורת מוצר מסמכי | docs/MindBox-Product-Overview.tex · MindBox-System-Architecture.tex
) בעץ המוסמך המקור ) העדכנית הקושחה מפת | MindBox - hardware ESP32 S3 screen/MindBox/CLAUDE.md
| md.README התקנה, מיגרציות, סימולטור, פיצ'רי אתר↔מכשיר
. npx tsx scripts/build-system-doc.ts | והריצו | הרלוונטי | הפרק | את | ערכו | :עדכון | ; docs/system-guide/*.html -מ | נבנה | זה | מסמך
