royavidan/IOT-Project-study-assistor/code.ino

#include <Adafruit_VL53L1X.h>
#include <ComponentObject.h>
#include <RangeSensor.h>
#include <vl53l1x_class.h>
#include <vl53l1x_error_codes.h>

#include <Adafruit_VL6180X.h>

#include <Adafruit_SSD1306.h>
#include <splash.h>

#include <Adafruit_SH110X.h>

#include <Adafruit_GFX.h>
#include <Adafruit_GrayOLED.h>
#include <Adafruit_SPITFT_Macros.h>
#include <Adafruit_SPITFT.h>
#include <gfxfont.h>

#include <Adafruit_BusIO_Register.h>
#include <Adafruit_GenericDevice.h>
#include <Adafruit_I2CDevice.h>
#include <Adafruit_I2CRegister.h>
#include <Adafruit_SPIDevice.h>

#include "Wire.h"


void setup() {
    
}

void loop() {
    
}
