royavidan/IOT-Project-study-assistor/MindBox - hardware ESP32 S3 screen/MindBox/src/Storage.h

#pragma once
// ============================================================================
// Storage — non-volatile state (ESP32 NVS via Preferences). Survives power
// cycles (Story 4): device id, work/break durations, sequence counter, the
// downlinked DeviceConfig, and an offline session log.
// ============================================================================
#include "types.h"

namespace Storage {
  void begin();
  String deviceId();

  int  workDurationMin();
  int  breakDurationMin();
  void setWorkDuration(int m);
  void setBreakDuration(int m);

  int  cycleCount();
  void setCycleCount(int n);

  uint32_t nextSeq();

  DeviceConfig loadConfig(const DeviceConfig& def);
  void saveConfig(const DeviceConfig& c);

  bool paired();
  void setPaired(bool p);

  bool darkTheme();          // UI theme: true = dark (default), false = light
  void setDarkTheme(bool d);

  uint8_t themeAccent();     // accent preset 0-4 (site downlink themeId; 0 = original red)
  void    setThemeAccent(uint8_t p);

  uint32_t lastTimingRev();  // last adopted site focus/break revision (epoch-sec, 0 = never)
  void     setLastTimingRev(uint32_t rev);

  void factoryReset();       // wipe the whole NVS namespace; caller reboots

  void setOwnerAccount(const char* displayName, const char* email);
  void clearOwnerAccount();
  String ownerDisplayName();
  String ownerEmail();

  // Provisioning (entered over serial, persisted in NVS).
  String wifiSsid();     void setWifiSsid(const String& s);
  String wifiPass();     void setWifiPass(const String& s);
  String appBaseUrl();   void setAppBaseUrl(const String& s);
  String deviceSecret(); void setDeviceSecret(const String& s);

  void saveSessionLog(const SessionRecord& r);
  SessionLogEntry lastSessionLog();
  bool            sessionLogAt(int index, SessionLogEntry& out); // 0 = newest
  uint32_t        totalFocusSec();
  int             sessionLogCount();
  void            recordSetComplete();
  int             todaySetsCount();

  void saveCheckpoint(const SessionCheckpoint& cp);
  bool loadCheckpoint(SessionCheckpoint& cp);
  void clearCheckpoint();
  bool hasCheckpoint();

  bool bufferSession(const SessionRecord& r);   // returns true if daily goal hit

  void     setLiveFocusSec(uint32_t sec);
  void     setServerTodaySec(uint32_t sec);   // account-wide today total from the server
  void     bumpServerTodaySec(uint32_t sec);  // optimistic add after a local session
  uint32_t todayFocusSec();       // persisted completed WORK focus today (local fallback)
  uint32_t todayDisplaySec();     // server today (online) or local today, + live in-progress
  int      todayFocusCount();
  void     resetToday();
  void     syncDayBoundary();

  int  bufferedCount();

  // Upload-queue overflow flag (single NVS namespace — do not open a second Preferences).
  bool uploadQueueDropped();
  void setUploadQueueDropped(bool v);
  void clearUploadQueueDropped();

  uint8_t presenceSensIdx();   // presence estimator sensitivity (same key saveConfig writes); for boot-time apply

  // Per-desk sensor calibration (NVS; adjust over serial — Diagnostics 'c' command).
  float noiseFullScale();
  void  setNoiseFullScale(float v);
  float noiseDbOffset();               // dBFS -> dB SPL calibration offset
  void  setNoiseDbOffset(float v);
  float lightLuxScale();
  void  setLightLuxScale(float v);
  float lightVarScale();
  void  setLightVarScale(float v);
  float tempOffsetC();
  void  setTempOffsetC(float v);
  void  resetSensorCalibration();
}
