royavidan/IOT-Project-study-assistor/MindBox - hardware ESP32 S3 screen/MindBox/src/TimerScreen.h

#pragma once
// ============================================================================
// TimerScreen — the RUNNING-state renderer (Tomato32 styling), model-driven.
//   USE_TOUCH 1 : centred numerals inside a smooth phase-coloured progress ring (fillArc + rounded caps)
//   USE_TOUCH 0 : centred numerals inside a dotted progress ring
// Everything is derived from the UiModel; no session state of its own.
// ============================================================================
#include "config.h"
#include "types.h"

namespace TimerScreen {

// Touch control hit-test result (touch build only).
enum TimerAction { TA_NONE = -1, TA_RESET = 0, TA_PAUSE = 1, TA_SKIP = 2, TA_MENU = 3 };

void render(const UiModel& m);

#if USE_TOUCH
int hitTest(int x, int y);   // a TimerAction, or TA_NONE
#endif

} // namespace TimerScreen
