royavidan/IOT-Project-study-assistor/(commit log)

2026-06-10 We've fixed minor bugs added a feature to send email when we send friend request and added calendar so a student will be able to have a track of their entire system
2026-06-11 Added temperature and light sensor to the system
2026-06-12 Fixed vibration motor + working on integrated daily goal
    [Cloud.cpp, Diagnostics.cpp, Haptics.cpp, Haptics.h, Inputs.h, Menu.cpp, MindBox.ino, StateMachine.cpp]
2026-06-12 Device page includes Username + email
2026-06-12 Applied system optimization to prevent sudden crashes
    [StateMachine.cpp, Storage.cpp, config.h]
2026-06-23 Add ESP32-S3 screen firmware port, demo-day docs; fix .gitignore
    - Port MindBox firmware to the ESP32-S3 TFT+touch board (new folder)
    - Add hardware docs (CLAUDE.md, HARDWARE.md) and demo-day materials
    - Update Cloud.cpp on the classic-ESP32 firmware
    - .gitignore: ignore Office lock files (~$*), all SECRETS.h, and
    understand-anything output. The locked ~$*.pptx files were causing
    git to abort with 'fatal: adding files failed', which silently
    blocked every commit and push from the VSCode UI.
    [Cloud.cpp, Cloud.h, Diagnostics.cpp, Diagnostics.h, Display.cpp, Display.h, DotFont.h, Haptics.cpp]
2026-06-23 ESP32 S3 - update
2026-06-24 Bug fixes mic doesn't work tof doesn't work there are many panic crushes
    [Audio.cpp, Audio.h, Cloud.cpp, Diagnostics.cpp, Diagnostics.h, Menu.cpp, MindBox.ino, Sensors.cpp]
2026-06-25 added the encoder (The current system is a bit laggy and doesn't respond well to the encoder integration)
    [Audio.cpp, Haptics.cpp, MindBox.ino, config.h, types.h]
2026-06-25 The encoder + rendering issue is solved + tof sensor works now
    [Diagnostics.cpp, Inputs.cpp, MindBox.ino, Panel.cpp, Panel.h, Sensors.cpp, config.h]
2026-06-26 The server connection is stable. ToF is currently missing though
    [Cloud.cpp, Inputs.cpp, Menu.cpp, MindBox.ino, Panel.cpp, Sensors.cpp, Session.cpp, StateMachine.cpp]
2026-06-26 The ToF sensor is integrated in the system. It compromises the screen touch as they share the same source.
2026-06-28 Fixed keyboard problem + deployed the site + added a session block section to the site
    [Cloud.cpp, Diagnostics.cpp, Inputs.cpp, Keyboard.cpp, Touch.cpp, Touch.h, config.h]
2026-07-21 Add submission docs + demo-account seed; commit pending firmware/web changes
    submission/: DEMO-PLAN, ALGORITHM-EVALUATION, HARDWARE-LIBRARIES-SDK (per IOT course submission rules). scripts/seed-demo.ts seeds 5 demo accounts (history, leaderboard, homework, courses, schedule, reviewer grant). Plus pending firmware (config.h/StateMachine/Sensors/Payload) and web-app edits.
